tylerwhite26/ECE_455_Brain_Stimulator/Final_Report/Figures/thumbnail_IMG_1129.jpg

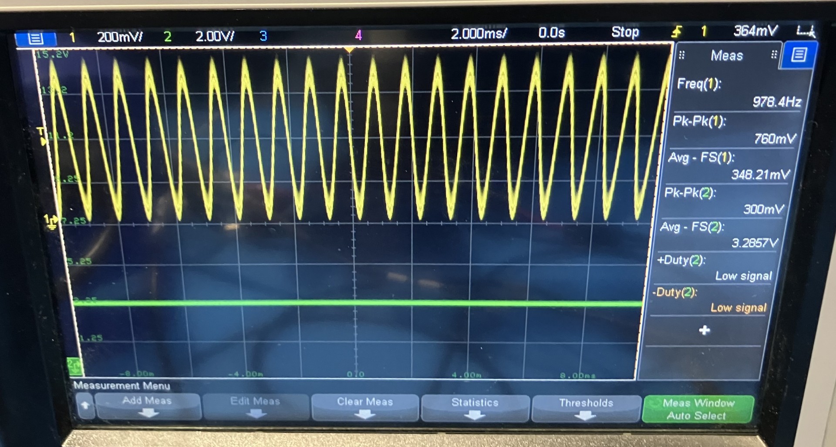
Final_Report/Figures/thumbnail_IMG_1129.jpg
