tylerwhite26/ECE_455_Brain_Stimulator/Final_Report/Hardware_Pics/3D_Annotate.png

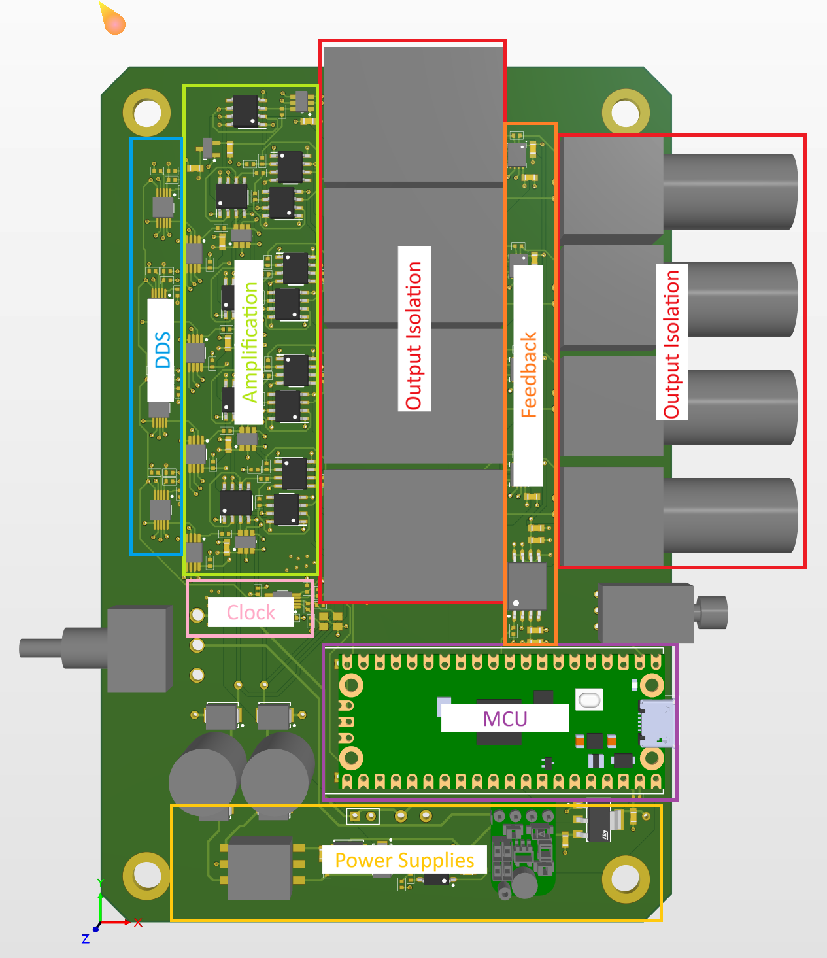
Final_Report/Hardware_Pics/3D_Annotate.png
