tylerwhite26/ECE_455_Brain_Stimulator/README.md

# ECE_455_Briain_Stimulator
Deep brain stimulator wave generator
