tylerwhite26/ECE_455_Brain_Stimulator/Final_Report/Tyler_Contributions.docx

Operating Instructions

Operation of the brain stimulator has been distilled down to only require two switches and the mobile app. The toggle switch serves as a power enable and hard kill switch, and the push toggle serves as the stimulation enable and ramp control.

To program the device, first turn the power on using the hard kill switch. Ensure the push toggle remains off (out). Connect to the device on the mobile app by pressing the “connect device” button. If connection is successful, the button will read “Connected” and turn green. During device selection on the mobile app, choose the device labeled “mpy-uart.” Once connected to the device, use the text boxes to select the desired channel frequencies. All channels are in units of hertz. As frequencies are chosen, beat frequencies will be calculated automatically and displayed on screen. Once all desired frequencies are present, press the “Program Device” button and wait for control to return. All frequencies programmed the device are written out to nonvolatile memory, and should persist between power cycles. At the completion of programming, the device is ready to generate stimulus.

To begin stimulus generation, ensure the device has been powered on using the hard kill switch, and then press and release the soft kill toggle button. It will latch in to show the stimulus is on. Once the stimulus has been turned on, it will ramp the output over a few seconds. There is not currently functionality for selecting amplitude on the mobile app, and it will be hard-coded into the software. Future releases should address this problem. To stop stimulation, press and release the soft kill switch again, causing the stimulus to ramp down over a few seconds back to zero. In the case of emergency, instead cut power using the hard kill switch. Note that a hard kill while stimulus is active may cause pain or discomfort to the patient.

Output channels go as an output and return pair at each BNC connector. These should be connected to electrodes to stimulate the brain. It is outside the scope of this project to determine electrode placement.

To change the software on the device, it must be disassembled and the main circuit board removed. Connect to the raspberry pi using USB-micro and reprogram. This port is kept intentionally concealed for normal operation to prevent tampering.

Hardware Selection

The main concerns for hardware selection are isolation, power dissipation, and max ratings. The output loops consist of a transformer, which is large to be tolerant up to 0.15 W power, and feedback ADCs. These ADCs isolate the analog and digital domains and are powered from an isolating 3.3 V supply so that the output loop does not reference to on board ground. This is done for signal integrity. The voltage feeding into these ADCs is over 10 ohm resistors, which have been sourced to be tolerant to up to 1 W.

Feeding into the output transformers are voltage controlled current sources consisting of two op-amps. These step up from the 5 V domain to the 30 V domain, and so are tolerant of input voltages well over 30 V. Resistors for these op-amps again need to be rated for very high power dissipation because current will be forced. Amplification stages leading into the current source consist of programmable resistor dividers feeding into buffers, which ensures signal fidelity and allows an easy way to control attenuation from the microcontroller. The source of sine wave generation is the DDS modules. Originally it was desired to use one DDS for all channels, but instead four smaller DDS modules are used to save money and space. They generate sine waves in the 2.5 or 3.3 V domain, which needs to then be stepped up to the 5 V domain using programmable gain amplifiers. These specifications lead to components in the amplification path being mostly buffer op-amps and programmable resistors that are all tolerant up to 5 V.

As the brains of the device, a raspberry pi pico has been chosen. Since we have broken out generation to DDS’s, the microcontroller only needs to communicate with peripheral devices. This means that it can be a simpler microcontroller, which also has Bluetooth to connect to the mobile app. Another motivation for choosing this microcontroller approach is that resources for writing software for raspberry pi are readily available, making iteration by researchers that may not know all the intricacies of the device easier.

To power the device, we have a rechargeable 3.6 V battery and charging board. We bought both of these pre-made. The main goal was to have something lightweight that is easily rechargeable, but at present the battery does not have enough capacity to generate stimulus for 16 hours. In the future, this component will need to be changed.

For generating high voltage on-board rails, there is both a 12 V and 30 V boost converter. The 12 V boost converter was again bought premade, but after testing will not source enough current for the device to operate. Future versions should source a better boost converter or go full custom. The 30 V boost converter was custom designed using a flyback converter. This converter, from our initial testing, draws a large amount of current at startup and may not be viable if attached directly to the 12 V boost converter. Further testing using the flyback breakout board on both the boost converter and voltage supply chain is necessary. The transformer currently used is also a concern.

Switches and connectors were the final components sourced. BNC connectors are used for the output channels. The goal of these connectors is to allow connection and disconnection of electrodes without soldering, while still providing an electrical connection that isn’t going to pull out and cause discomfort for the patient. The hard kill is a toggle switch to also function as a power on switch, but may be too easy to bump and kill the device. Future iterations should look into alternative hard kill switches. The soft kill switch is a push toggle button, which is smaller profile and gives a clear visual indication of whether stimulus is on.

Future Work

The biggest shortcoming of this device was the power supply circuitry. Specifically, the battery was too small and the boost converters did not function as intended.

Any new battery chosen should take into account the constant current draw of the boost converters, so that the device can reliably last 16 hours. Power calculations on the current board did not properly account for these converters. The boost converters themselves were mismatched; the 12 V boost supplied too little current, and the 30 V boost drew too much current. In the future, the best course of action is likely to go full custom with the 12 V boost converter in a similar fashion to the 30 V converter. This way, battery voltage can be directly connected to the 12 V converter, and the board powered from there. Another power issue was that the 5 V LDO could not thermally keep up with the load. Either a much bigger LDO or a different method of generating 5 V should be chosen in the future. Breaking out the power system into separate boards will allow faster debug and rework of these sections.

Another piece of future work is on the software side. The hardware will allow amplitude control through the amplifier stages, but there is currently no way to program the amplitude to the device. The mobile app and device software should be modified to allow for amplitude control. Due to the routing of the control signals, all channels currently ramp together. If it is desired to ramp these separately or set different amplitudes between channels, each amplifier will need individual routing, but the programmable gain amplifier can be removed.

Along with this, the on-board clock generator is too high a frequency to get good resolution from the DDS ICs. Either finding new DDSs or a new clock generator is necessary to achieve clarity to the level of individual hertz. The alternative is to program the clock generator for minimum frequency. A register-level value array is provided in the project source files for setting 100 kHz.

Physical dimensions end up being a limiting factor in the design of the brain stimulator. The device is too big to be reasonably handheld. In the future, pivoting away from large transformers on the output and finding alternative methods of output isolation will allow the footprint to shrink. Along with this, BNC outputs take up considerable space. Changing these out for hardwired electrodes or a different connector will allow the design to shrink further. Adding a belt clip to the back of the housing was an idea discussed but not implemented, which would make the device easier to carry for the patient. A final change on the physical dimension side is finding a new hard kill switch. It is hard to strike a balance between something that is accessible but can’t be accidentally switched off, as the toggle switch may be.

Overall, more extensive testing on board subcircuits needs to be performed. More breakout boards and small scale testing would give us reliable results to back up our simulations.

Hardware/Circuit Schematics (3 and 5)


Figure A shows the 3D layout of the PCB. It is divided into power supplies, MCU, clock, DDS, amplification, output isolation, and feedback. Horizontally each channel and its amplification stages are laid out in layers across the top of the board. The battery connects to headers directly below the MCU, and the 12 V boost converter, which is premade, attaches to the 4-pin footprint as shown.

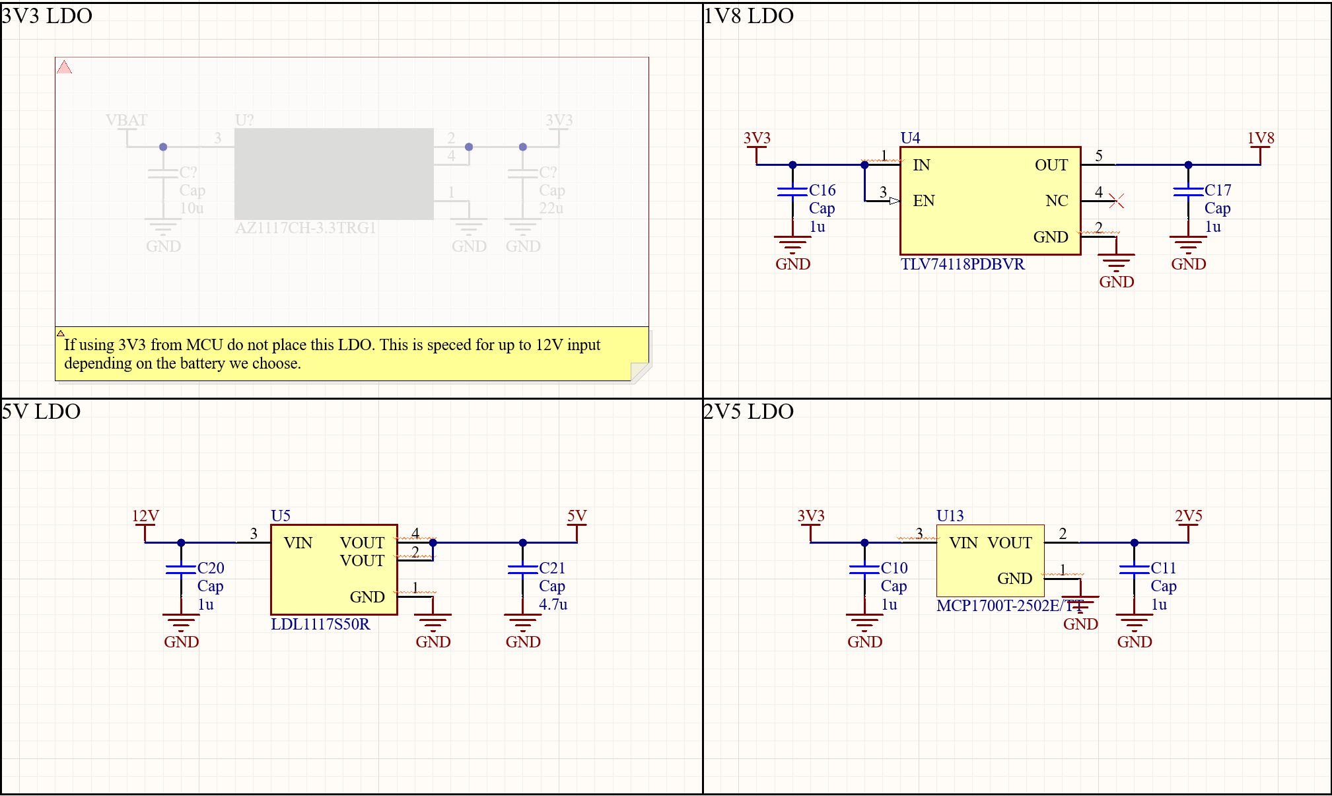
[picture p3: figure]

Figure B shows a schematic level view of the LDOs on-board. The 3.3 V LDO is optionally excluded, as the MCU will generate 3.3 V. 5 V feeds into the MCU, and 2.5 V is used for midpoint selection of the voltage controlled current source, explained later.

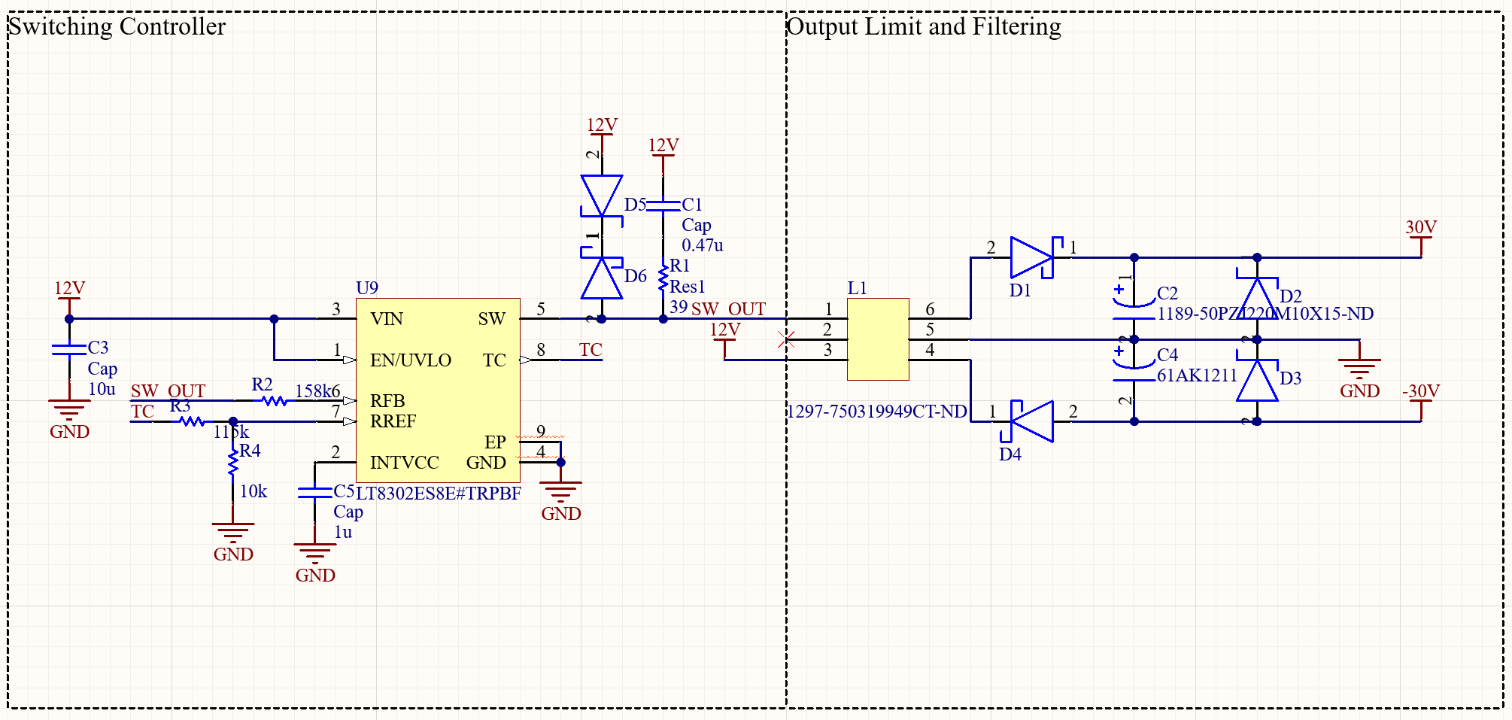
[picture p4: figure]

Figure C shows the 30 V flyback converter. It is divided into the switching controller in the 12 V domain and output filtering in the 30 V domain. The switching controller drives current on one direction through the transformer, which then uses Zener diodes on the secondary to generate a stable 30 V positive and negative rail at the output.

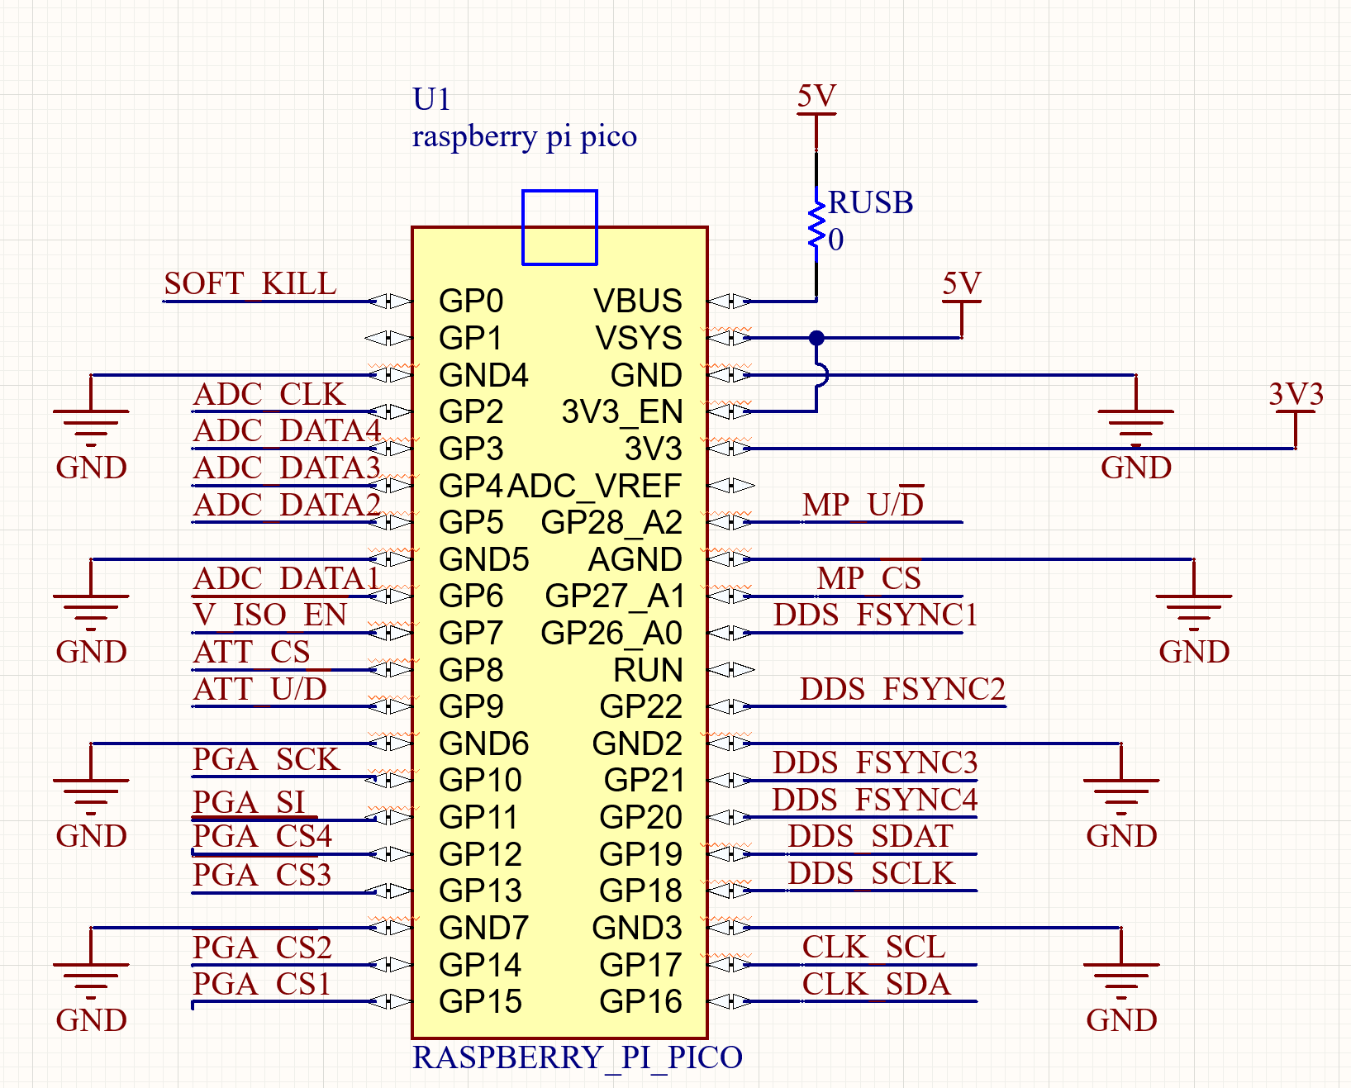
[picture p5: figure]

Figure D shows MCU connections. The main role of the MCU is to communicate with and program peripherals. To do this, it makes use of SPI, I2C, and custom up/down protocols. This MCU is the Raspberry Pi Pico, and can generate 3.3 V output for the rest of the board. The USB port of the MCU is hidden when in the housing so that it cannot be reprogrammed without taking it apart.

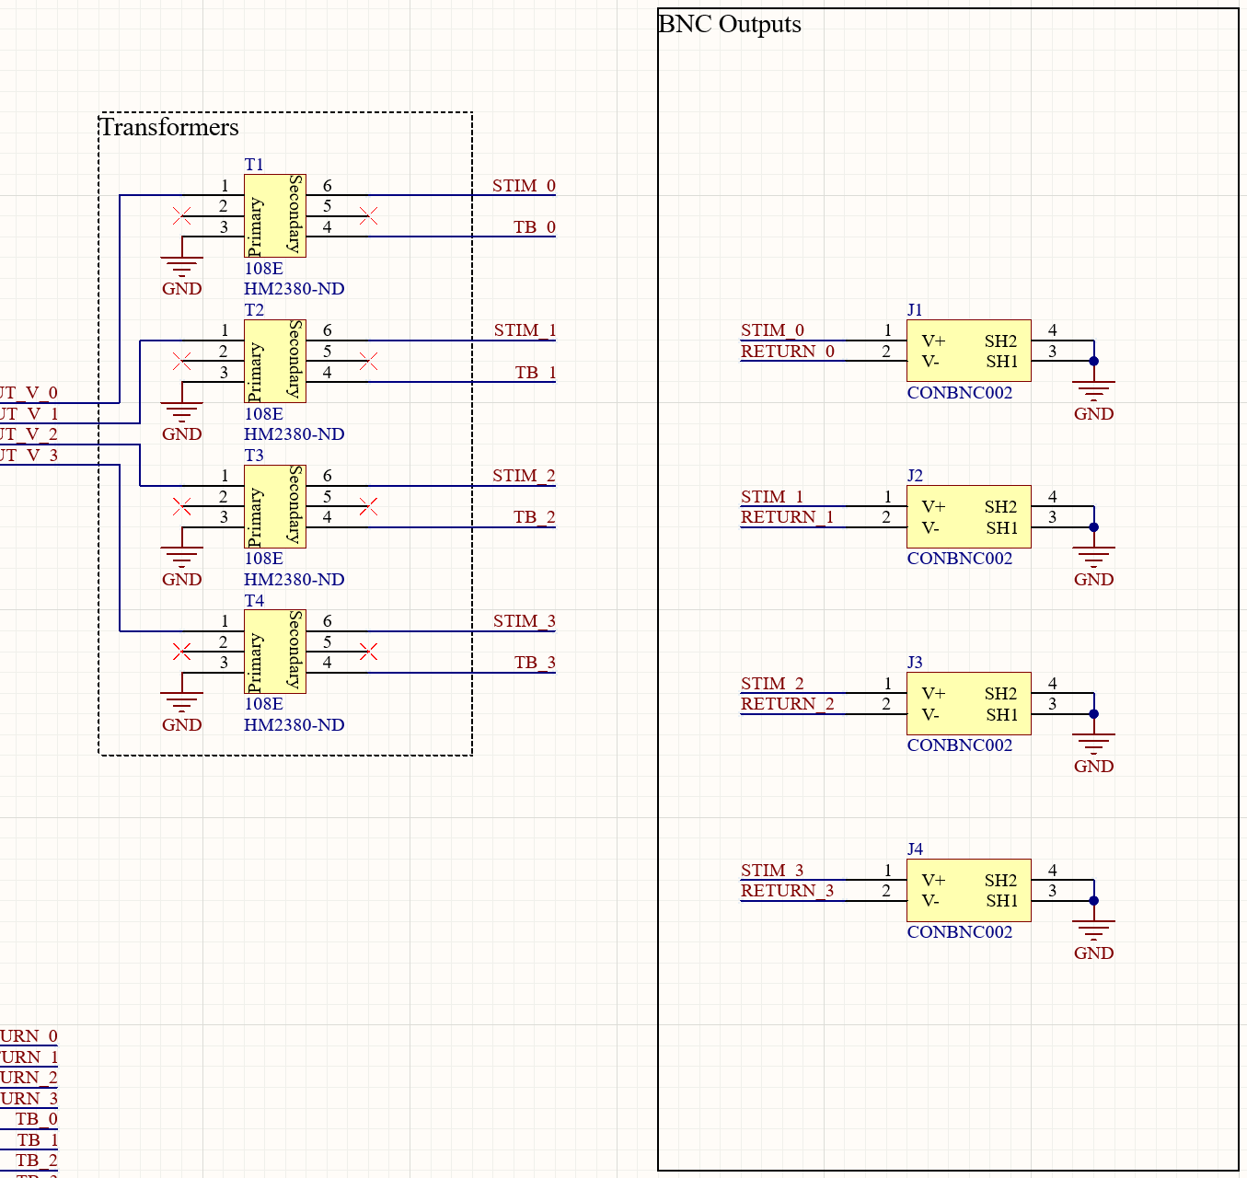
[picture p6: figure]

Figure E shows the isolation transformers and BNC outputs. These transformers are the biggest components on the board, responsible for isolating the current sources without dropping significant current. The transformers feed the signal into the BNC ports to connect to the electrodes. This signal then comes back through the ADCs and into the transformer.

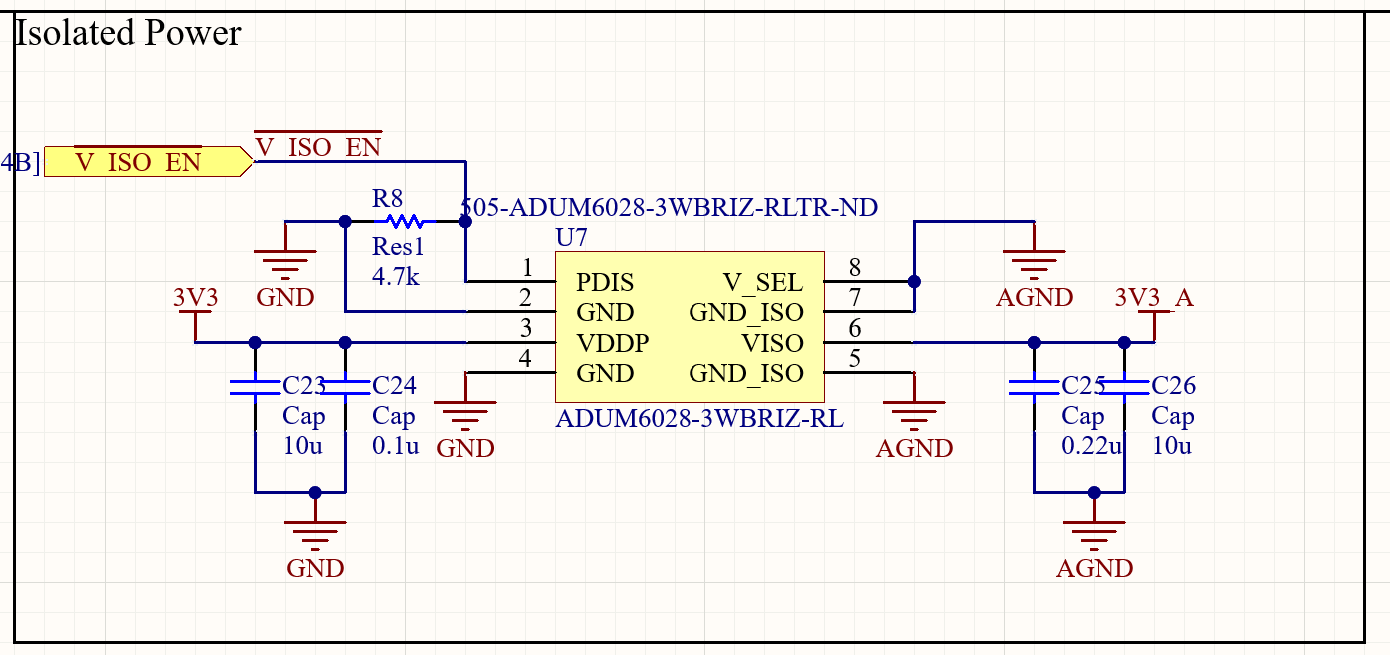
[picture p7: figure]

Figure F shows the isolated 3.3 V power supply. This supply is used for the analog domain of the ADCs so that they do not reference the on-board ground. This way, generated stimulus does not interfere between channels.

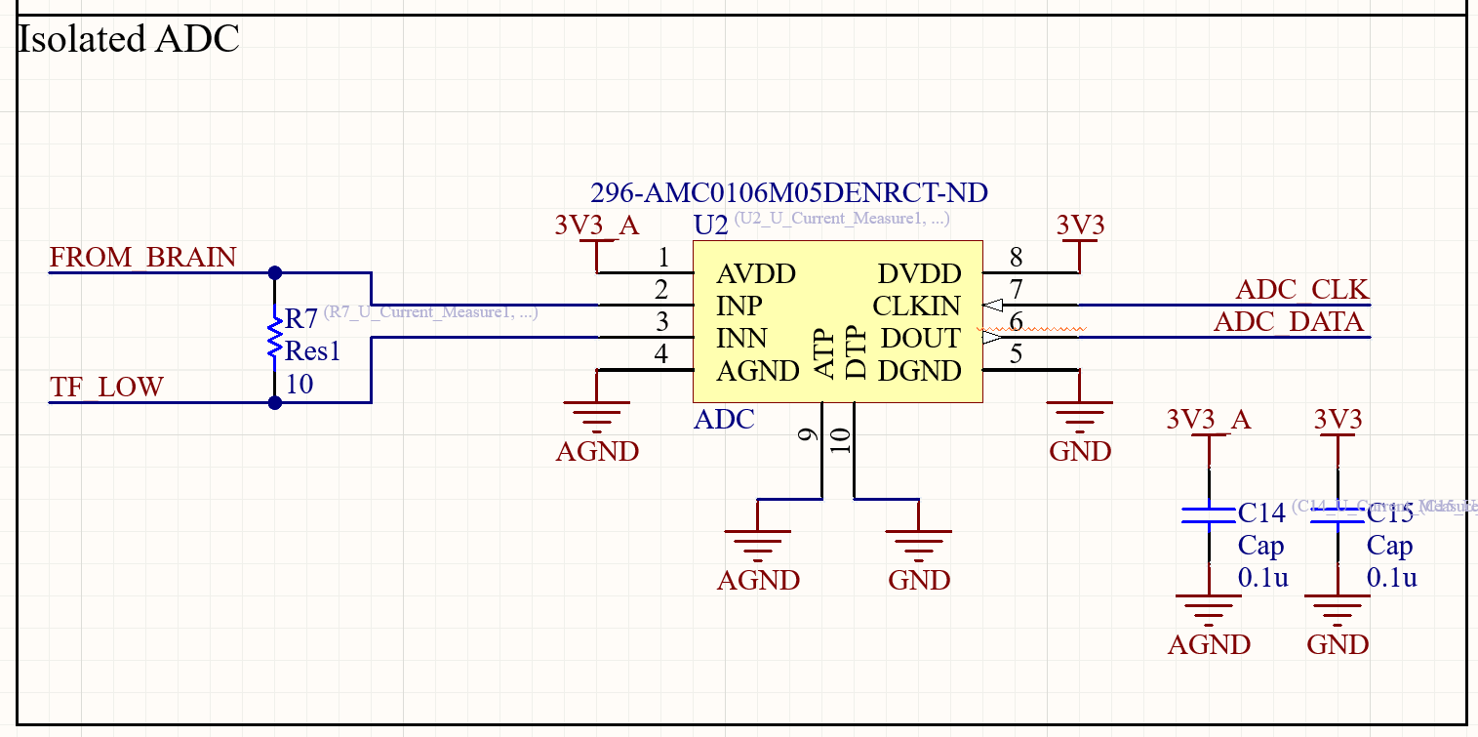
[picture p8: figure]

Figure G shows one of the isolating ADCs. The analog and digital domains have separate grounds, so that the MCU can read out the voltage across the resistor. This voltage is used to calculate current so that the current source control can be adjusted to the correct amplitude. This ADC stage is necessary because of the use of transformers for isolation.

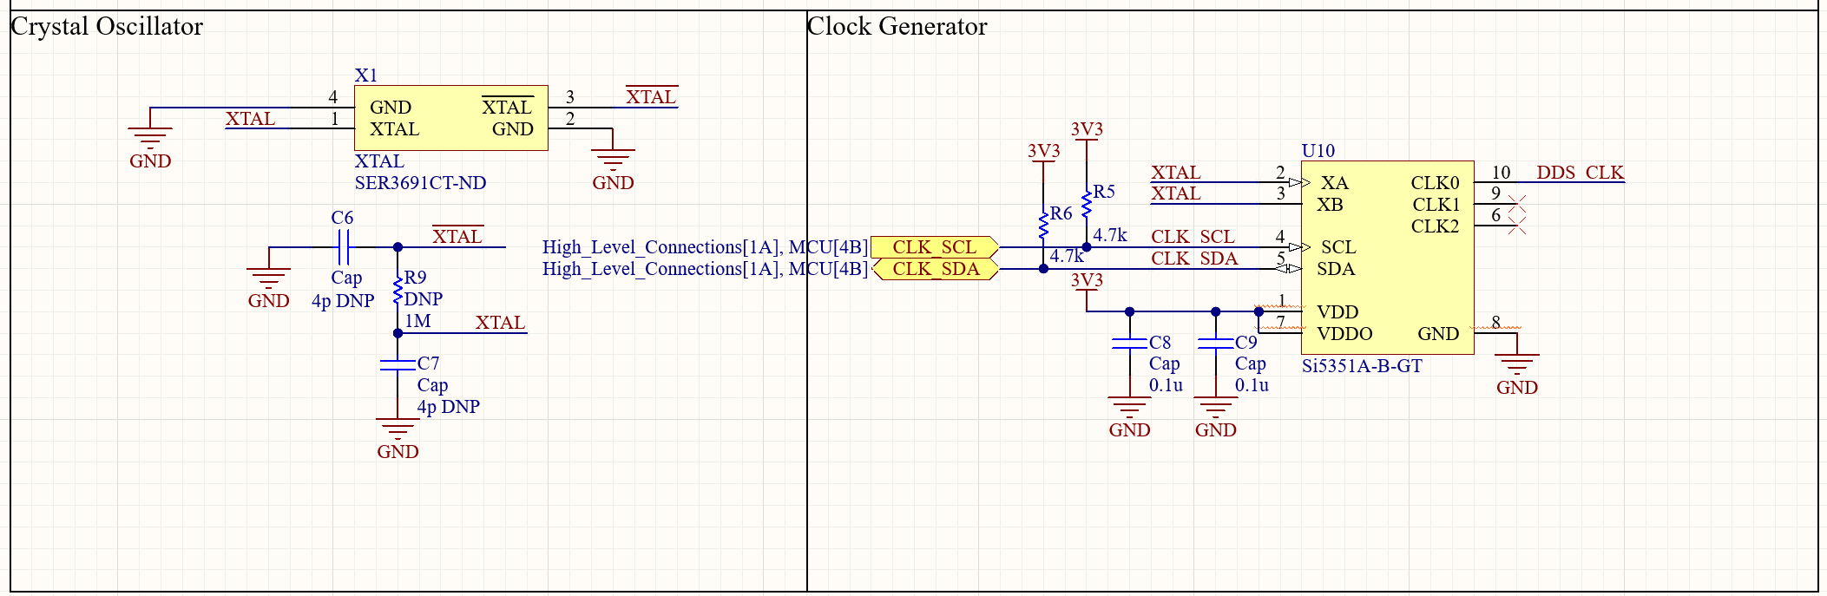
[picture p9: figure]

Figure H shows the schematic view of the clock generator. This generator utilizes a programmable clock divider and 25 MHz crystal to output up to three clocks, although only one is used. This clock generator need only be programmed once at power up and then left alone. It feeds into the DDS ICs so that they can derive their phase and frequency data from a common source.

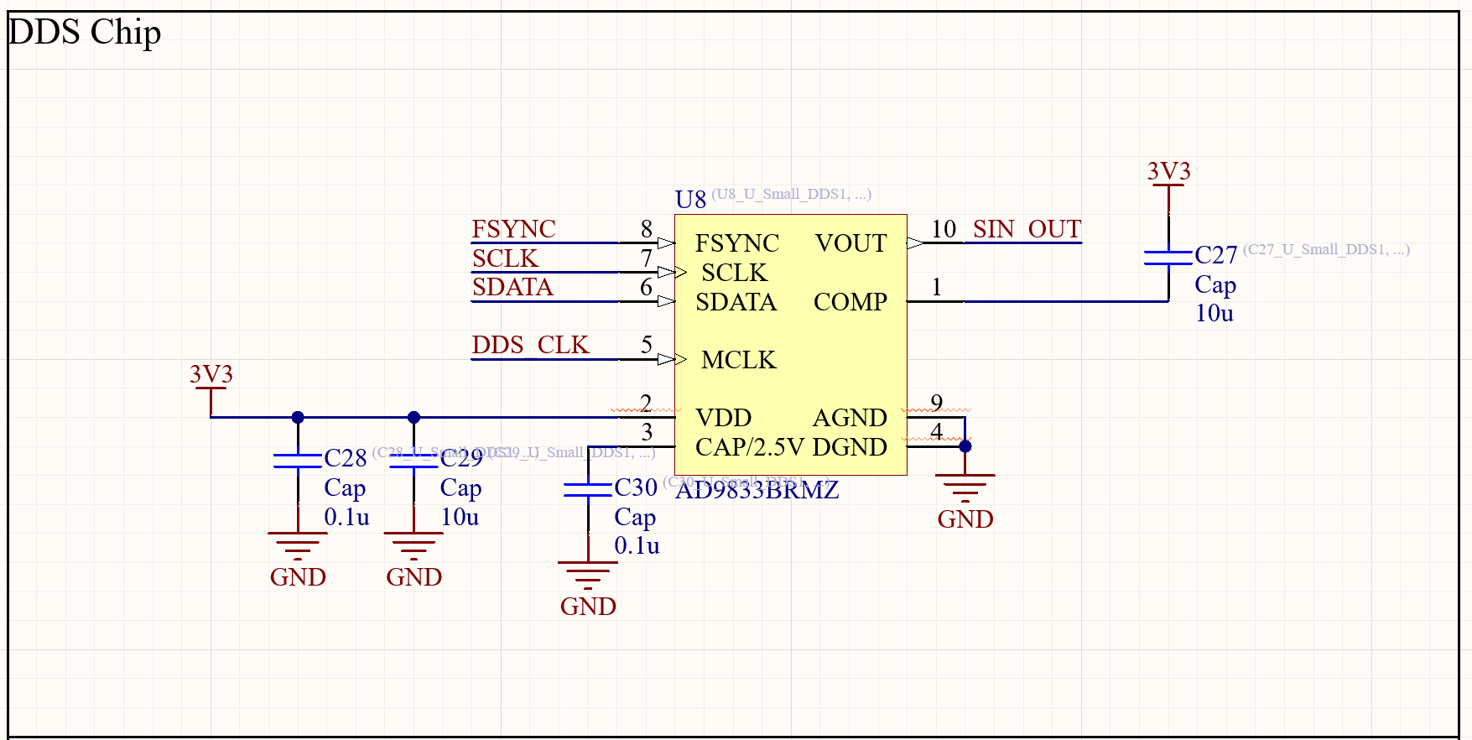
[picture p10: figure]

Figure I shows the schematic of a DDS. This is used to generate a sine wave that can go through amplification. Frequency and phase offset are programmed by the MCU. To synchronize with other DDSs, the reset must be released on all of them at the same time so that phase information is accurate. Along with sine waves, the DDS used is capable of generating sawtooth waves. However, there is no triangle or square wave support.

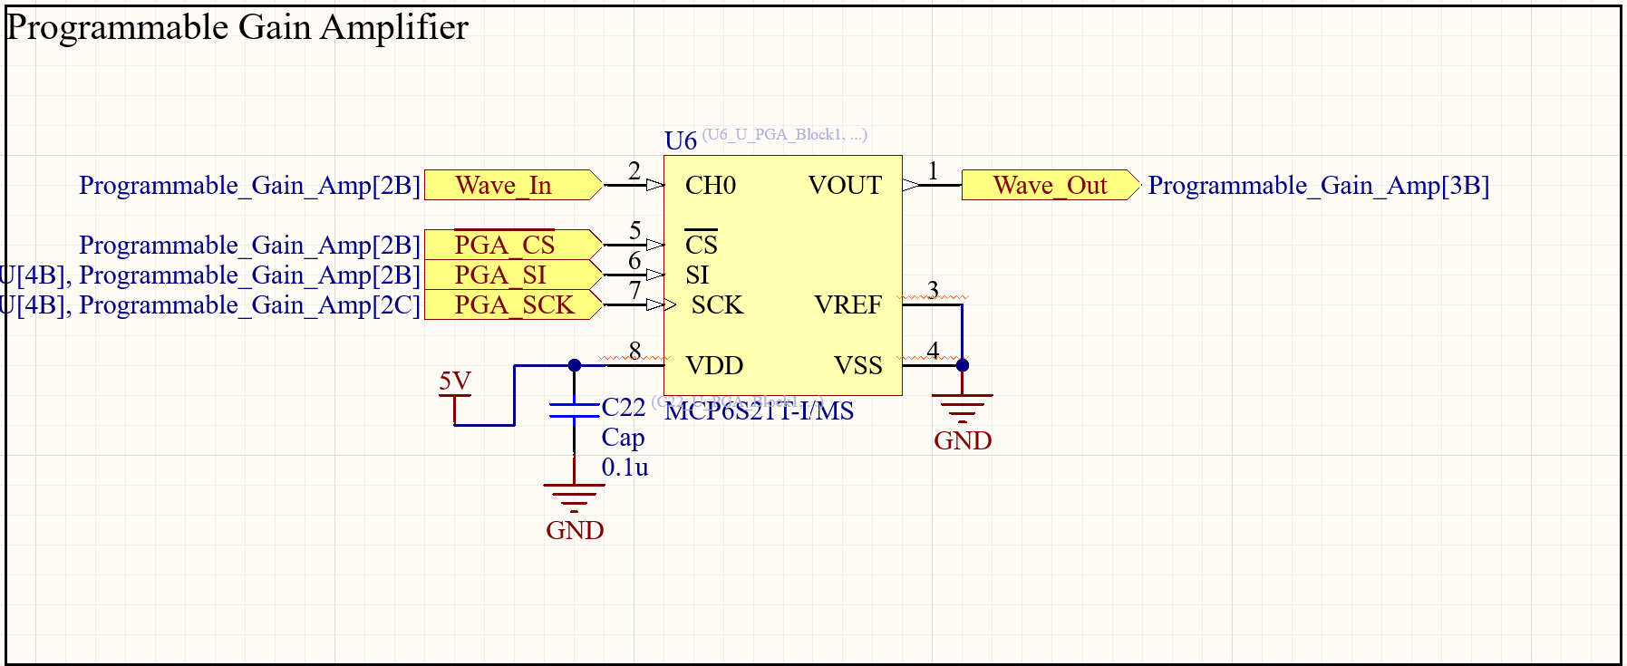
[picture p11: figure]

Figure J is the first amplification stage, a programmable gain amplifier. For general operation, this is set to 2 V/V gain to step from the 2.5 V domain to the 5 V domain. It may also be set to 1 V/V for more fine grain tuning at smaller amplitudes. Output from this amplifier is fed to the adjustable resistor divider.

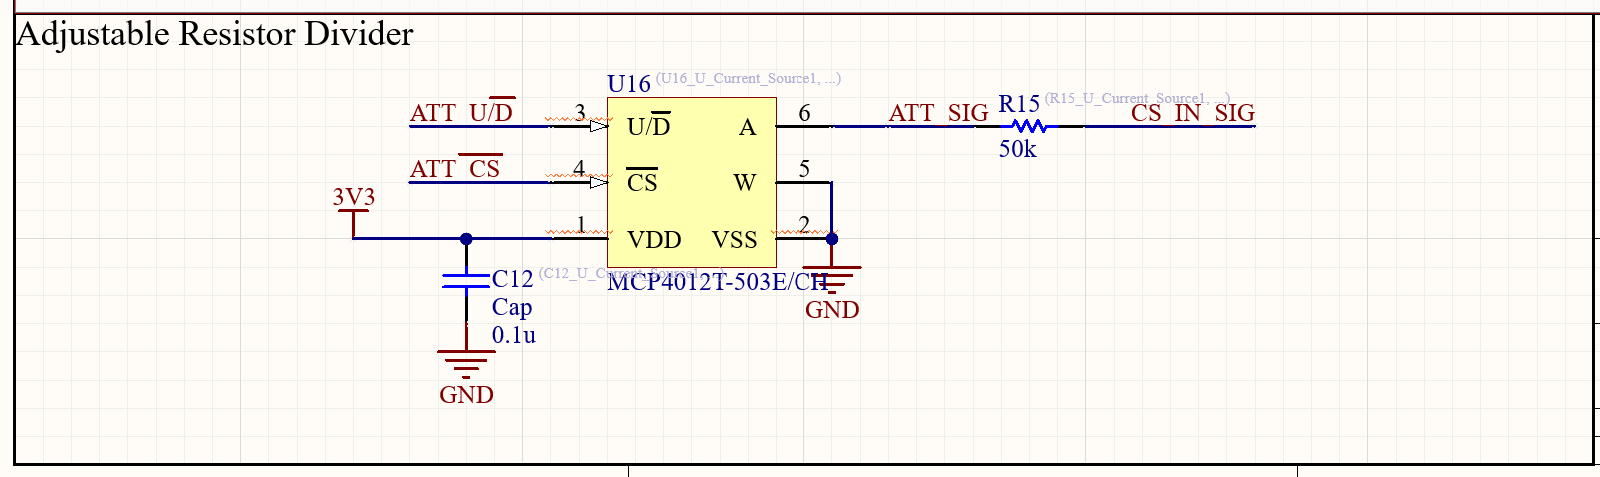
[picture p12: figure]

Figure K shows the second amplification stage, an adjustable resistor divider. At startup the adjustable resistor to ground is set to nearly 0 ohms, so that even if the DDS produces output it is attenuated hard to nothing. Using the up/down interface, the resistance can be slowly increased by the MCU, so that the amplitude of the sine wave gradually increases and does not step up at startup. At maximum, the resistor divider multiplies the signal by one half. Not shown is the buffer after this resistor divider, which ensures later stages do not feed back into it and affect the math of the attenuation.

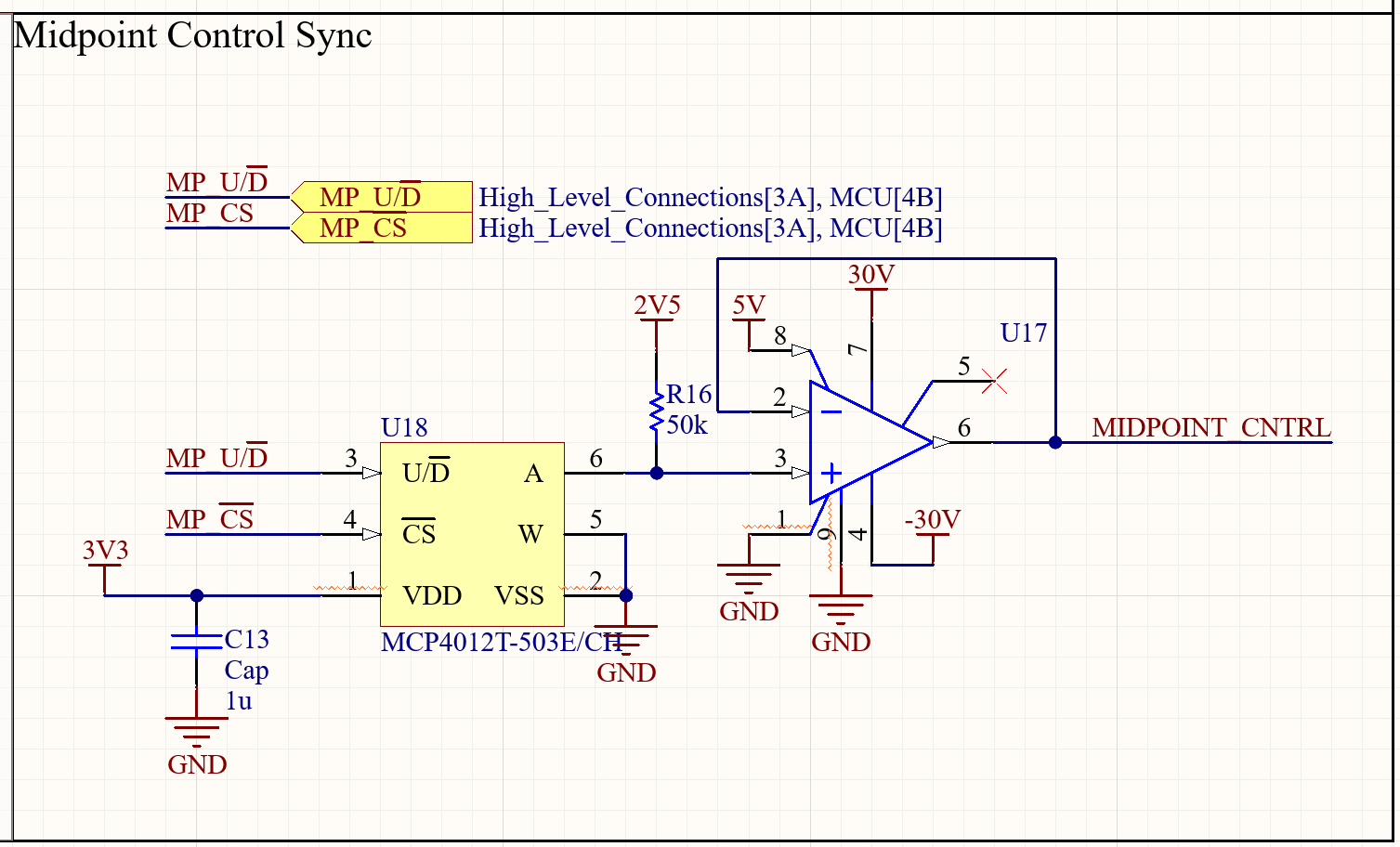
[picture p13: figure]

Figure L shows another adjustable resistor divider for midpoint control, which will be explained later. This should generally be set all the way down at startup and increased in equal increments to the amplification resistor divider. The components are selected such that if the resistance of the amplification divider and this one are equal, the output of the midpoint select will be the center of the sine wave being generated. This is important for the voltage-controlled current source.

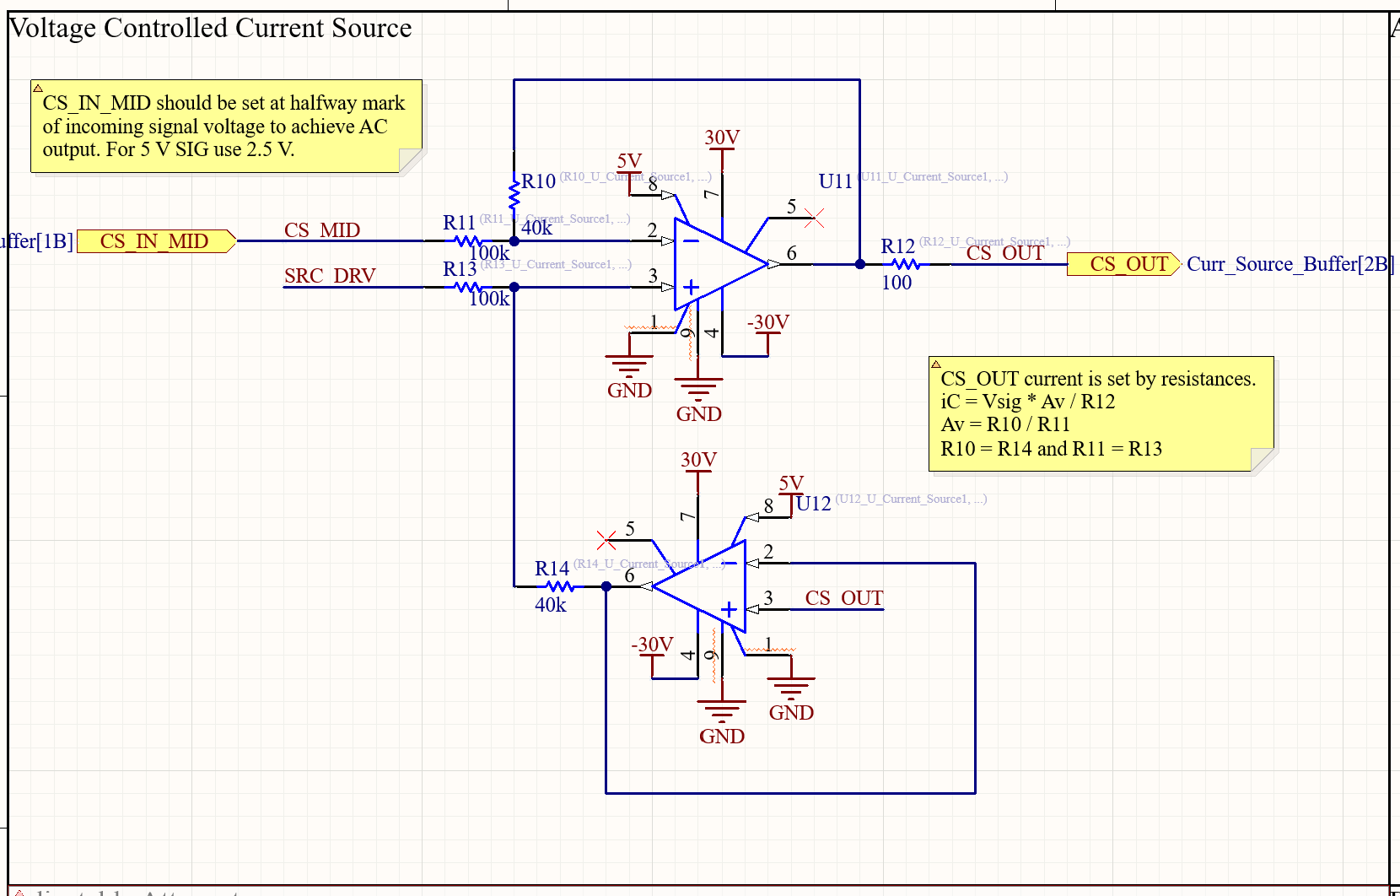
[picture p14: figure]

Figure M shows the final stage of the signal amplification, the conversion from voltage to current domain. By feeding two op-amps into each other, the voltage across R12 is precisely controlled and thus the output current. Because a positive and negative current waveform is desired but only a positive voltage domain sine wave is fed in, the midpoint of the signal is used to set the zero point of the output current. The output of the current source must be sunk to ground for the current to have a route to travel, and in this case, it is fed into the output transformer. The op-amps at this stage use the 30 V rails, which is the maximum allowable voltage that the device should generate. The equations governing operation of the current source are shown on the schematic.

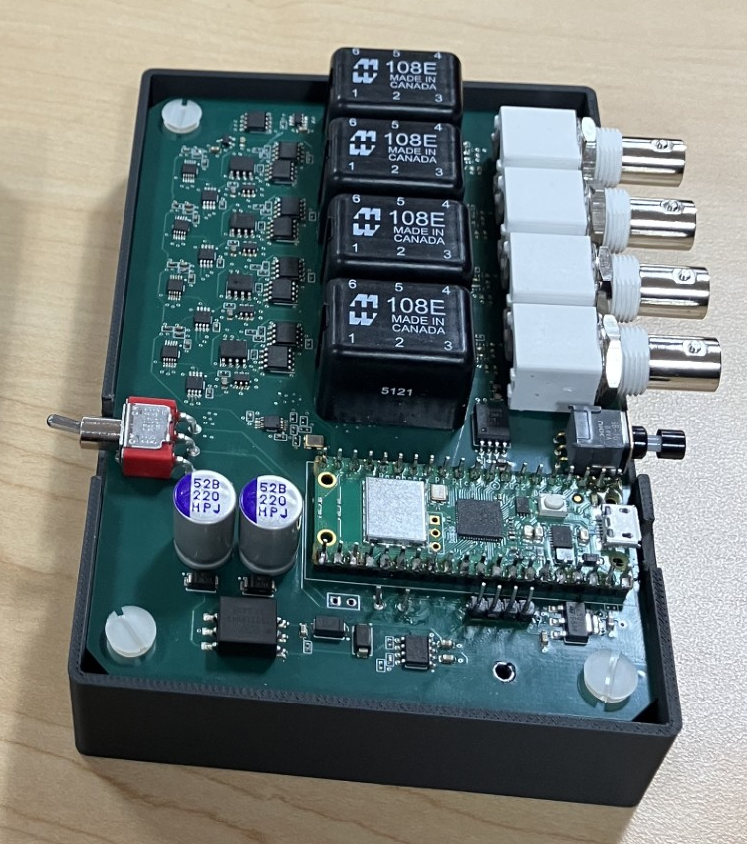
[picture p15: figure]

Figure N shows the final assembled board. The housing is 3D printed to the dimensions of the board. Underneath the board is stored the rechargeable battery. On the right side are the output ports and soft kill button, and on the left side is the hard kill switch. The dimensions of the final assembly are roughly 3.5”x5.25”x1.5”, not including the output ports. The casing includes a top to completely hide the circuit board.
