tylerwhite26/ECE_455_Brain_Stimulator/Presentations/Week_12_Presentation.pptx

## Samad, Guandong, and Tyler

- Brain Stimulator Progress Update

## Problem Description

Make a device that can generate waveforms of precise frequency and current to stimulate deep parts of the brain using electrodes.

## Key Events from Last Week

- Got flyback and iso-adc breakout boards
- Made final amplifier stages
- Made voltage controlled current source circuitry
- Did first pass final board placement

## Block Diagram


## Schematic Updates

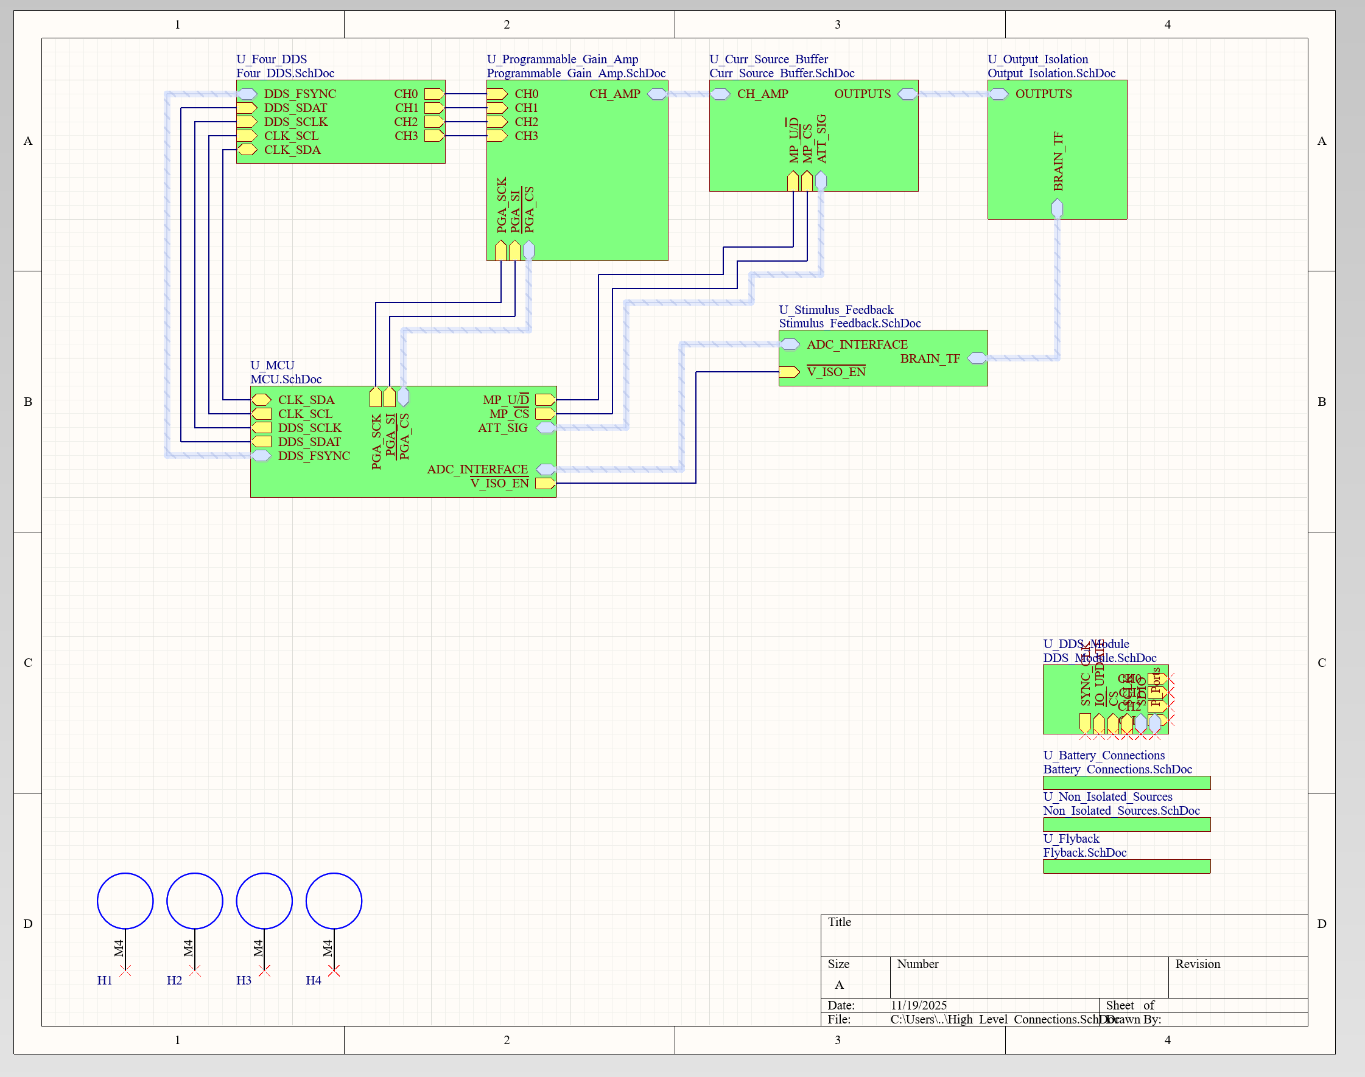
[picture p19: figure]

## Schematic Updates Continued

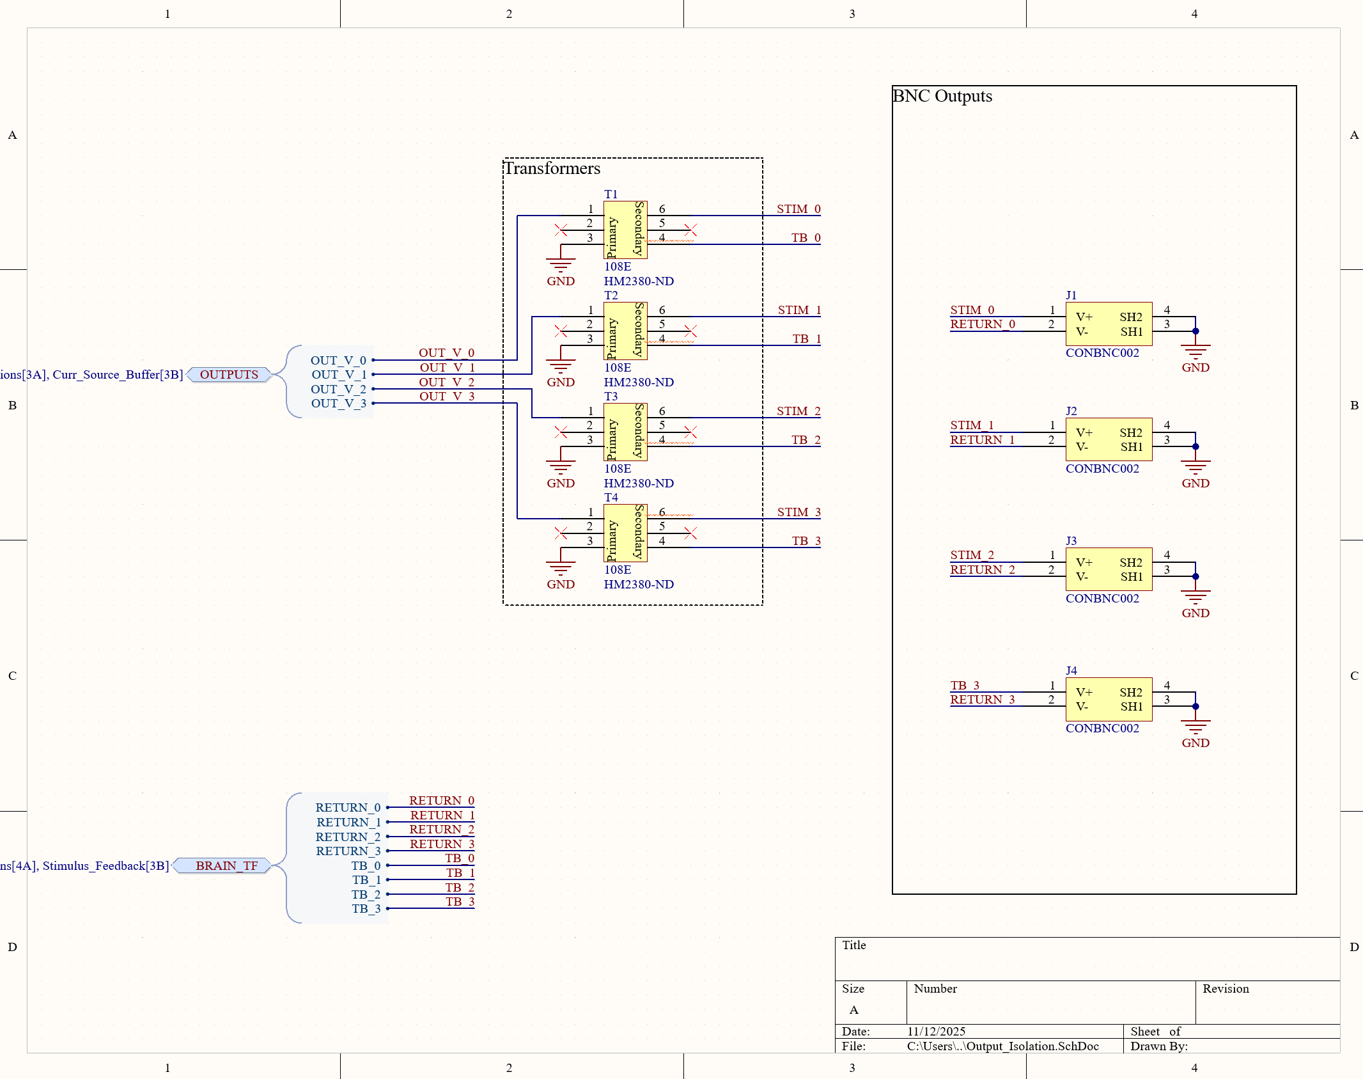
[picture p20: figure]
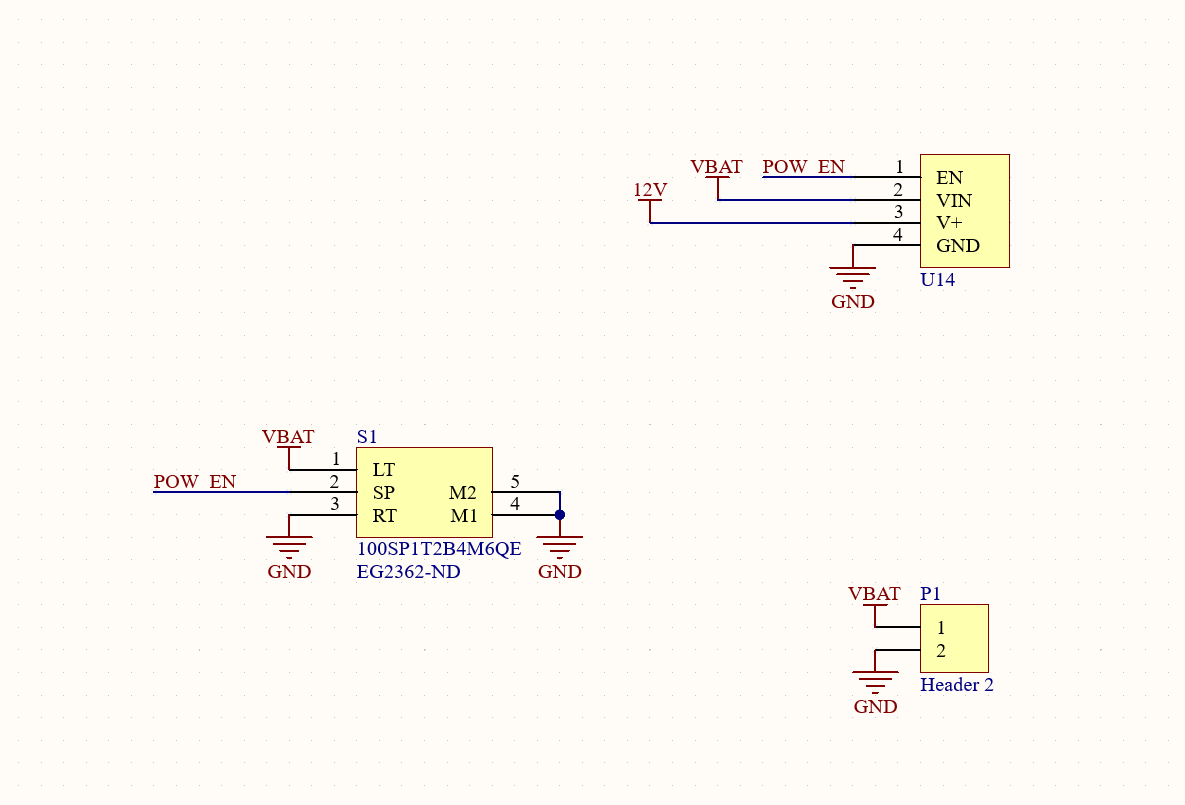
[picture p21: figure]

## Kill Switch

- Cut off 12V enable because otherwise the switching regulators will be on and incur losses
- Comes at the price of powering down MCU
- Soft kill is currently done through software. Ideally will add button but need to find space.

## Switch from Audio Jack to BNC

- More robust
- Downside is size

## Current Source

- Use a midpoint offset to turn 0-5 V sine wave into a -5-5 mA current source
- Tight tolerance resistor which has the voltage across it controlled such that current is known

## Schematic Updates Continued

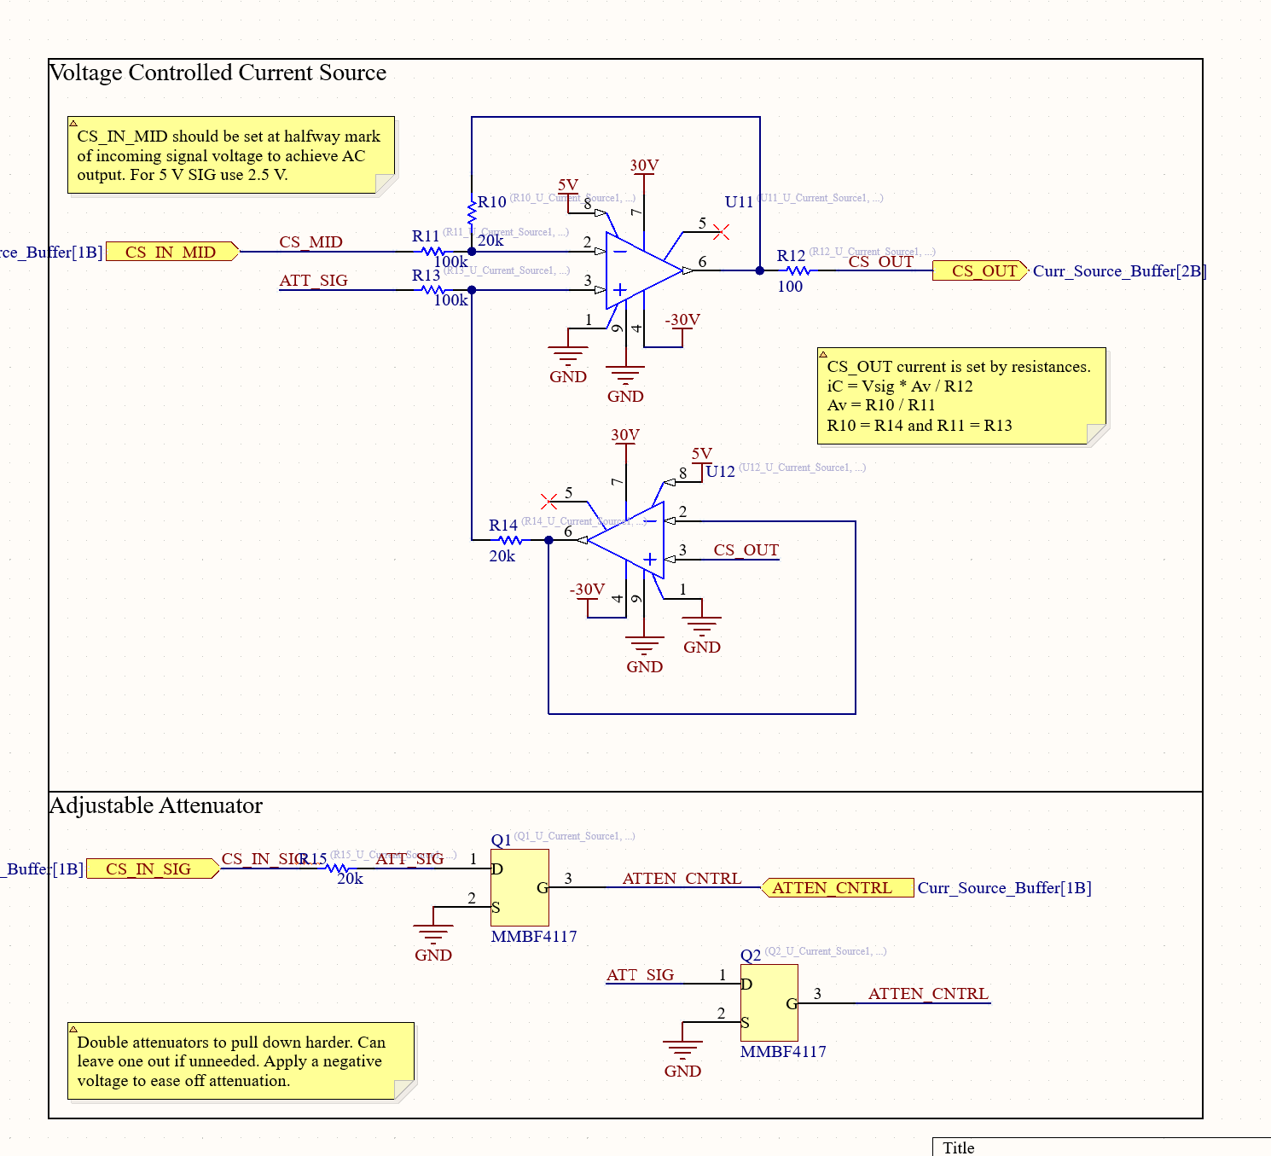
[picture p22: figure]

## Current Source Simulation

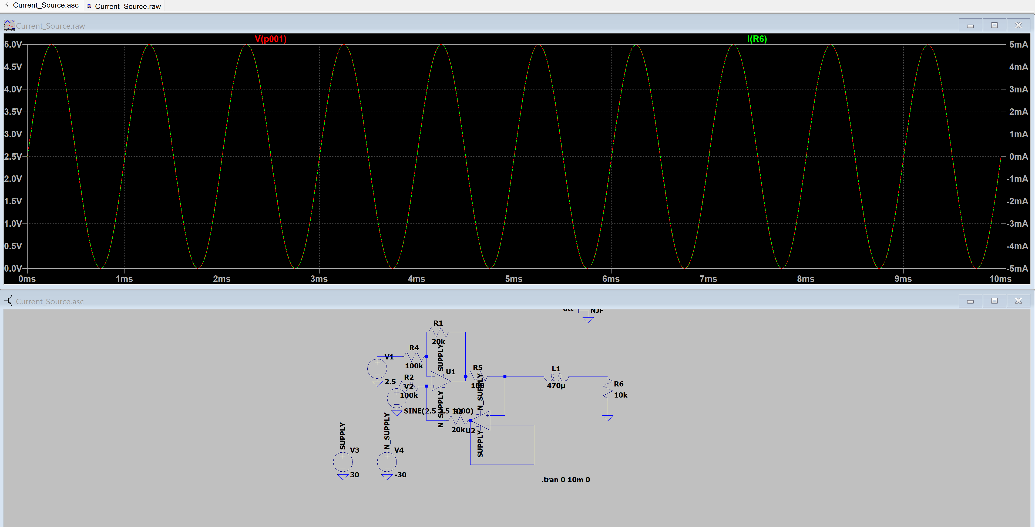
[picture p23: figure]

## Schematic Updates Continued

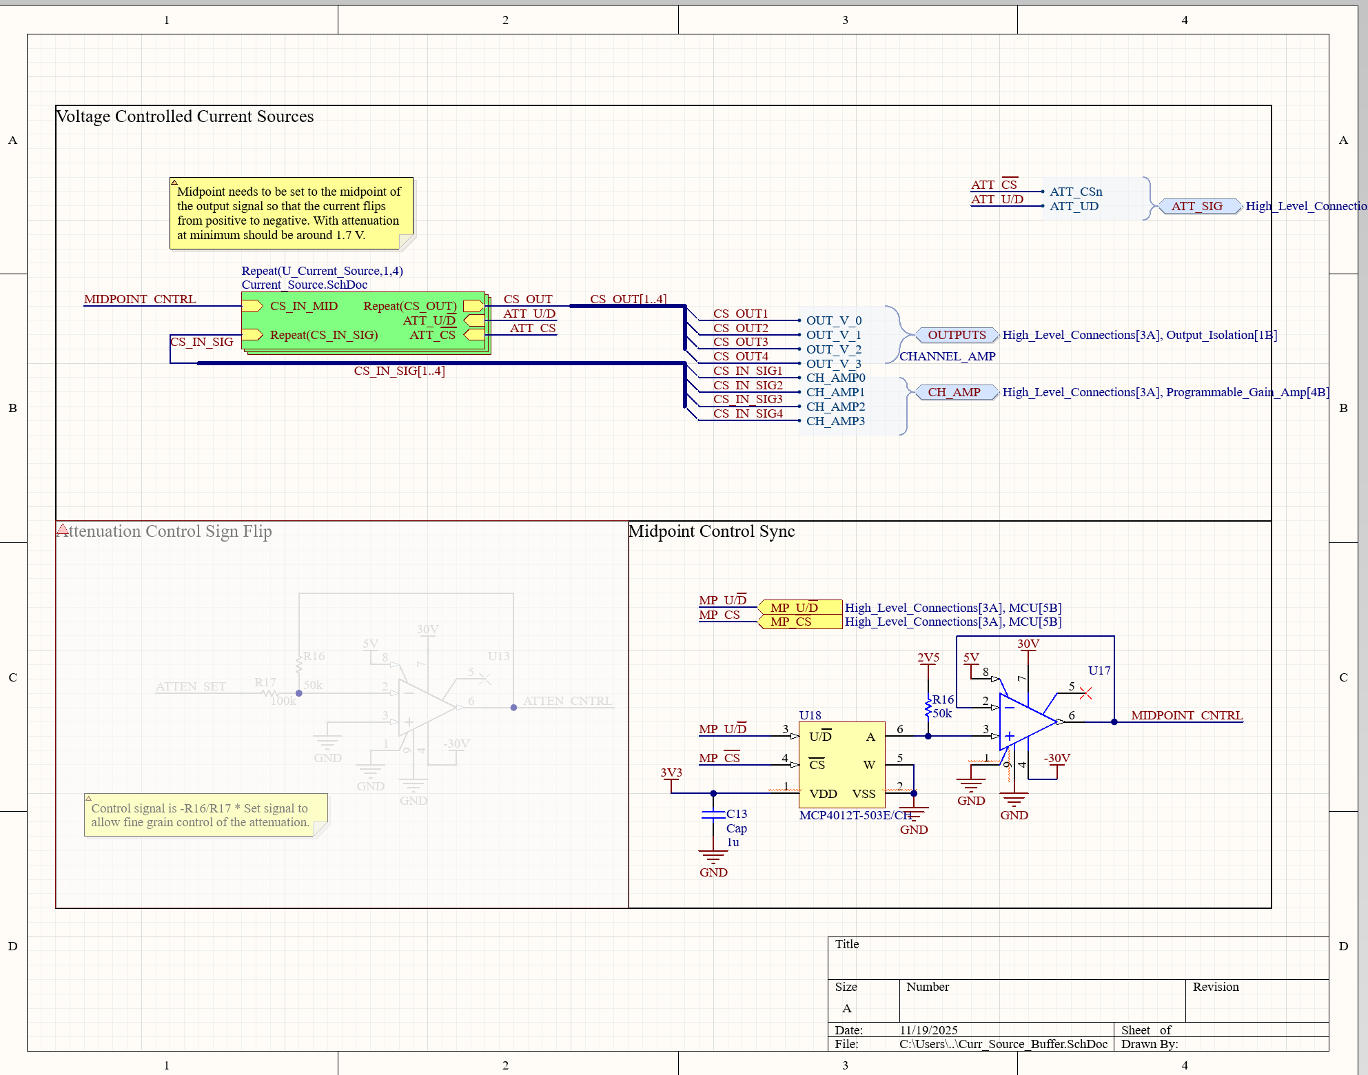
[picture p24: figure]
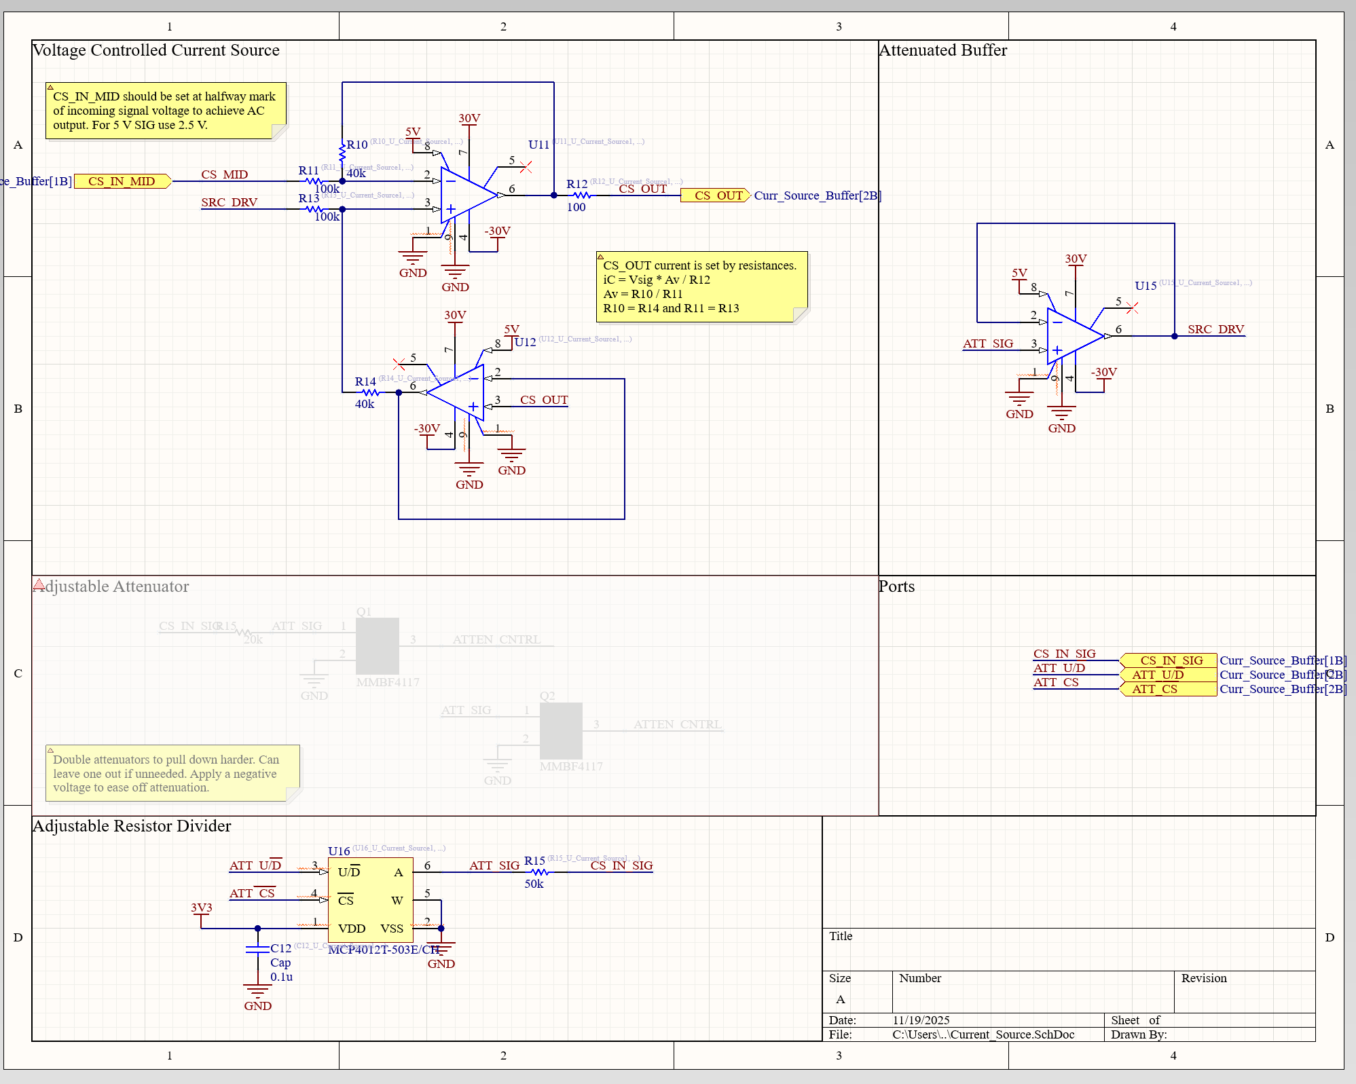
[picture p25: figure]

## Flyback Converter

- Get +/-30 V rails
- Incur some losses from two switching converters, almost unavoidable
- Feed into final amplifier stage

## Schematic Updates Continued

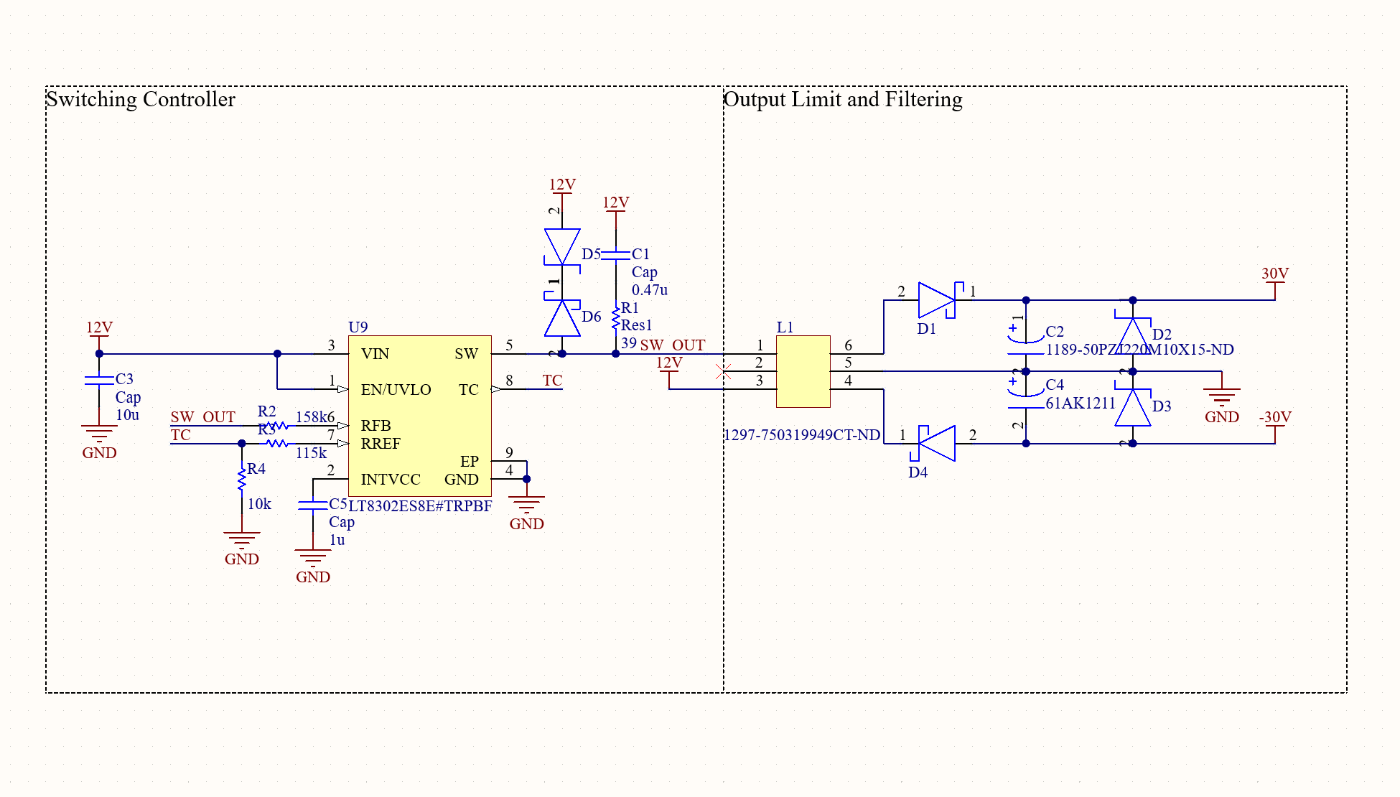
[picture p26: figure]

## Schematic Updates Continued

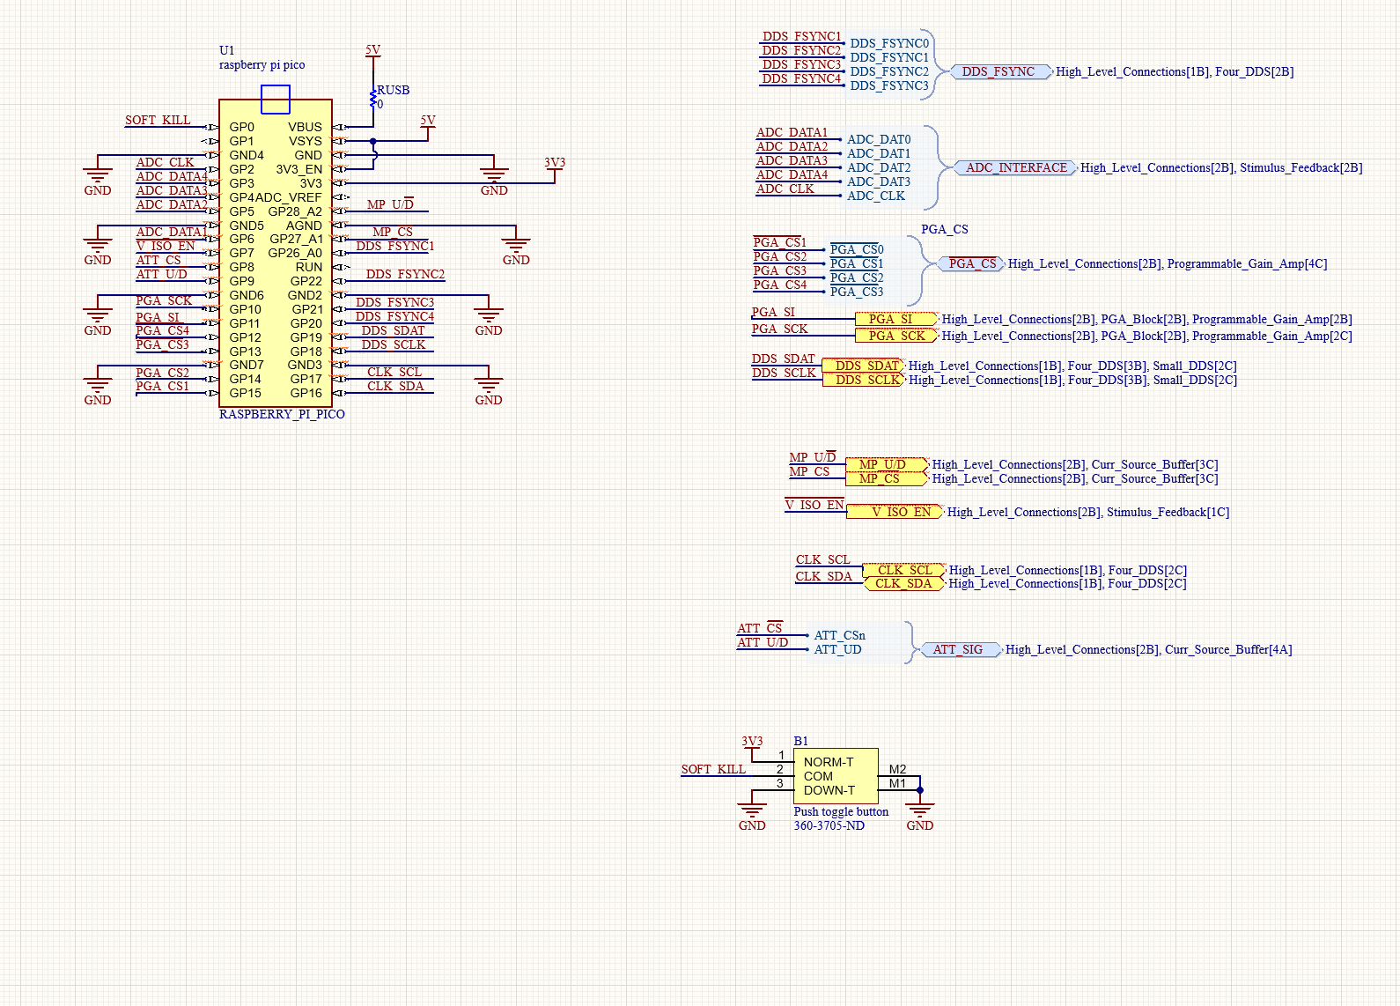
[picture p27: figure]

## Final Board Placement

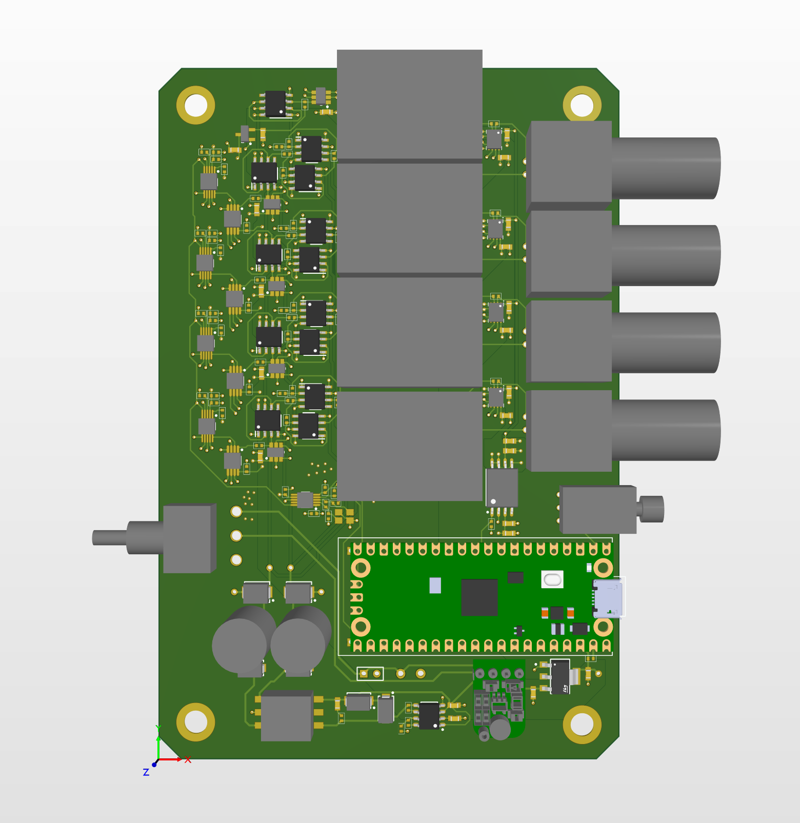
[picture p28: figure]

## Other Components

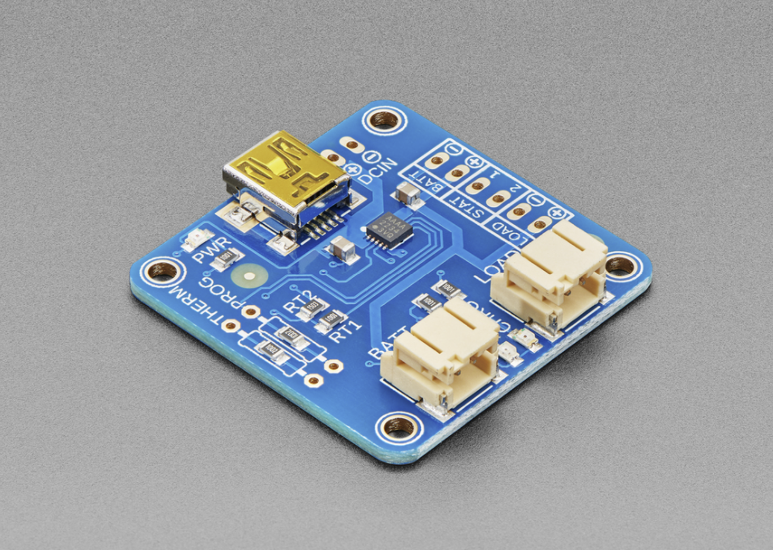
[picture p29: figure]
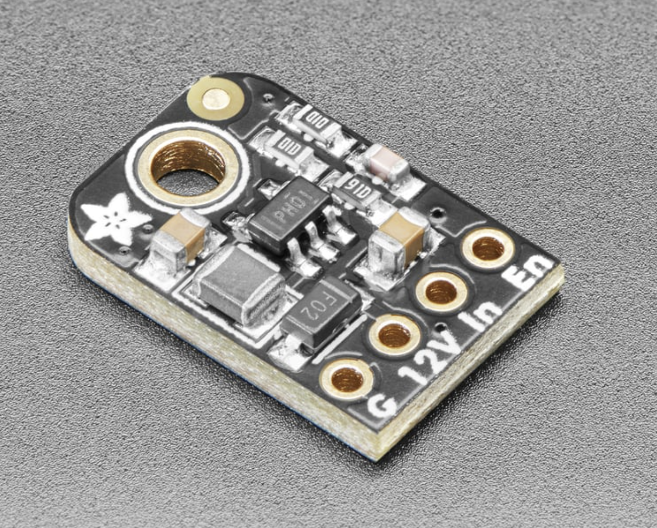
[picture p30: figure]

## Updated Programming interface with DDS and Web App

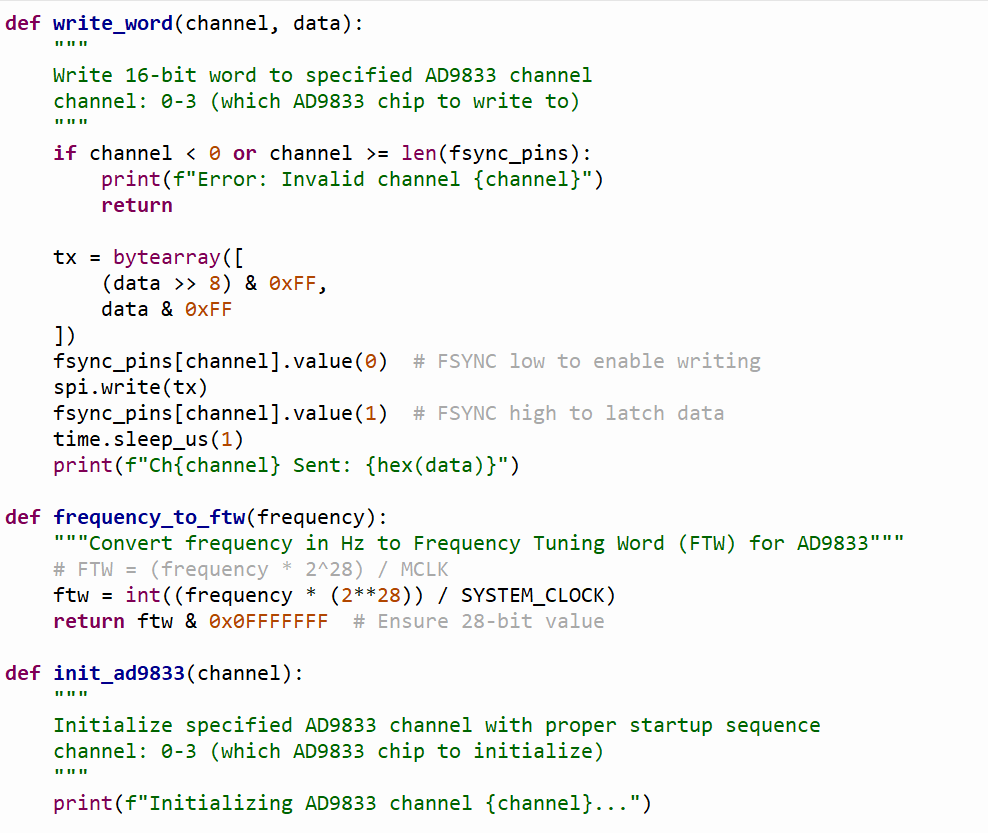
[picture p31: figure]
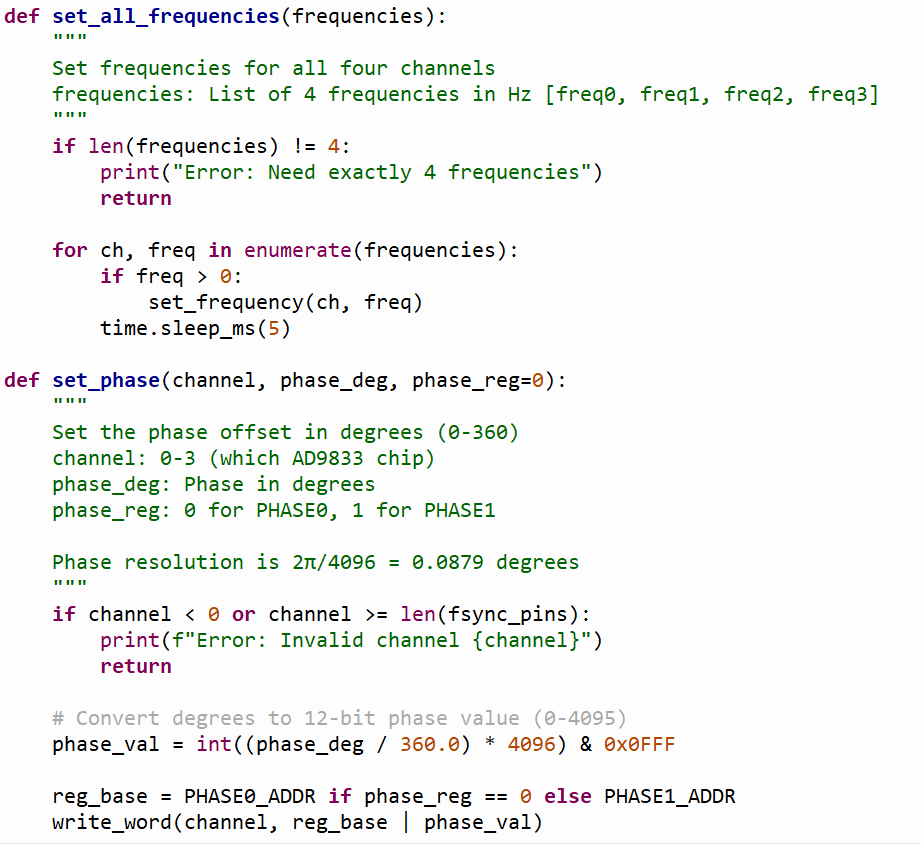
[picture p32: figure]

## Programming interface for the ADC

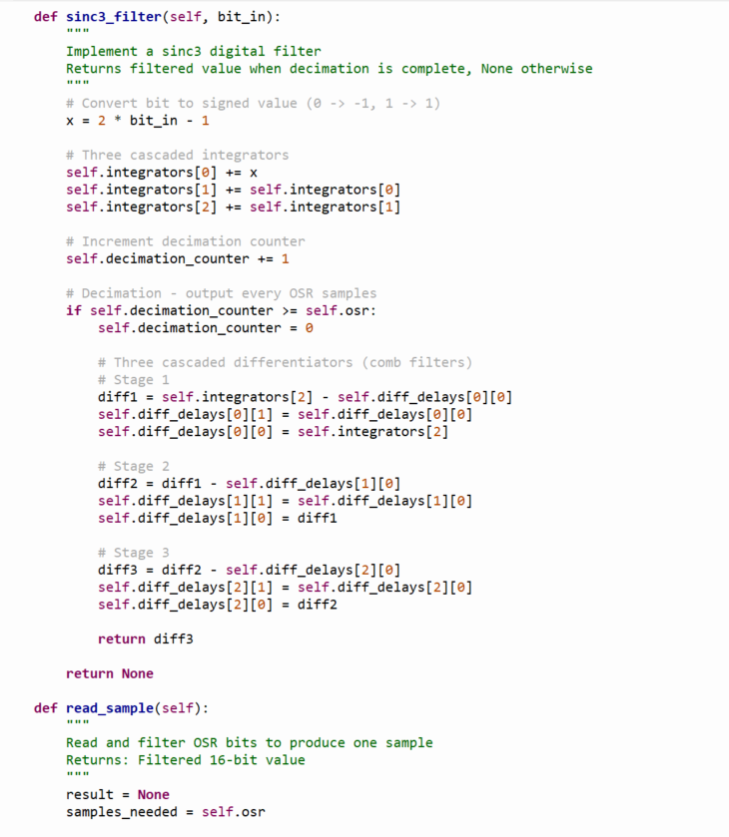
[picture p33: figure]
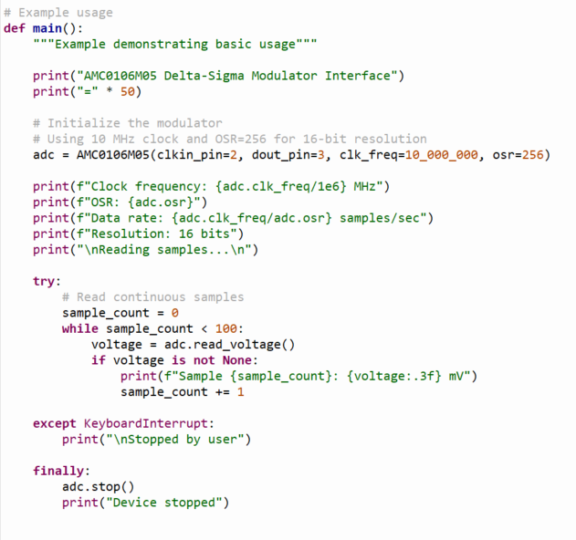
[picture p34: figure]
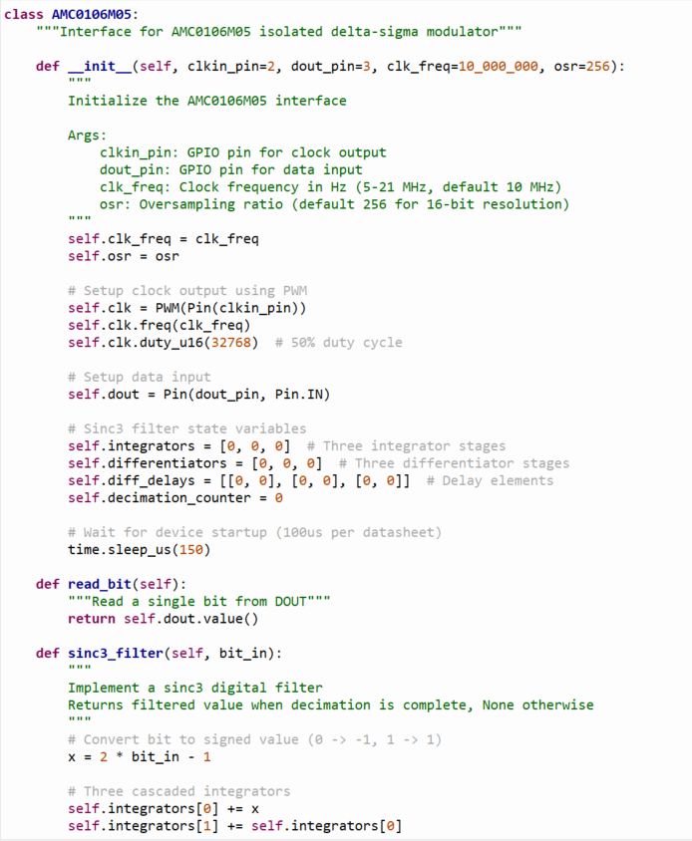
[picture p35: figure]
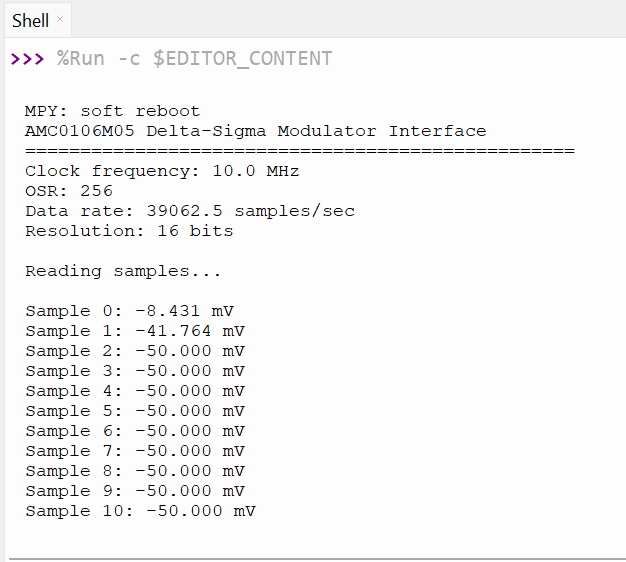
[picture p36: figure]

## Budget

Current Expenses :
- DDS Test Board: $33
- Component Order: $140
- Battery Order: $44
Total: $217

## Challenges so far

- Choosing Connector
- Board sizing
- Power supply

## Immediate Plan

- Order Board
- Create software
- Pray
- Make housing
- Component order
- Report work

## Questions/Feedback
