tylerwhite26/ECE_455_Brain_Stimulator/Presentations/Week_11_Presentation.pptx

## Samad, Guandong, and Tyler

- Brain Stimulator Progress Update

## Problem Description

Make a device that can generate waveforms of precise frequency and current to stimulate deep parts of the brain using electrodes.

## Key Events from Last Week

- Got flyback and iso-adc breakout boards
- Made final amplifier stages
- Made voltage controlled current source circuitry
- Did first pass final board placement

## Schematic Updates

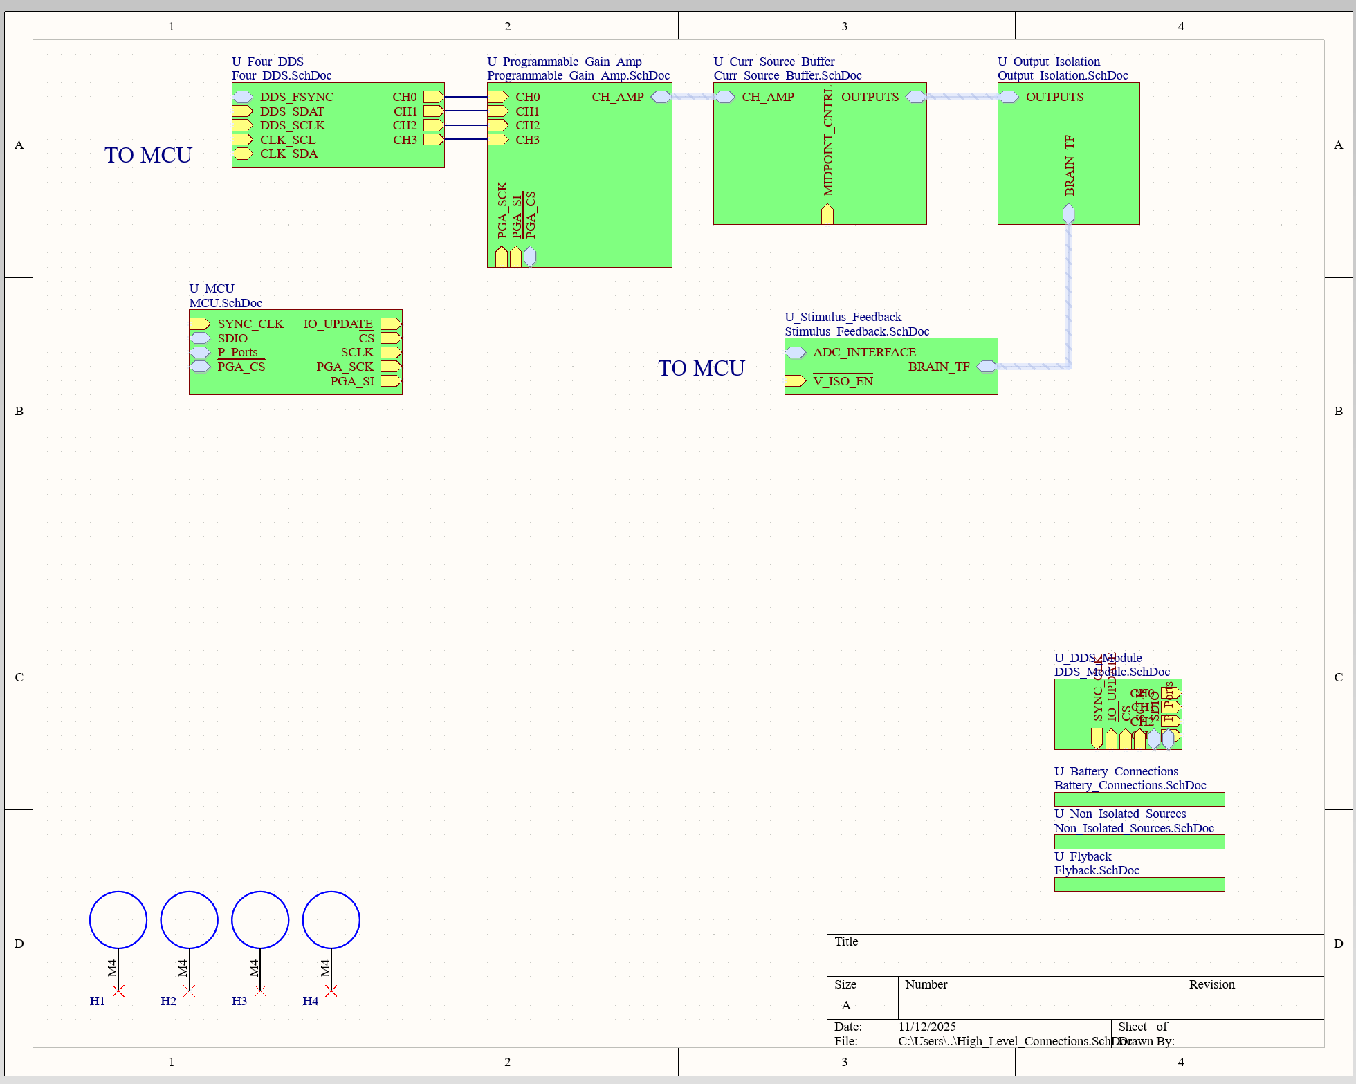
[picture p37: figure]

## Schematic Updates Continued


## Kill Switch

- Cut off 12V enable because otherwise the switching regulators will be on and incur losses
- Comes at the price of powering down MCU
- Soft kill is currently done through software. Ideally will add button but need to find space.

## Switch from Audio Jack to BNC

- More robust
- Downside is size

## Schematic Updates Continued


## Current Source Simulation


## Current Source

- Use a midpoint offset to turn 0-5 V sine wave into a -5-5 mA current source
- Tight tolerance resistor which has the voltage across it controlled such that current is known

## Voltage Controlled Attenuator Simulation

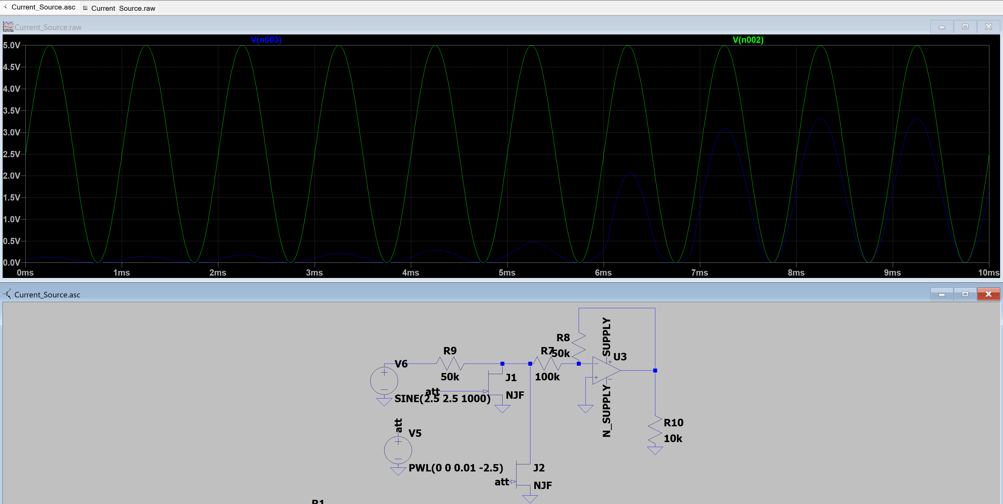
[picture p38: figure]

## Voltage Controlled Attenuator

- After initial amplification the sine wave will be max 0-5V constant sine wave, so need amplitude control
- Step down instead of up. Apply a negative voltage to the gate of a JFET to control linear region resistance of the device
- Use JFETs in voltage divider to step down voltage swing

## Schematic Updates Continued

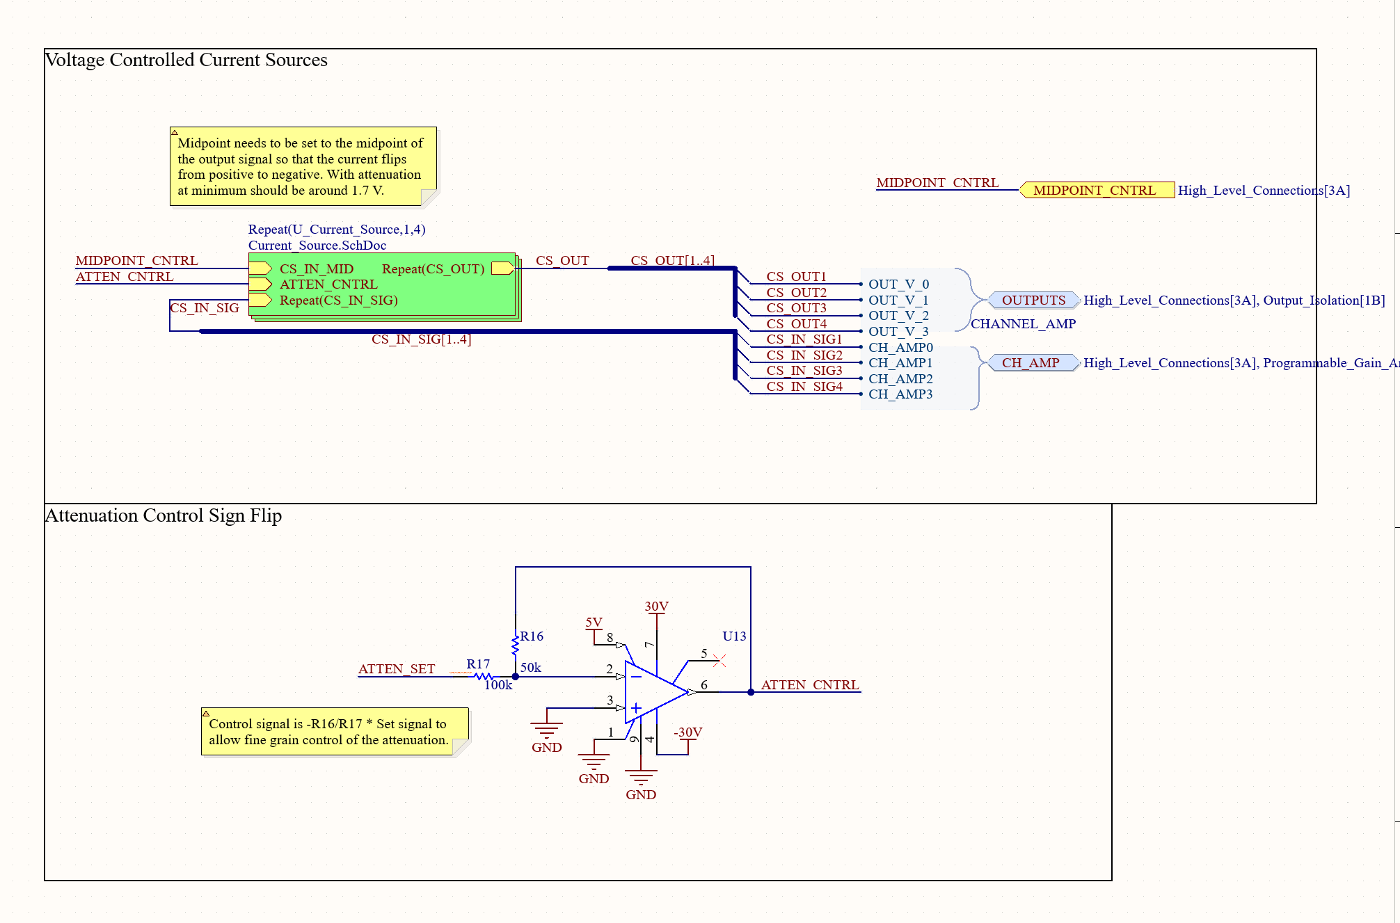
[picture p39: figure]

## Schematic Updates Continued


## ADC Breakout board Layout

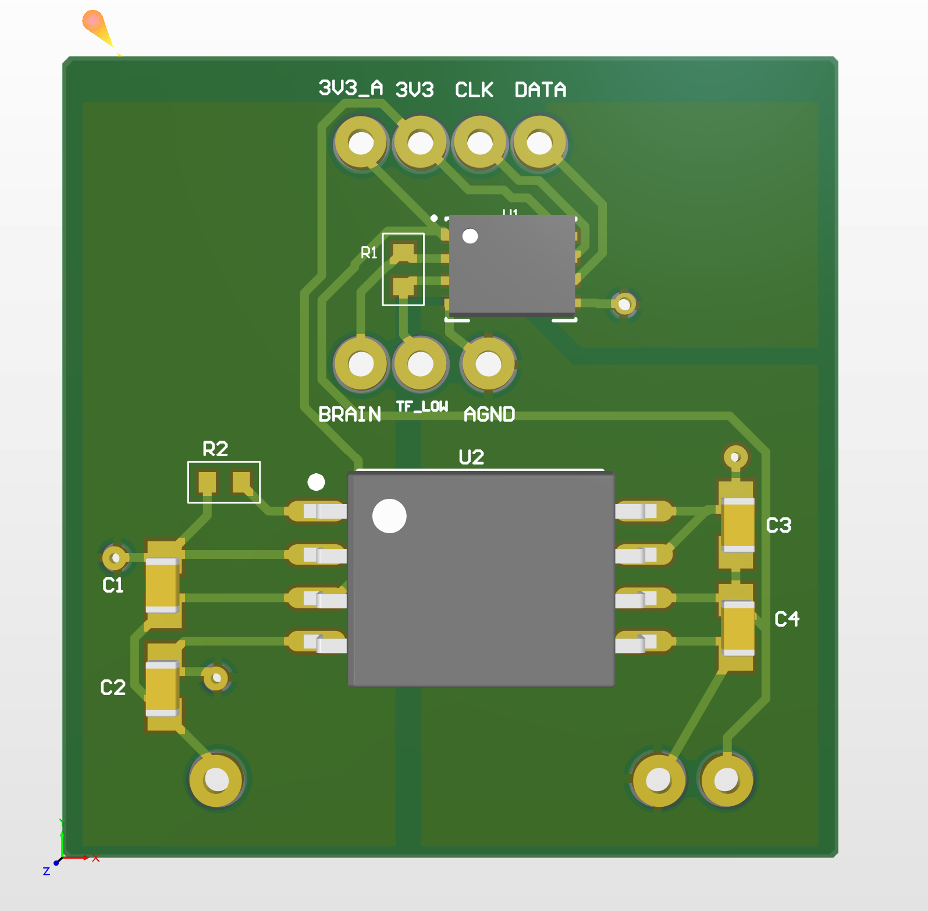
[picture p40: figure]

## Assembled ADC and DC-DC Breakout Board

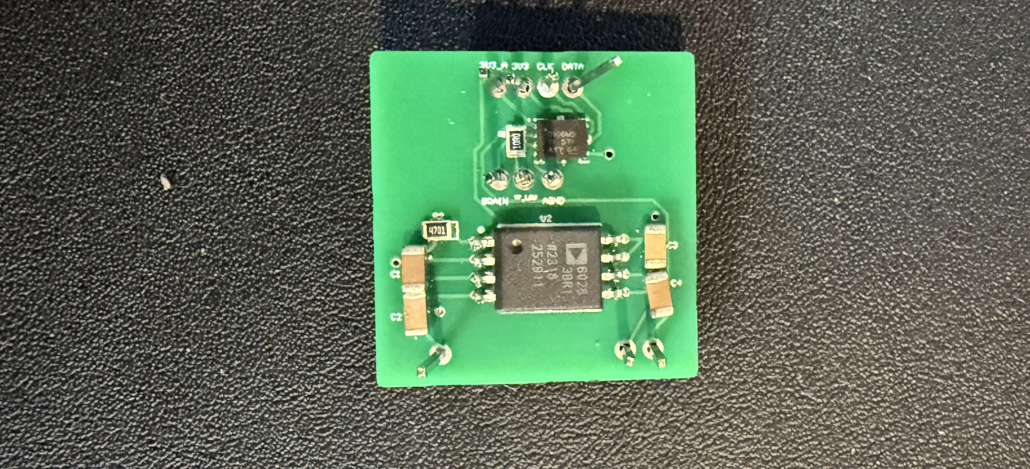
[picture p41: figure]

## ADC testing

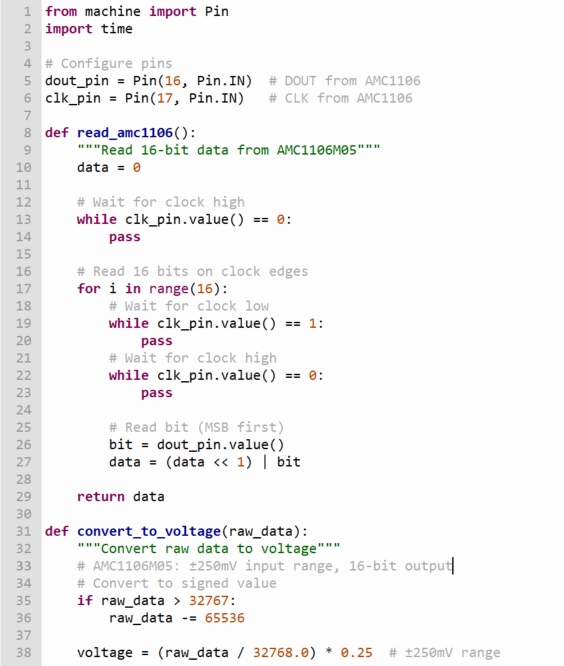
[picture p42: figure]
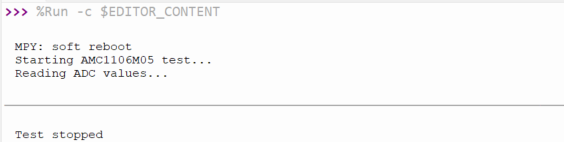
[picture p43: figure]

- Possibly no clock signal, needs more testing

## Flyback Converter

- Get +/-30 V rails
- Incur some losses from two switching converters, almost unavoidable
- Feed into final amplifier stage

## Flyback Breakout

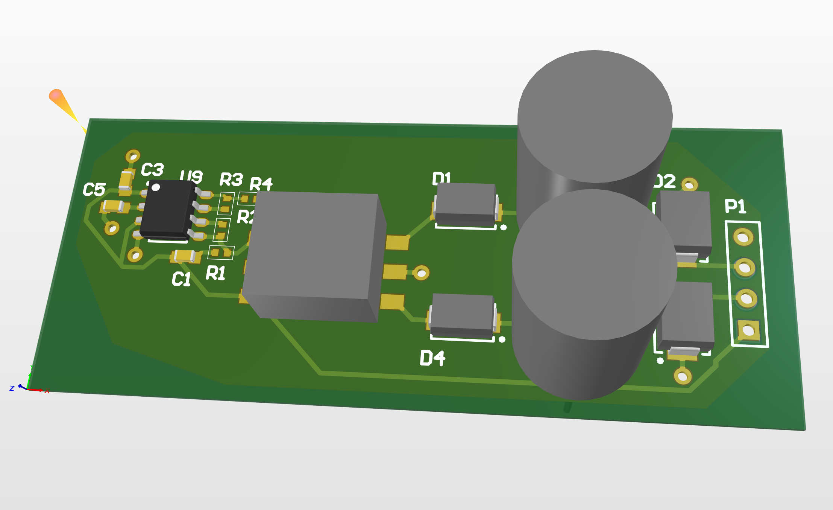
[picture p44: figure]

## Final Board Placement

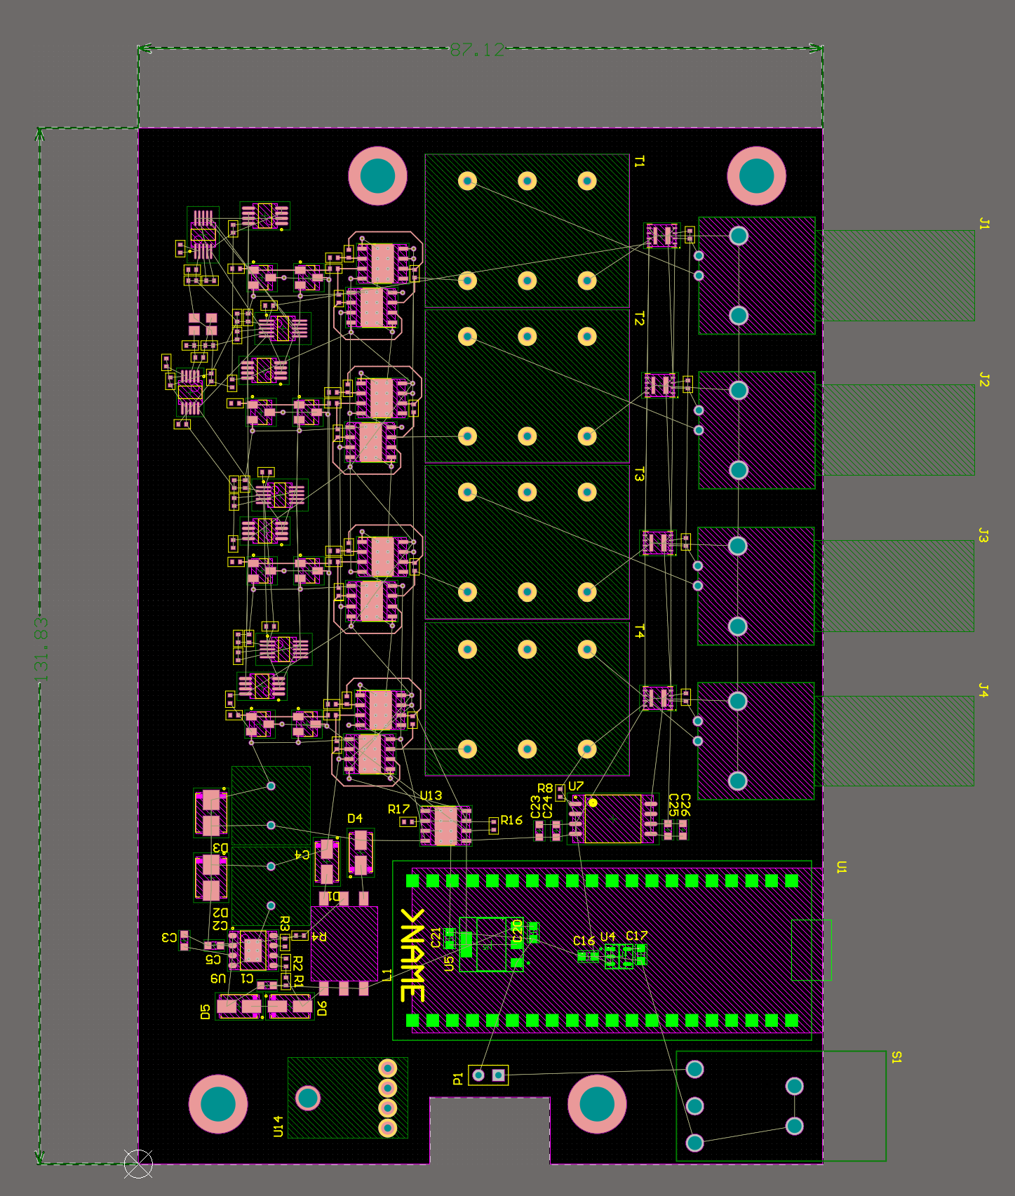
[picture p45: figure]
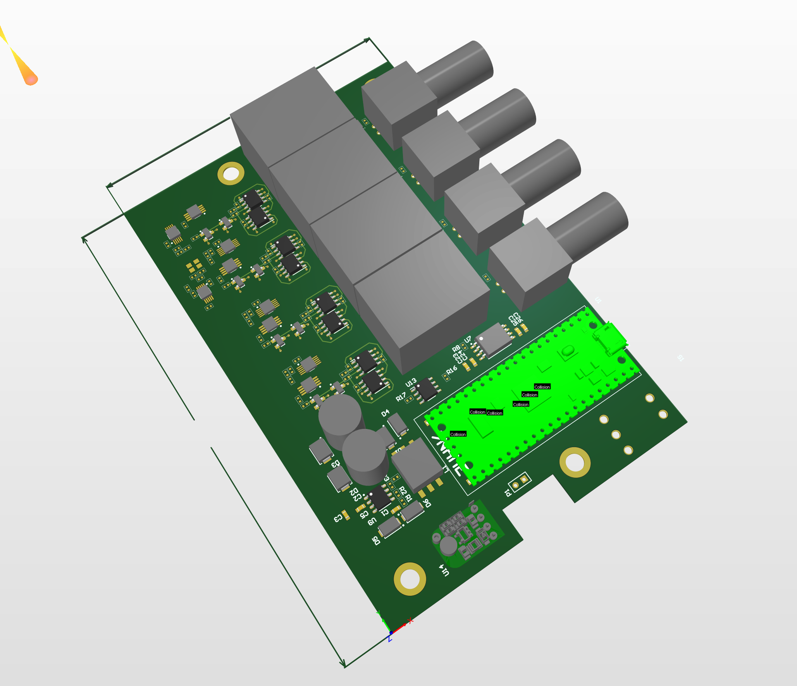
[picture p46: figure]

## Other Components


## Programming interface for the ADC


## Budget

Current Expenses :
- DDS Test Board: $33
- Component Order: $140
- Battery Order: $44
Total: $217

## Challenges so far

- Choosing Connector
- Board sizing
- Power supply

## Immediate Plan

- Get MCU pinout
- Route board and order by Friday
- Test subsections before board order
- Get BOM together

## Questions/Feedback
