tylerwhite26/ECE_455_Brain_Stimulator/Presentations/Week_10_Presentation.pptx

## Samad, Guandong, and Tyler

- Brain Stimulator Progress Update

## Problem Description

Make a device that can generate waveforms of precise frequency and current to stimulate deep parts of the brain using electrodes.

## Key Events from Last Week

- Schematic changes to accommodate new DDS
- Added flyback converter to schematic
- Flyback Breakout
- Start of placement onto final PCB (Not routing until all placed)

## Schematic Updates

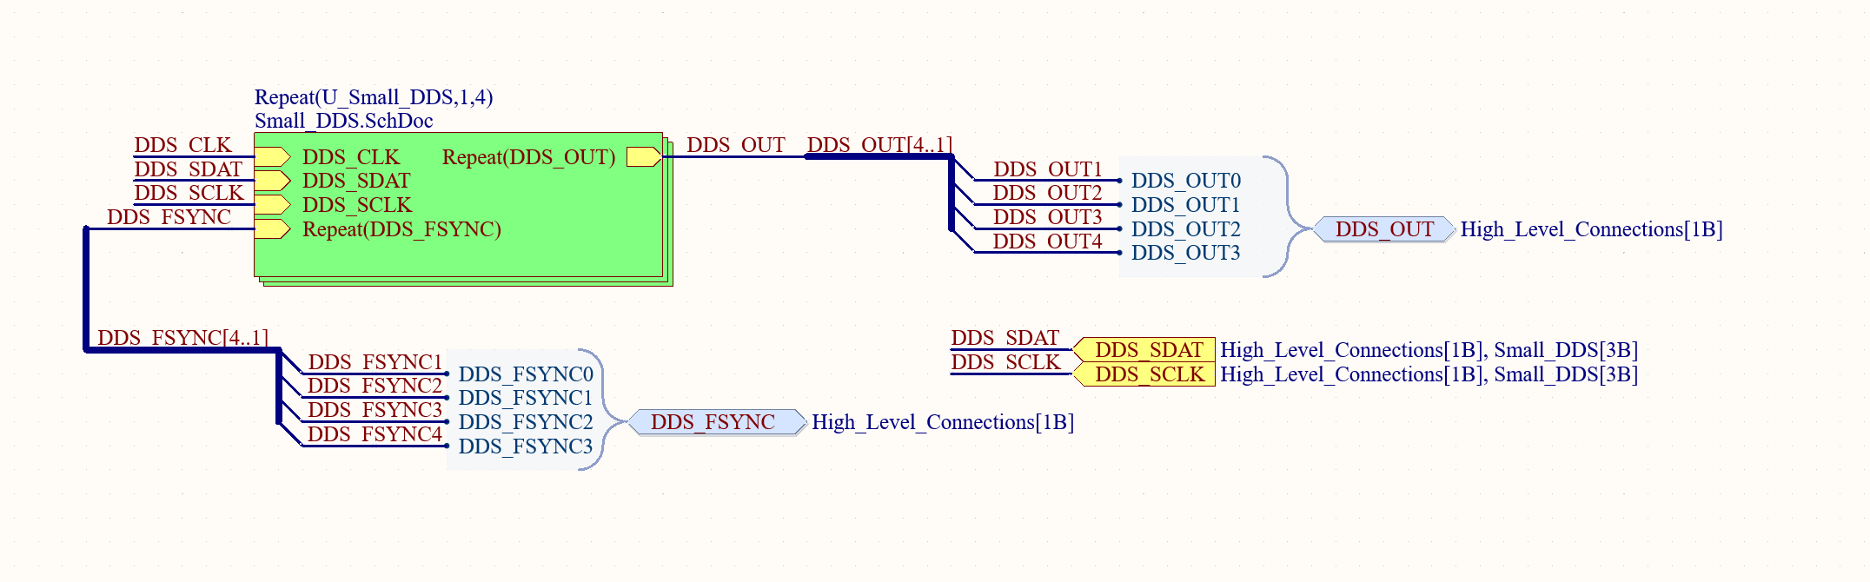
[picture p47: figure]
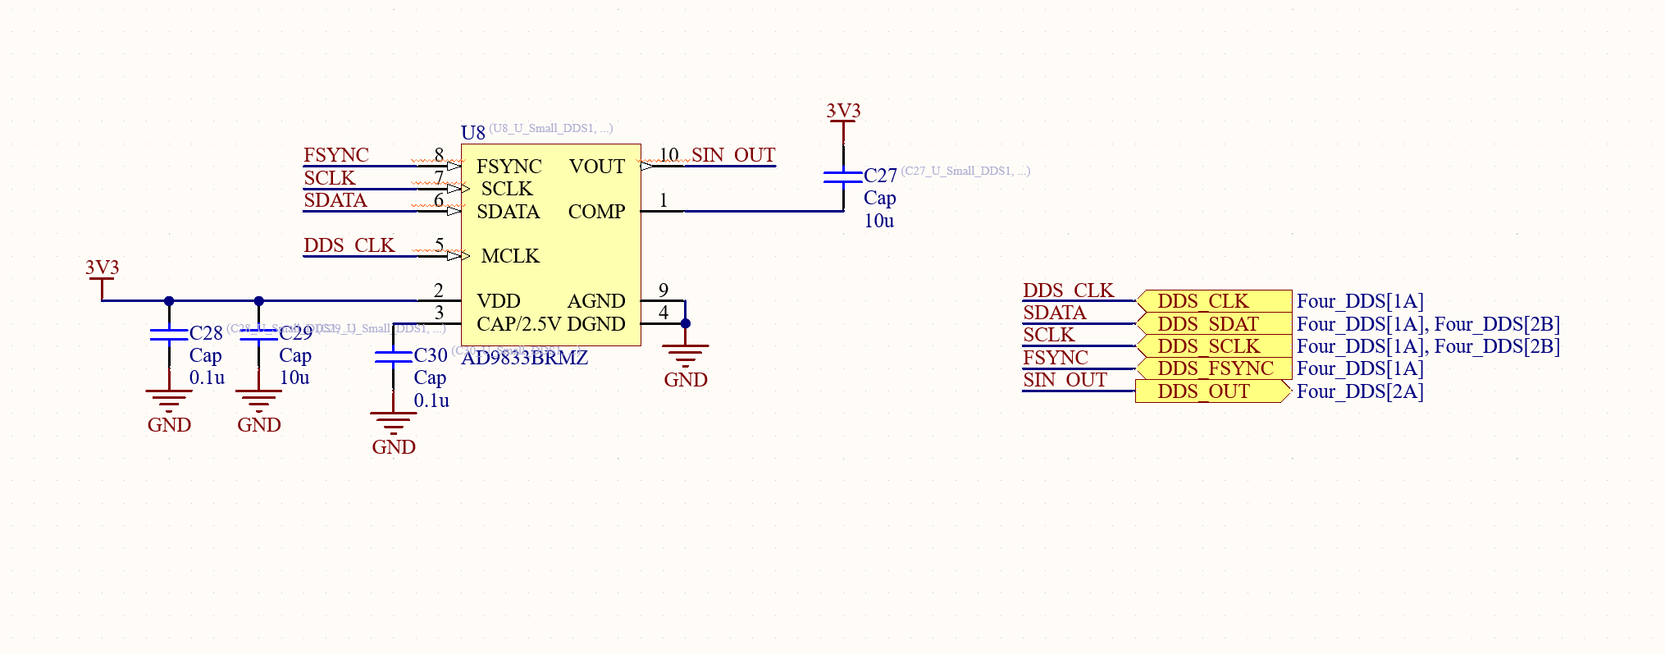
[picture p48: figure]

## Schematic Updates Continued

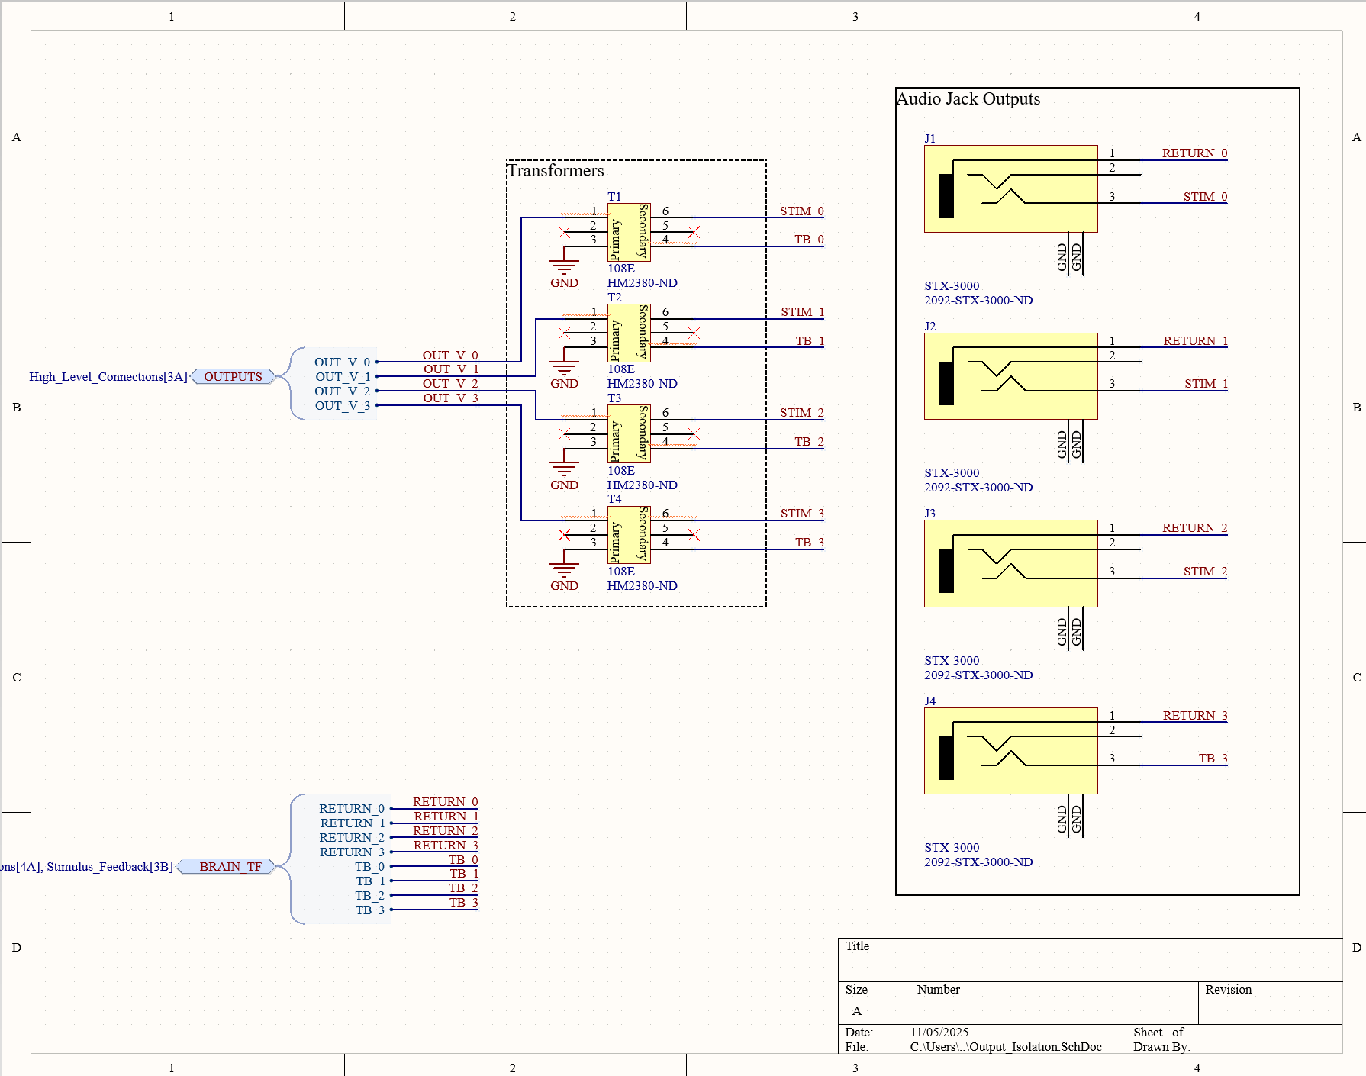
[picture p49: figure]

## Schematic Updates COntinued

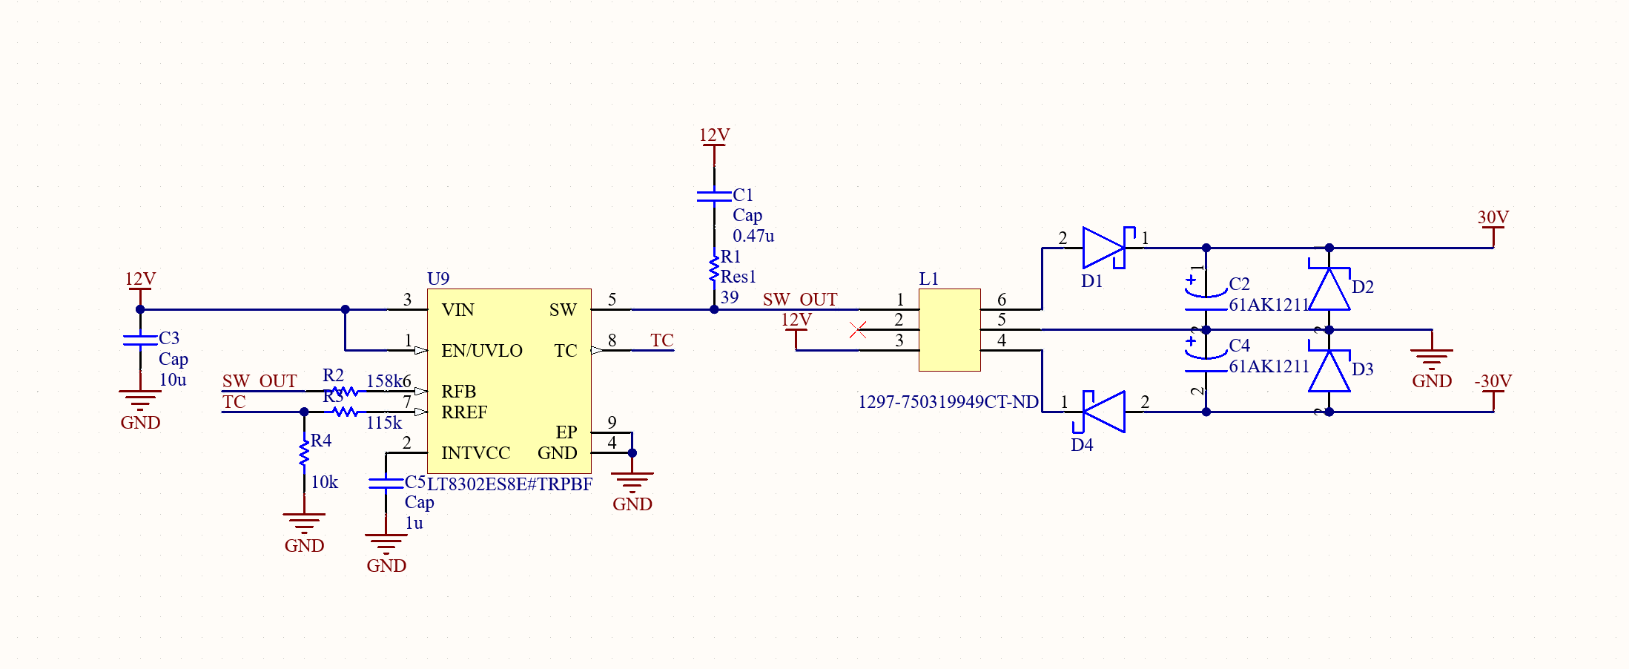
[picture p50: figure]

## Justification for Audio Jacks

- Readily available
- Fast repair, requires no rework
- Downside is might pop out and cause pain, will have to test
- Space saving compared to banana jacks

## Revised Breakout Board Layout

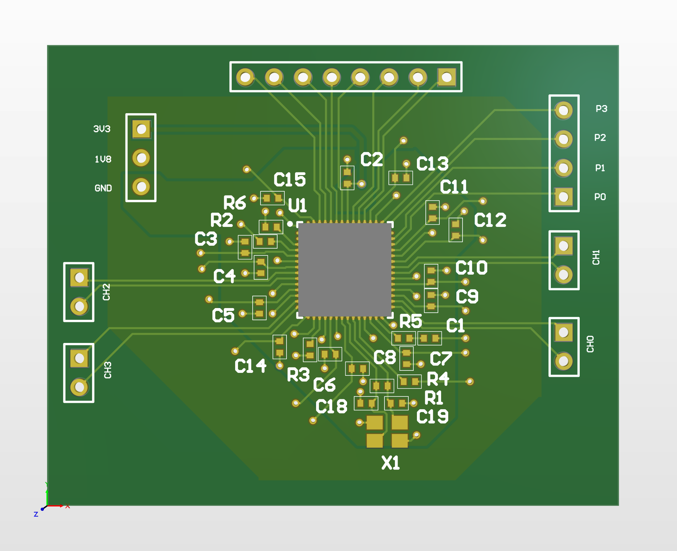
[picture p51: figure]

## ADC Breakout board Layout


## Switch to Four Small DDS

- Big DDS great in theory because it has a lot of features, bad in practice because it has a lot of features (over-speced)
- Smaller DDS have more voltage focus
- DDS are expensive, but reduce load on the MCU

## DDS Breakout Board

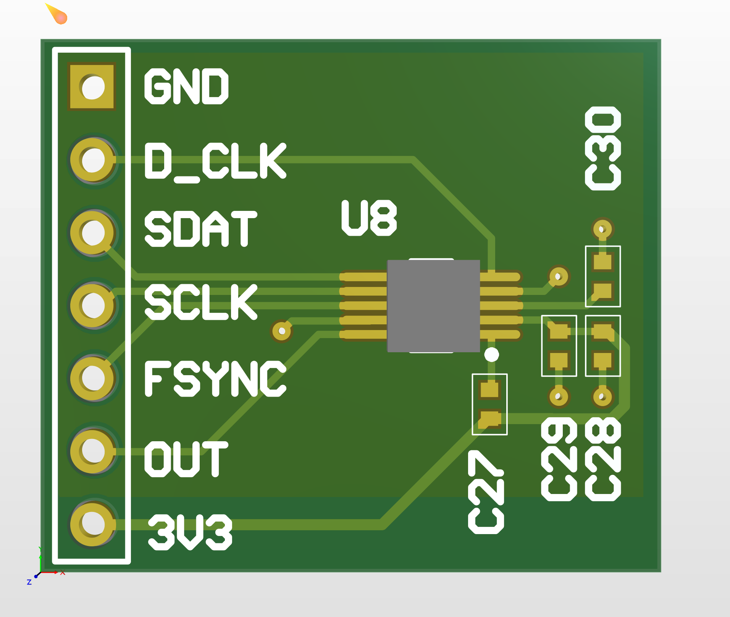
[picture p52: figure]

## Flyback Converter

- Get +/-30 V rails
- Incur some losses from two switching converters, almost unavoidable
- Feed into final amplifier stage

## Flyback Breakout


## Programming interface for the ADC


## Budget

Current Expenses :
- DDS Test Board: $33
- Component Order: $140
- Battery Order: $44
Total: $217

## Challenges so far

- Space is extremely limited
  - How do we keep it under 100mm by 100mm?
- Some components are hard to find

## Immediate Plan

- Assemble our breakouts
- Tests subsections
- Route laid out rooms to each other

## Questions/Feedback
