tylerwhite26/ECE_455_Brain_Stimulator/Presentations/Week_9_Presentation.pptx

## Samad, Guandong, and Tyler

- Brain Stimulator Progress Update

## Problem Description

Make a device that can generate waveforms of precise frequency and current to stimulate deep parts of the brain using electrodes.

## Key Events from Last Week

- Battery came in (And tested?)
- Lots of boards
- DDS Verification ()
- Change of direction for output generation

## Battery Updates

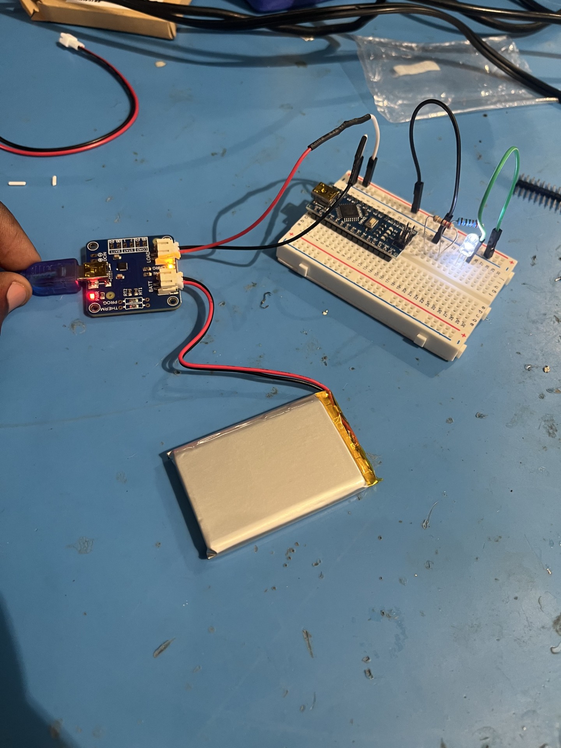
[picture p53: figure]

## Flyback Updates

## DC-DC Converter

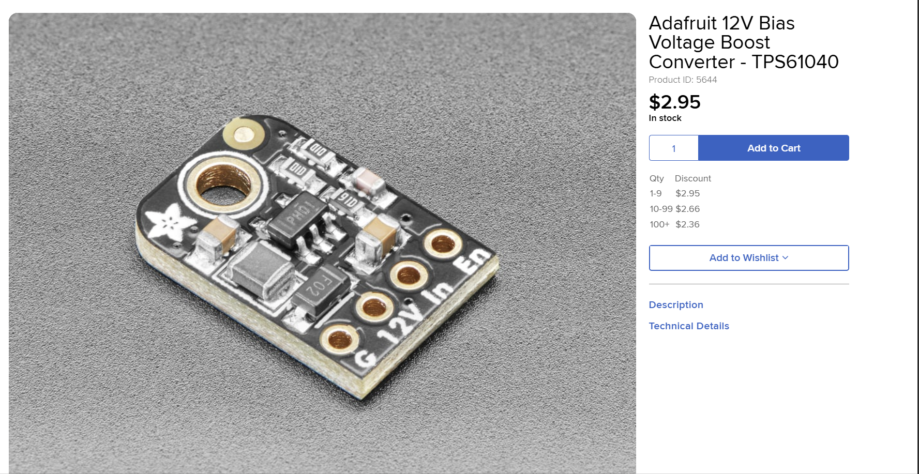
[picture p54: figure]

## Schematic Updates

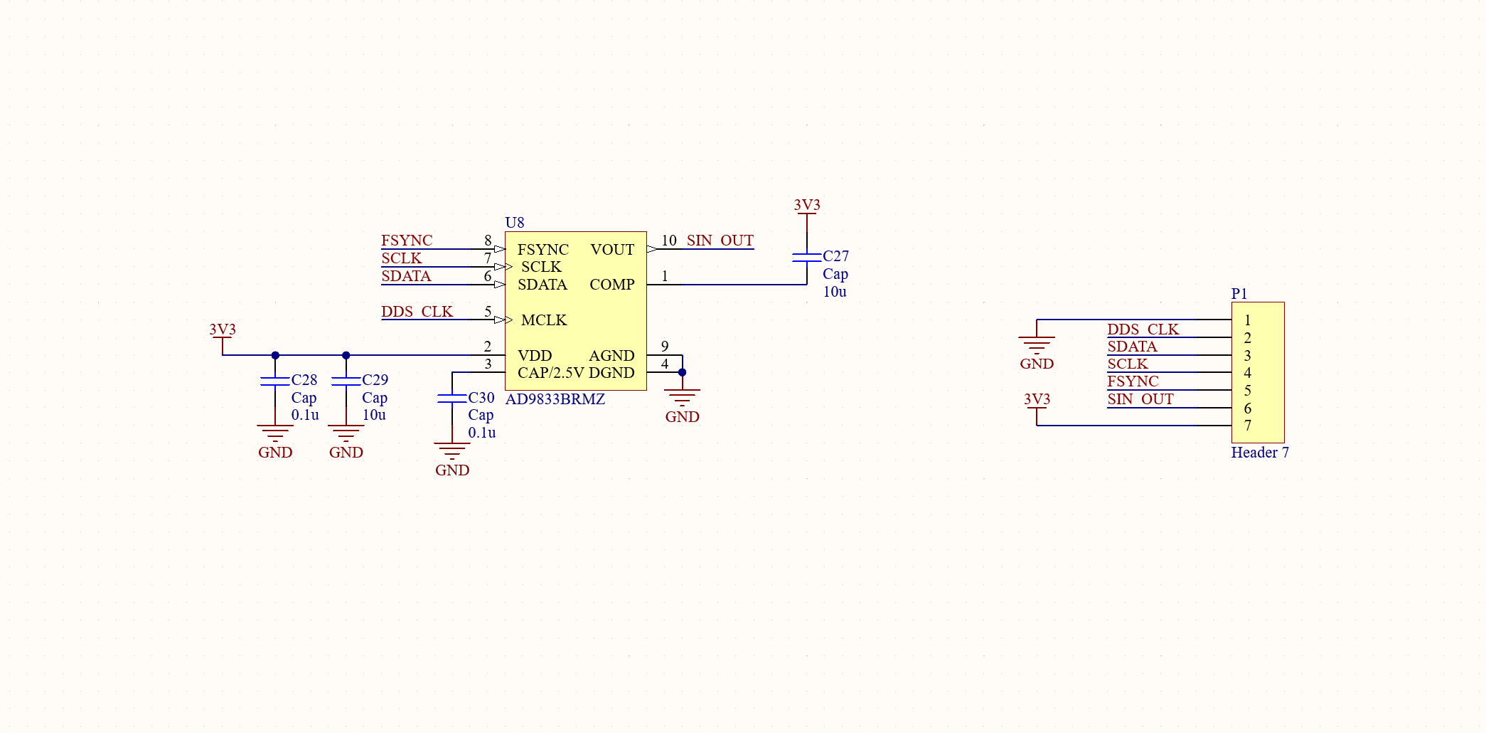
[picture p55: figure]
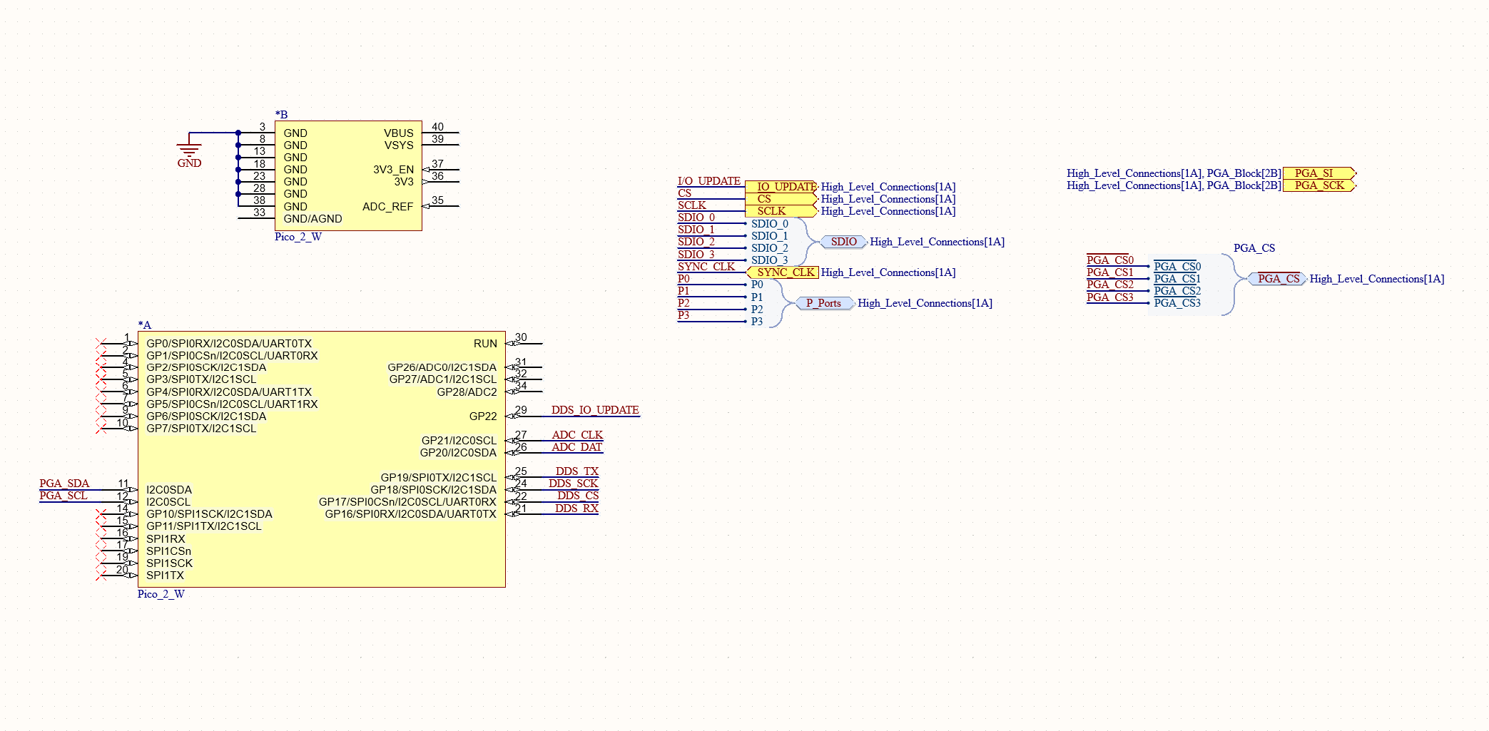
[picture p56: figure]

## Revised Breakout Board

What went wrong?
- Order of power-up not controlled
- Crystal not oscillating
- Pulling 50mA current (Not terrible, but where is it going?)

## Revised Breakout Board Layout


## ADC Breakout Board

- Test isolated power rail
- Ensure accurate readings given current
- Work on software support for ADC
- Feedback loop for output current

## ADC Breakout board Layout


## Switch to Four Small DDS

- Big DDS great in theory because it has a lot of features, bad in practice because it has a lot of features (over-speced)
- Smaller DDS have more voltage focus
- DDS are expensive, but reduce load on the MCU

## DDS Breakout Board


## Budget

Current Expenses :
- DDS Test Board: $33
- Component Order: $140
- Battery Order: $44
Total: $217

## Updated BOM

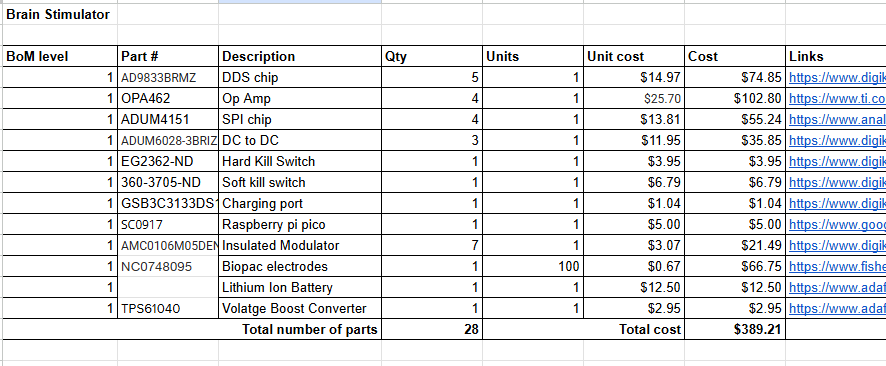
[picture p57: figure]

## Challenges so far

- Space is extremely limited
- Some components are hard to find

## Immediate Plan

- Layout completed rooms
- Get flyback stuff working
- Battery
- ADC software

## Questions/Feedback
