tylerwhite26/ECE_455_Brain_Stimulator/Presentations/Week_8_Presentation.pptx

## Samad, Guandong, and Tyler

- Brain Stimulator Progress Update

## Problem Description

Make a device that can generate waveforms of precise frequency and current to stimulate deep parts of the brain using electrodes.

## Key Events from Last Week

- Bluetooth connectivity with between rpi and web app
- Continued battery search
- Work on web app – attempted SPI transfers
- New LDO and routing everything to output transformer

## Bluetooth Connection to the MCU (Raspberry pi Pico W)

Save two MicroPython modules in our RPi Pico to communicate via Bluetooth Low Energy

Helpers for generating BLE advertising payloads

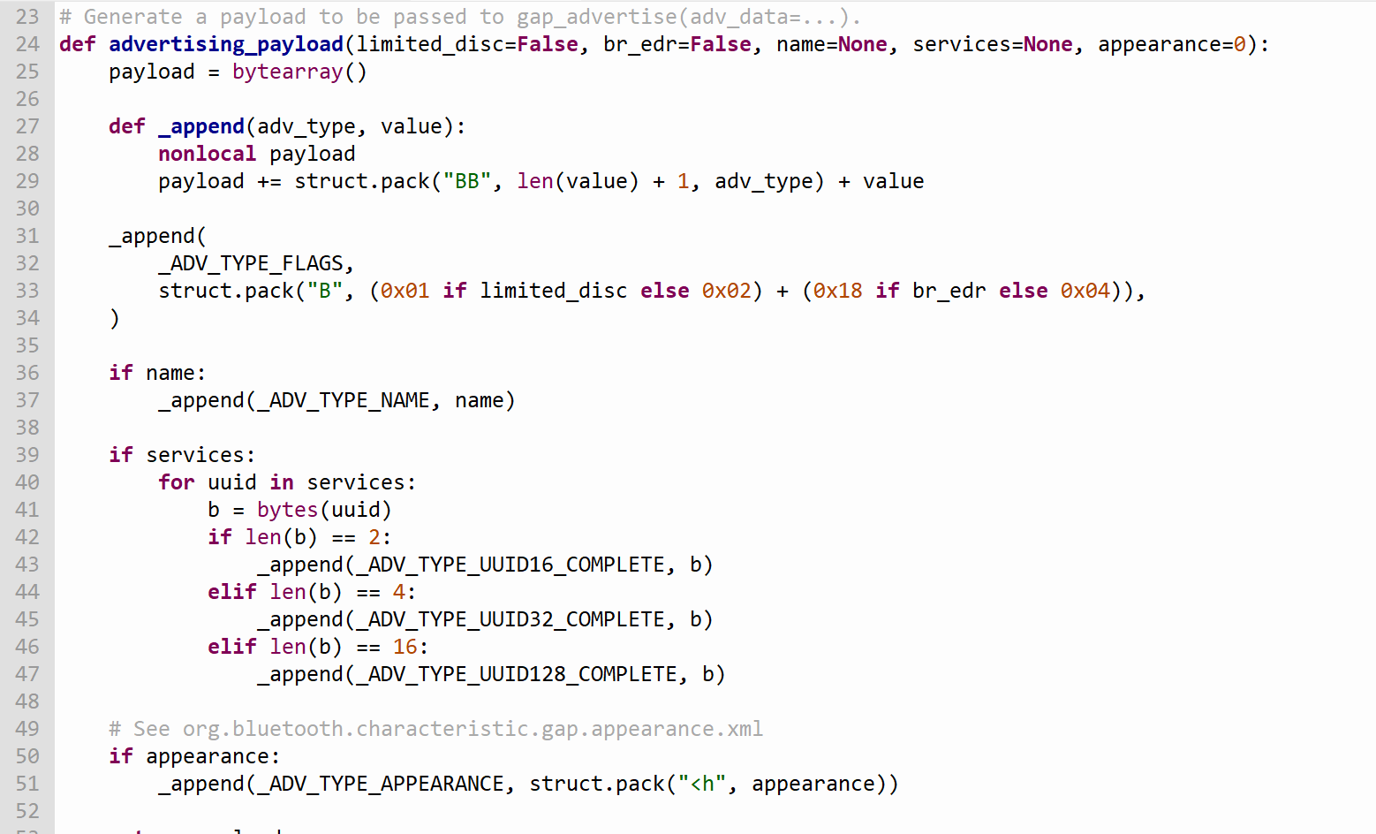
[picture p58: figure]
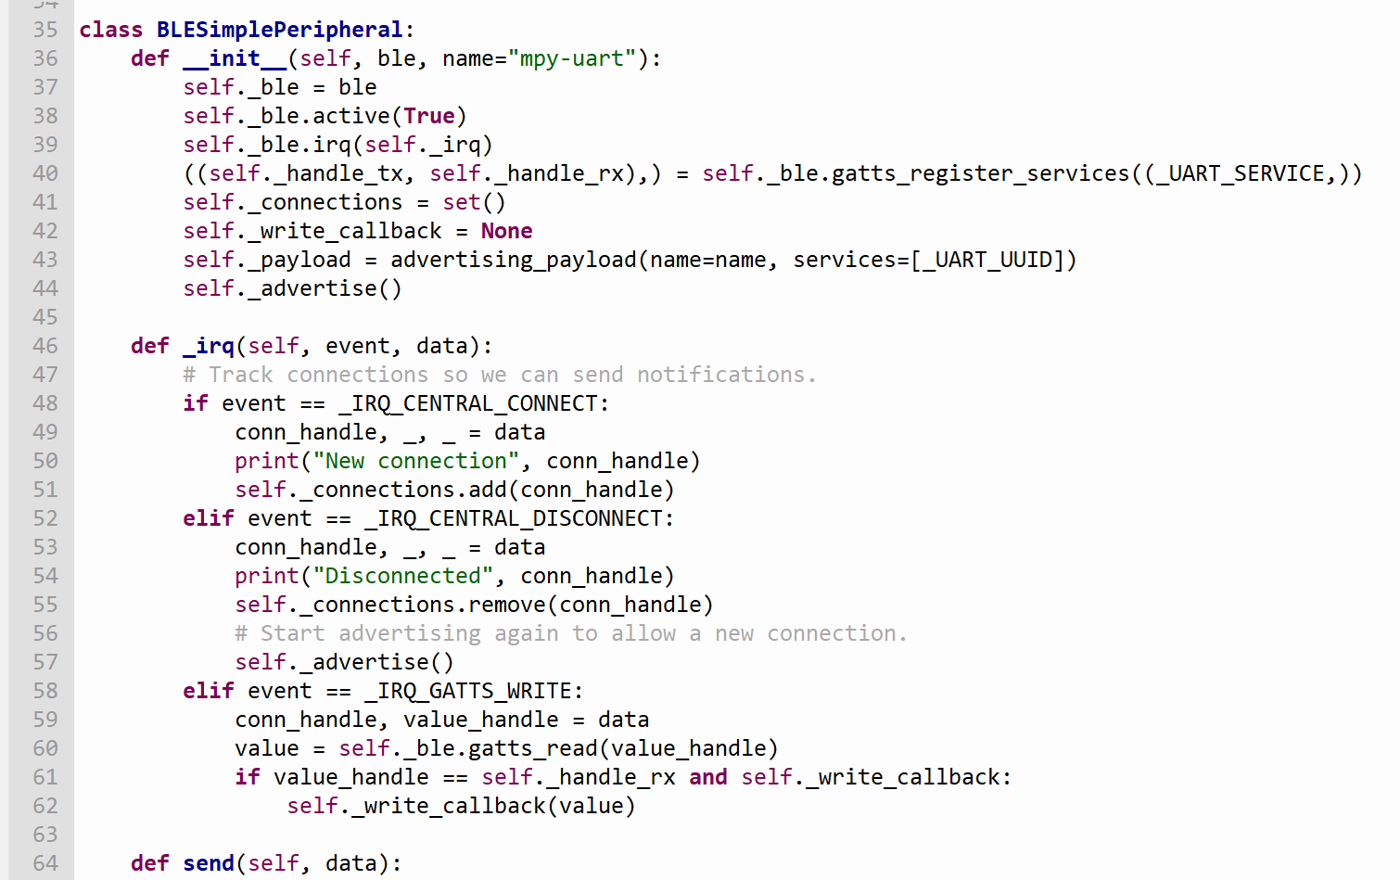
[picture p59: figure]

Creates a simple BLE peripheral

https://electrocredible.com/raspberry-pi-pico-w-bluetooth-ble-micropython/

## SPI Testing with The Raspberry PI

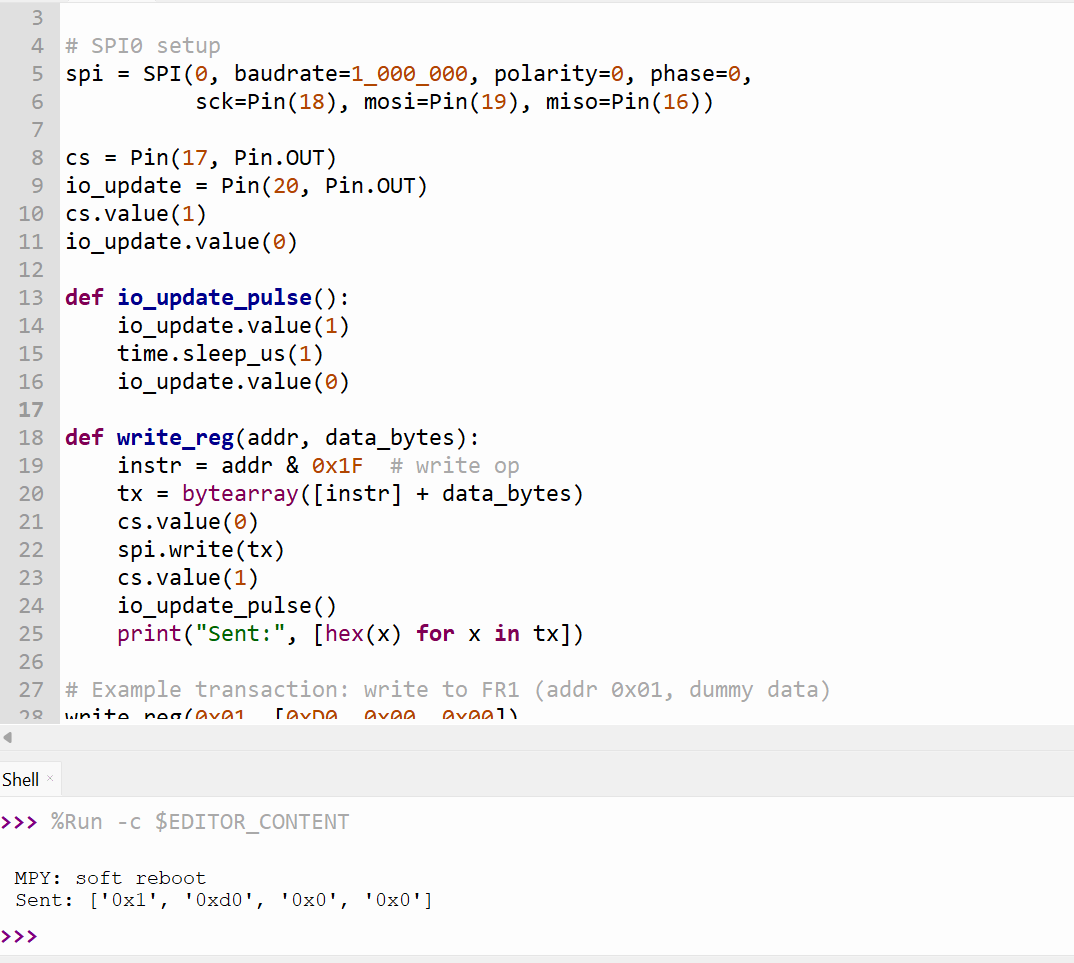
[picture p60: figure]

This simulates writing to a function register in the DDS

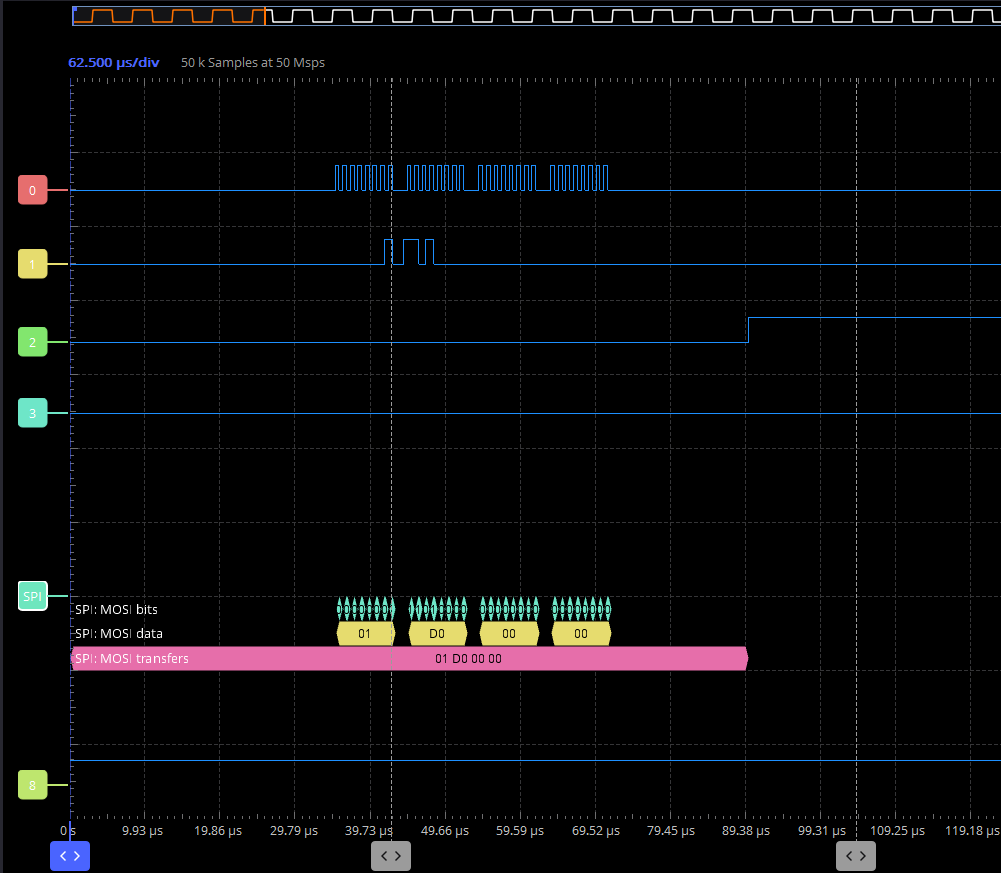
[picture p61: figure]

Waveform caught by oscilloscope

- Next, we need to test it with DDS directly

## Web App

- Choosing browser based for best portability
- Using webbluetooth with JS
- Need room to expand easily to more channels

## Web App

- Enable/disable on outputs
- Beat frequency calculation
- Non-volatile programming capable (How to modify code? Constant address?)

## Web App Continued

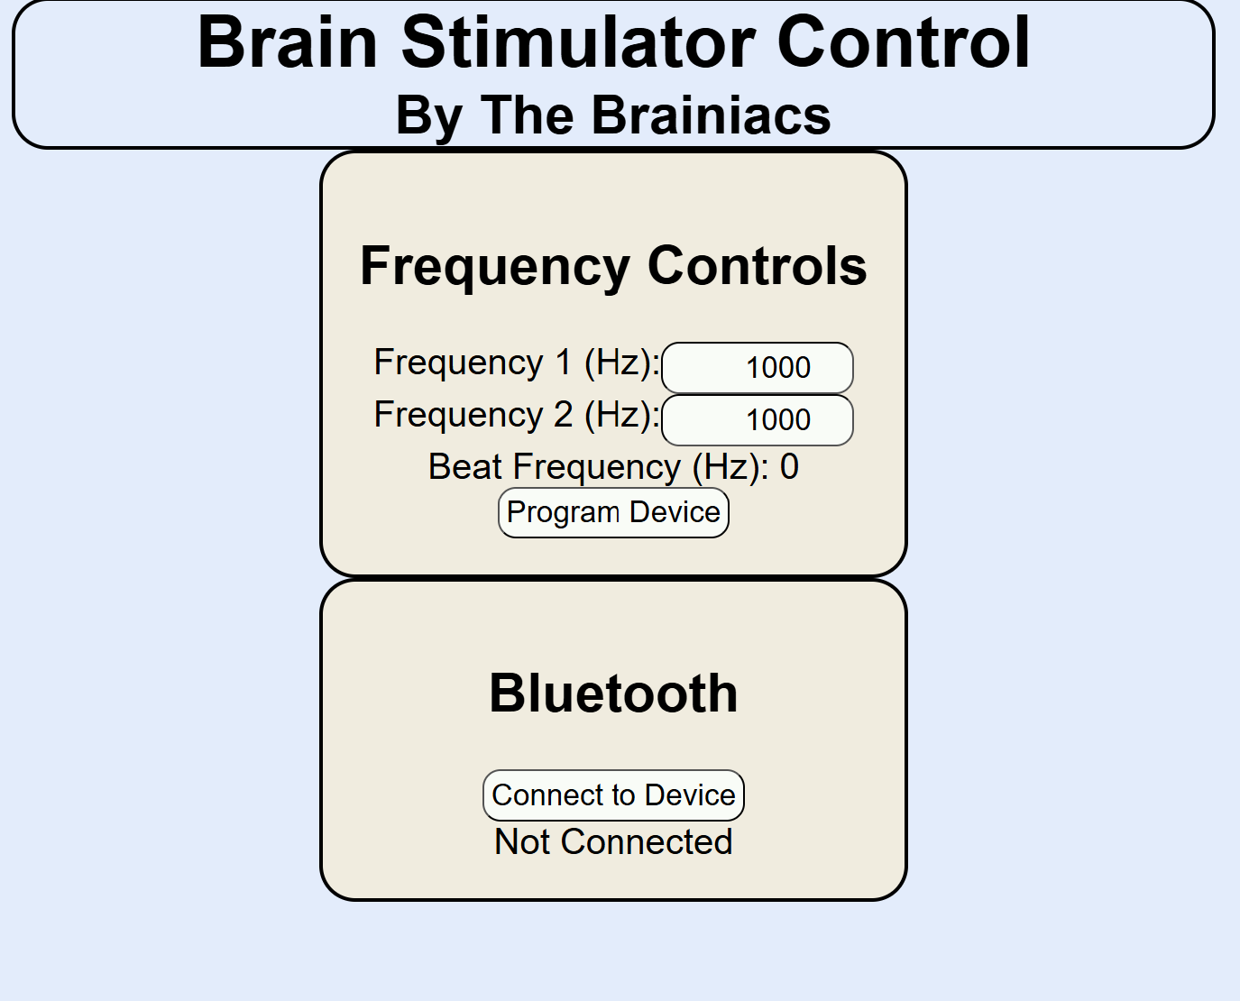
[picture p62: figure]

(I <3 CSS)

## Web App Backend

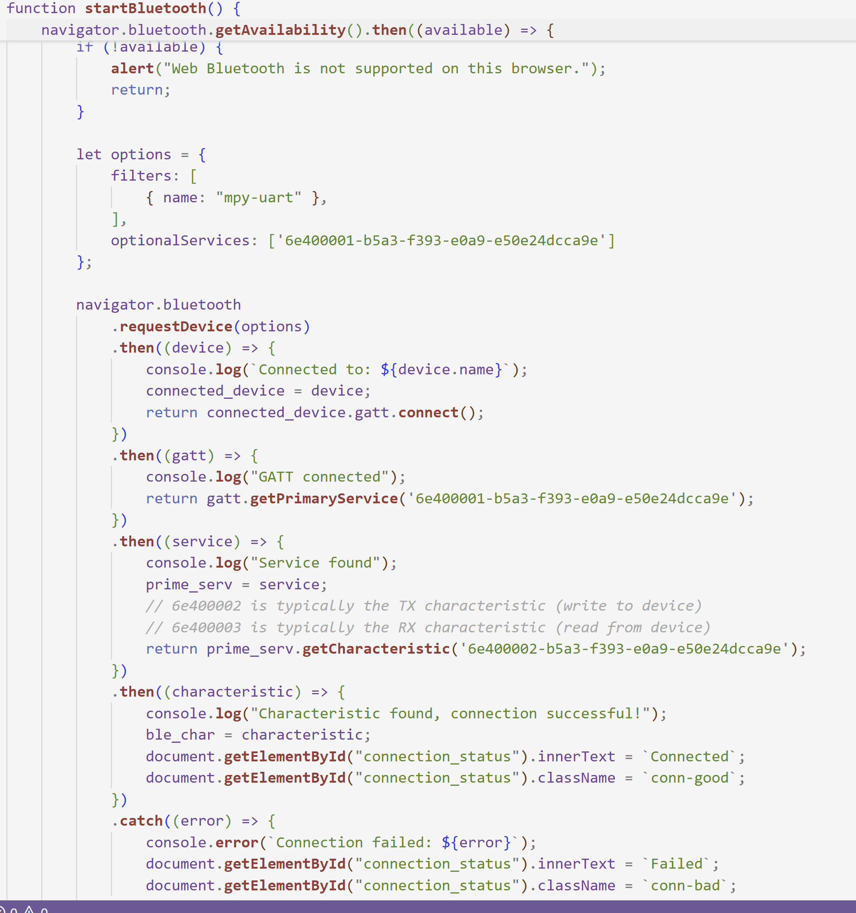
[picture p63: figure]
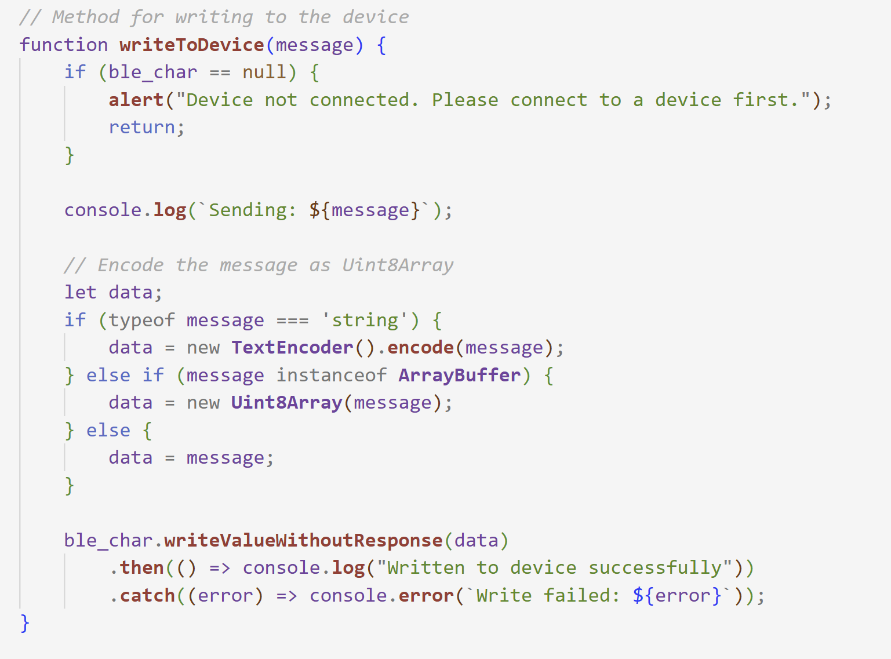
[picture p64: figure]

## Writes to two channels

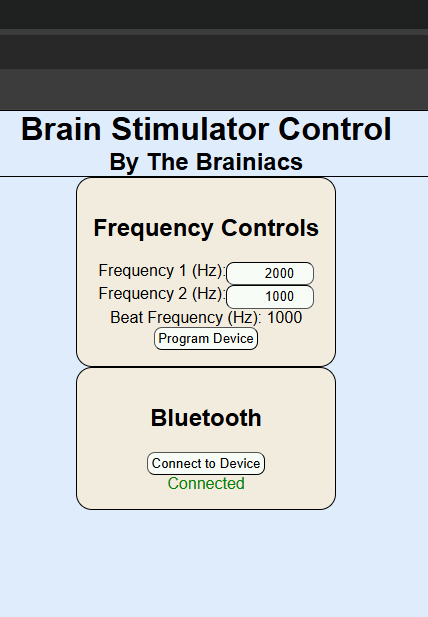
[picture p65: figure]
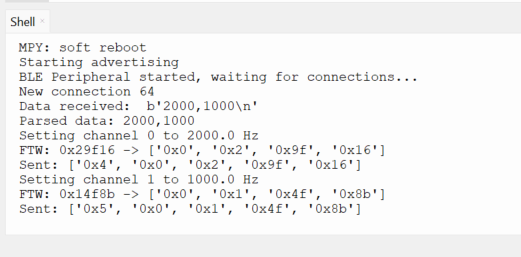
[picture p66: figure]

## RPI Backend

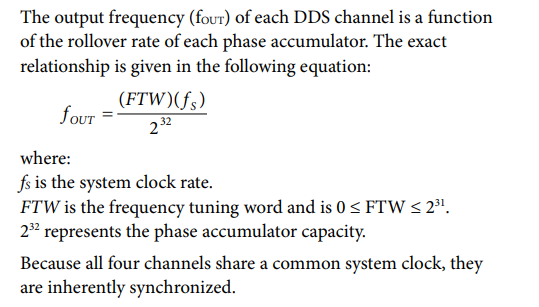
[picture p67: figure]
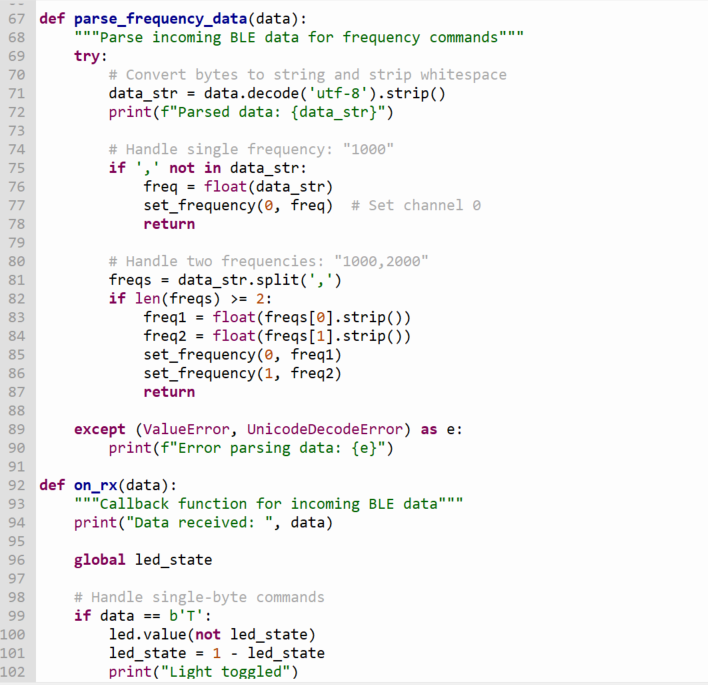
[picture p68: figure]
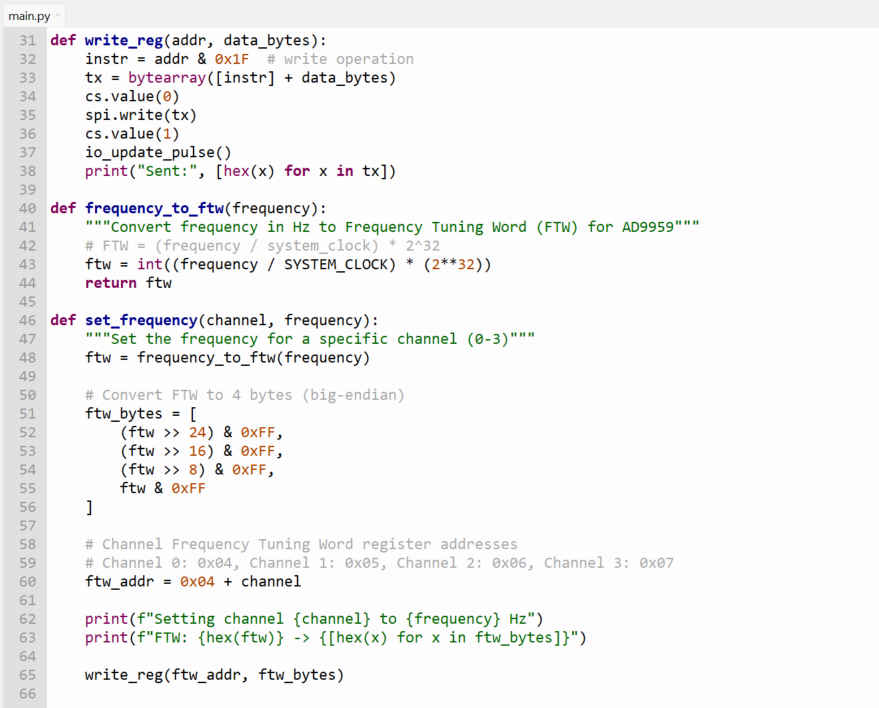
[picture p69: figure]

## Flash memory to store last used frequencies

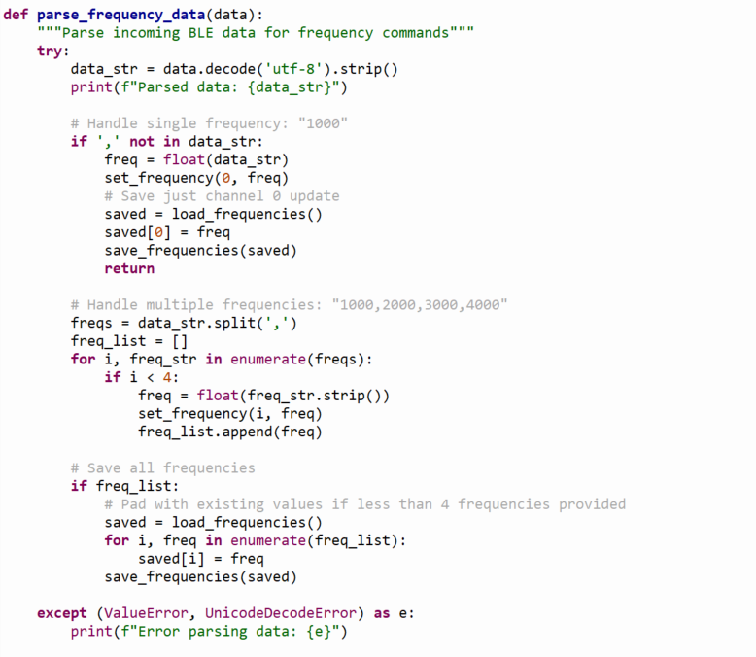
[picture p70: figure]
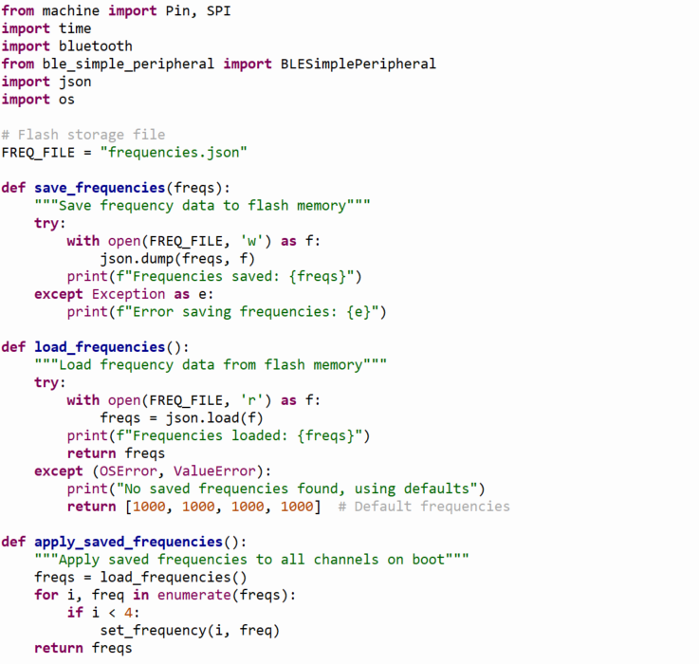
[picture p71: figure]
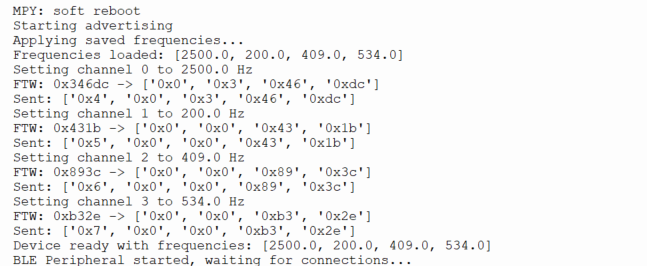
[picture p72: figure]

## Plans for Battery

- Calculate required amp hours to narrow search
- Find something with integrated BMS
- Use dimensions to make housing and board dimensions

## Simulation

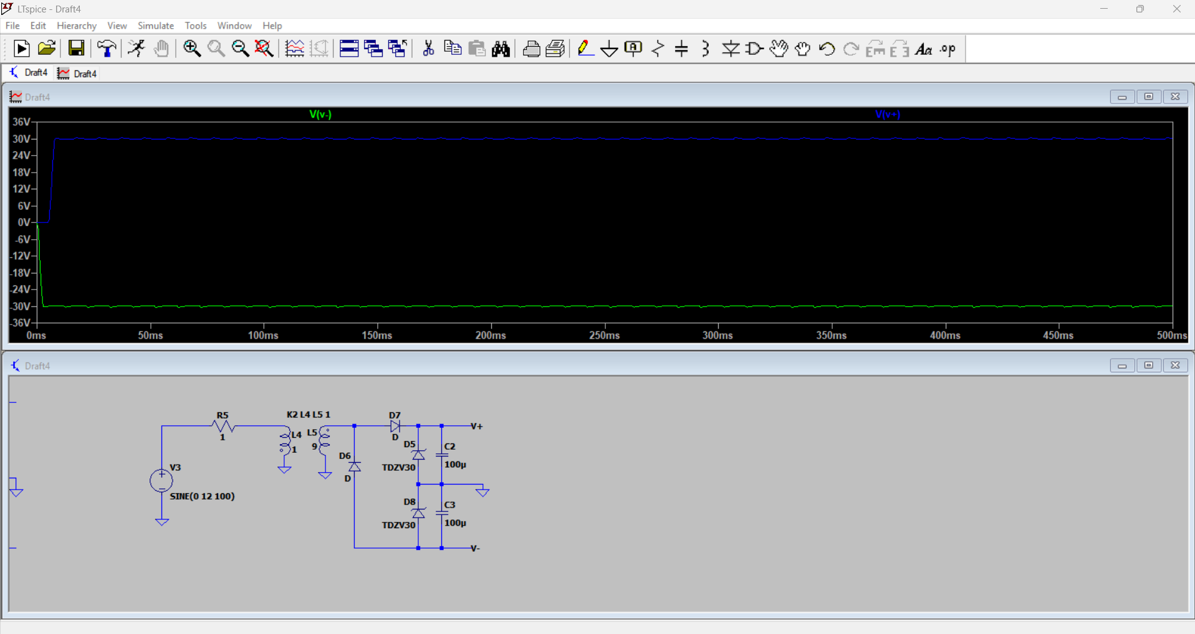
[picture p73: figure]

## DC-DC Converter


## Schematic Updates

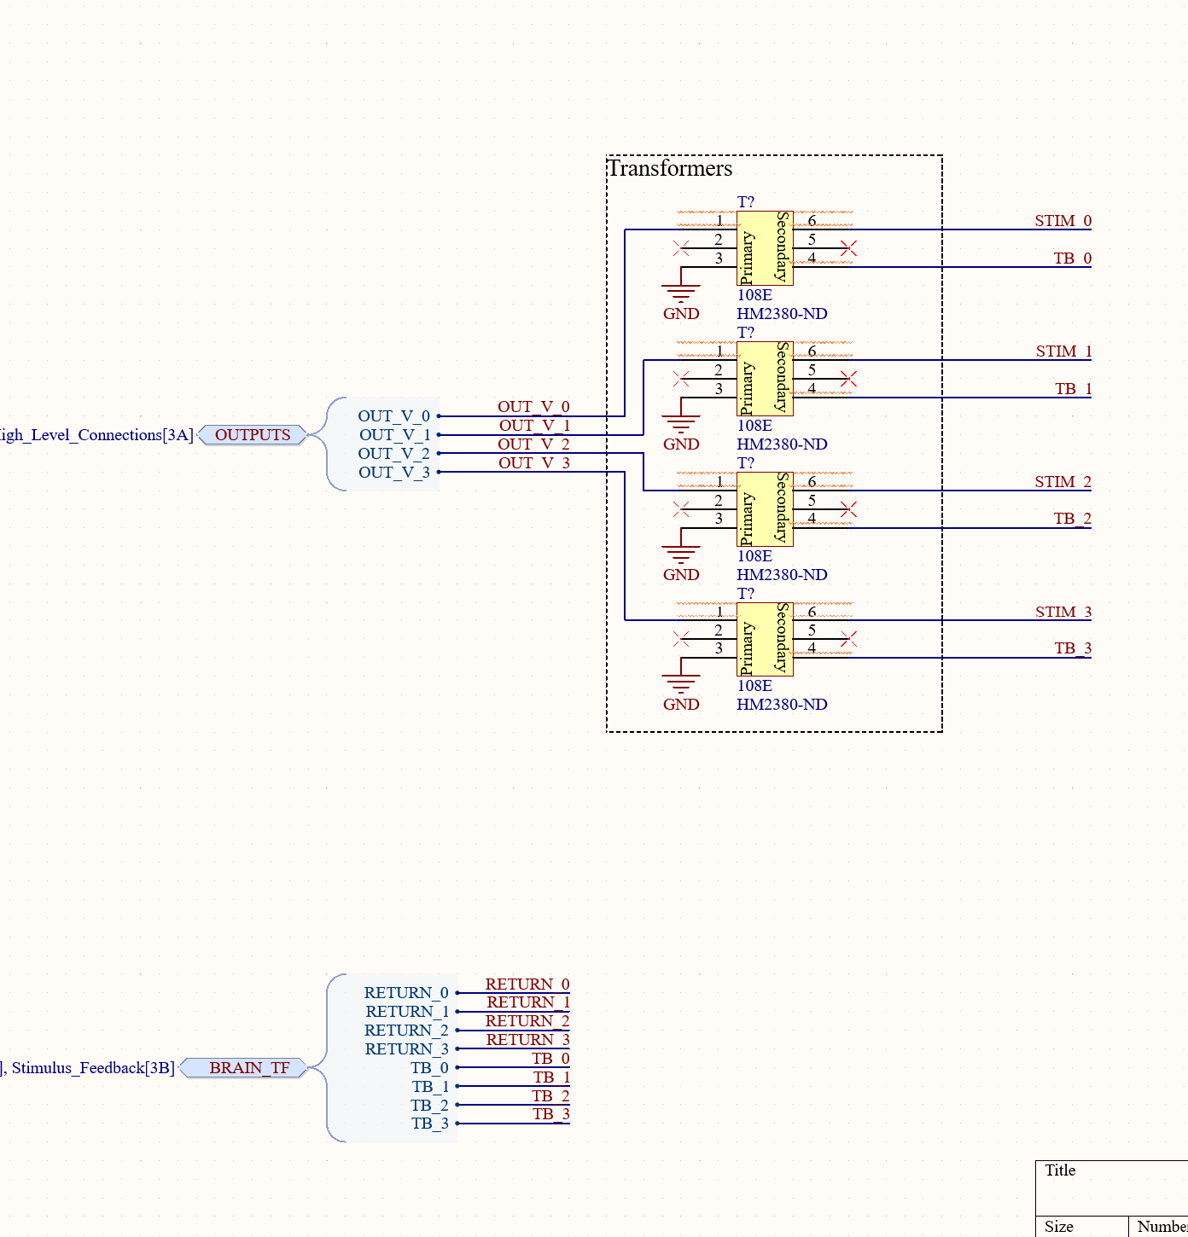
[picture p74: figure]
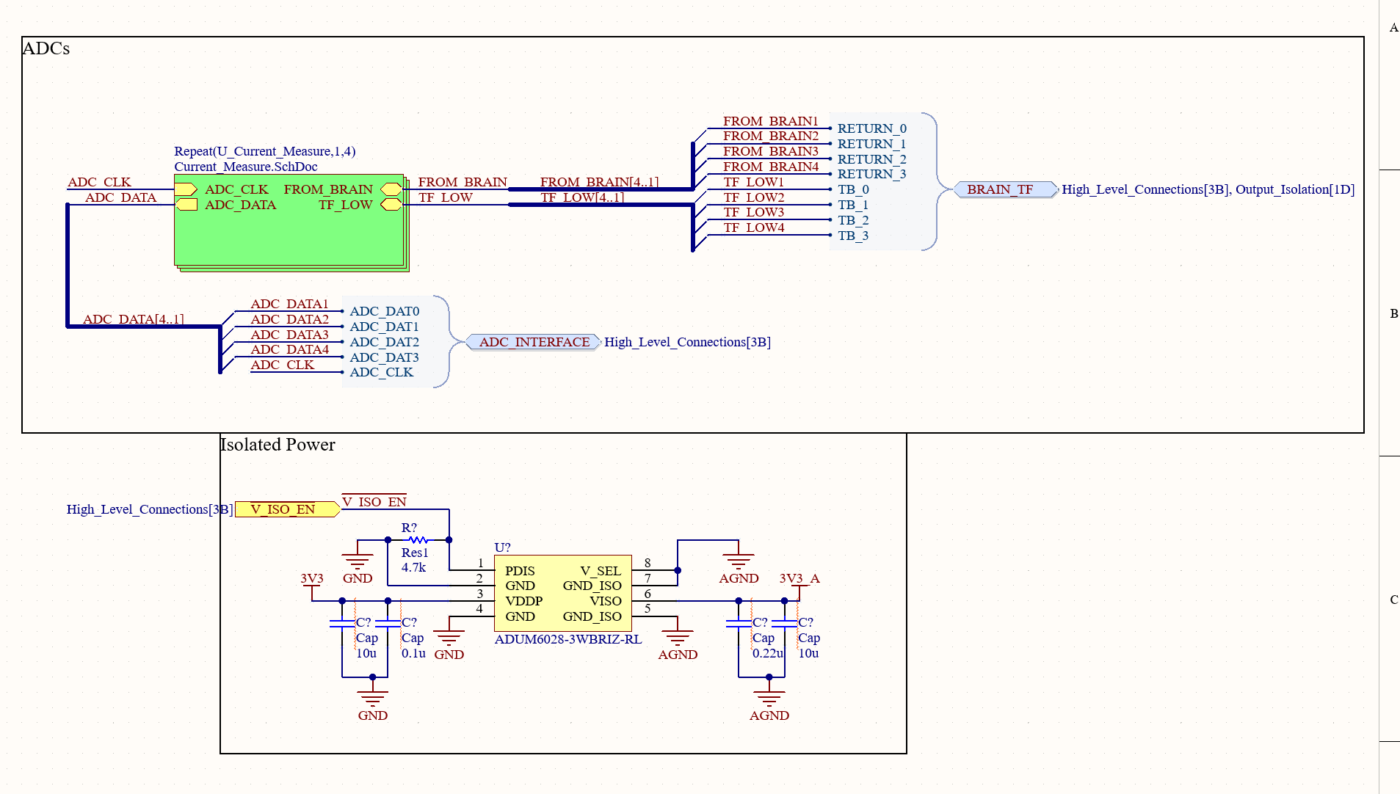
[picture p75: figure]

## Schematic Updates Continued

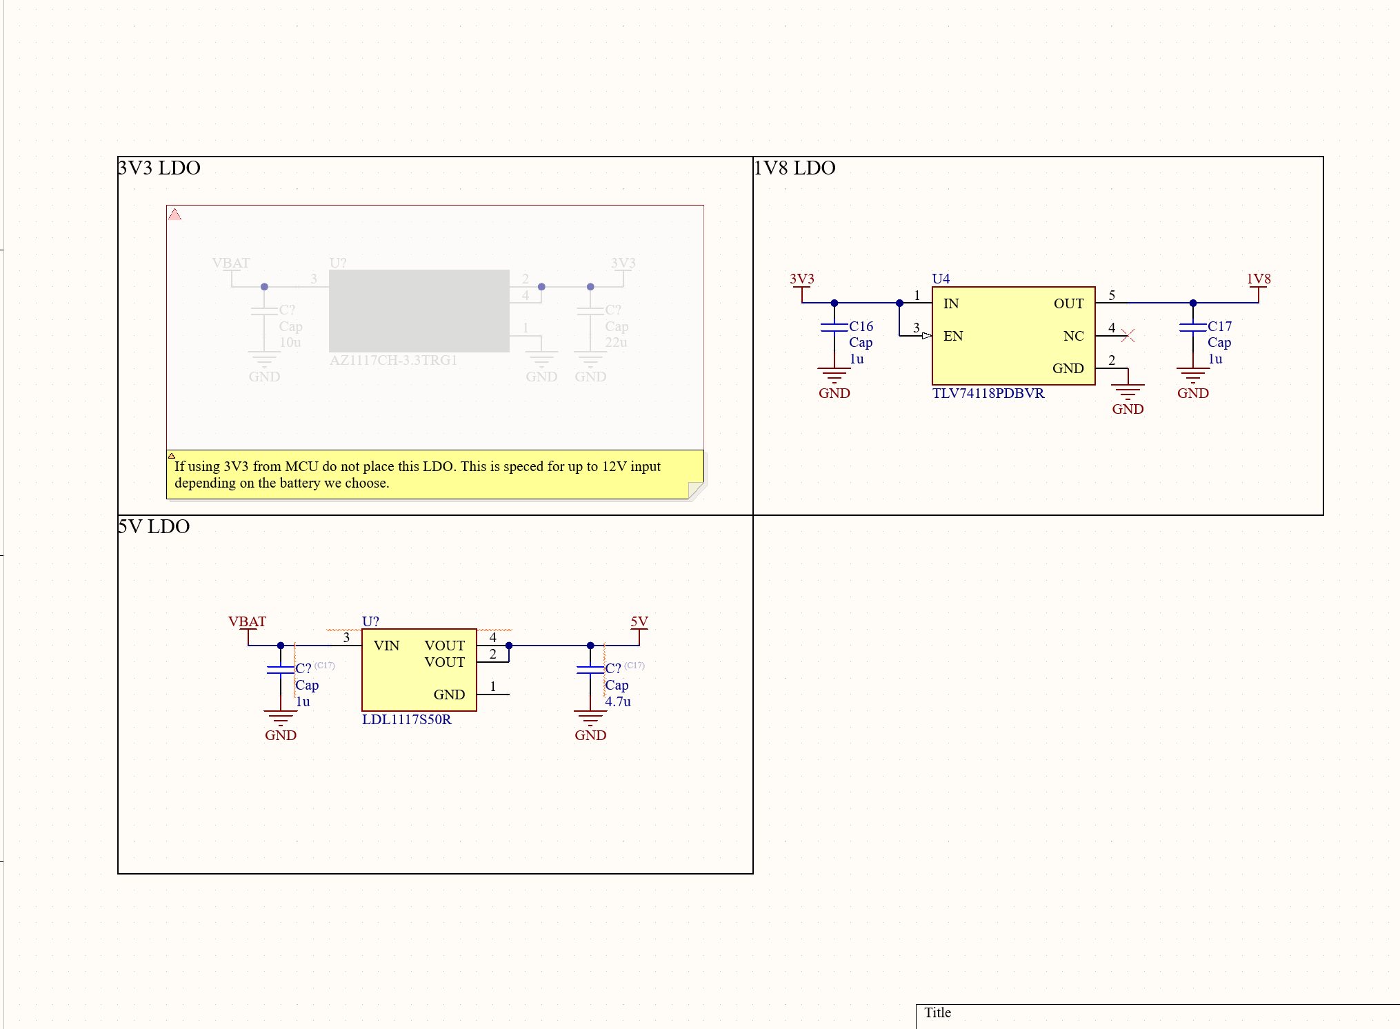
[picture p76: figure]

## DDS Test Board

- For SPI and programming – Doesn’t blow up!

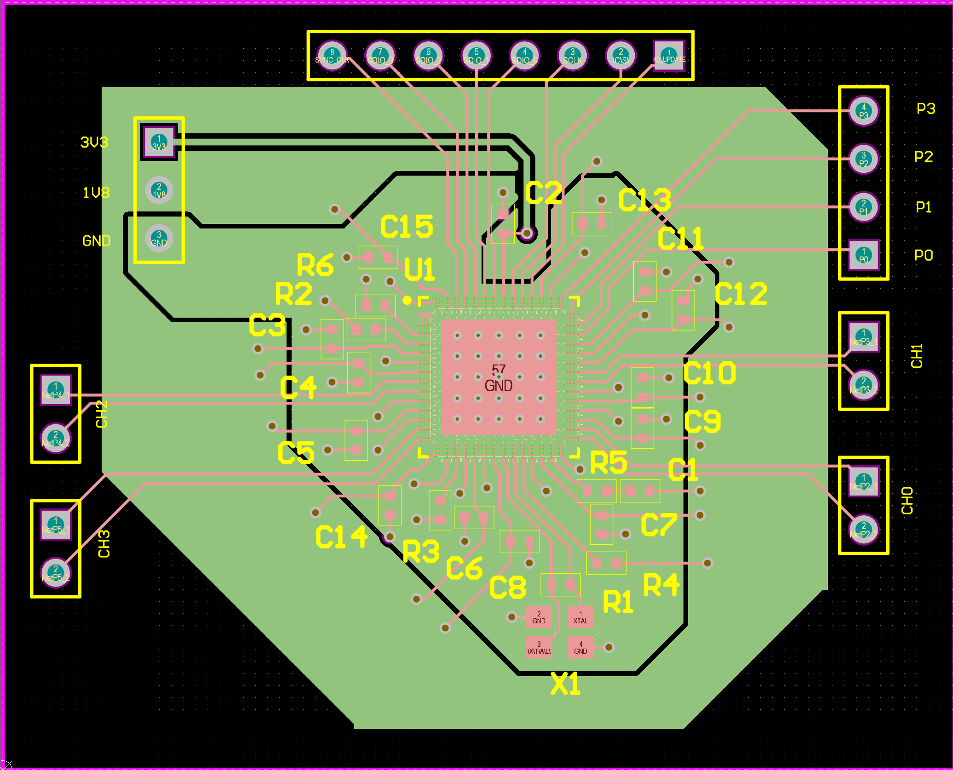
[picture p77: figure]

## ADC Breakout board

- Needs to be ordered and tested

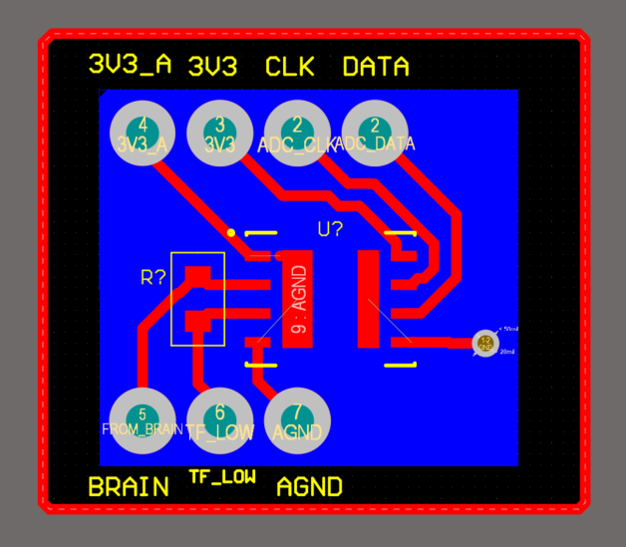
[picture p78: figure]

## DDS Board Testing

Connected DDS to RPI and attempted to initiate SPI transactions. Have so far been unable to see the transactions output on the designated SPI lines. Have not diagnosed the problem.

## Challenges so far

- Height limit with isolation transformers
- Amplifier sourcing/creation
- DDS Verificaiton

## Immediate Plan

- Continue schematic and symbol creation
- Find battery for device
- Determine board measurements for housing
- DDS Validation

## Questions/Feedback
