tylerwhite26/ECE_455_Brain_Stimulator/Presentations/Week_7_Presentation.pptx

## Samad, Guandong, and Tyler

- Brain Stimulator Progress Update

## Problem Description

Make a device that can generate waveforms of precise frequency and current to stimulate deep parts of the brain using electrodes.

## Key Events from Last Week

- Bluetooth connectivity with between rpi and web app
- App layout and backend
- Programmable gain amplifier schematic creation
- Continued battery search
- Power calculations

## Programmable Gain Amplifier

- On output of DDS to buffer up to 5V domain from 1V8 domain.
- Will this be able to switch on the fly? May need to be constant / amplitude specific

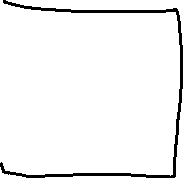
[picture p79: figure]

## Programmable Gain Amplifier

- On output of DDS to buffer up to 5V domain from 1V8 domain.
- Will this be able to switch on the fly? May need to be constant / amplitude specific

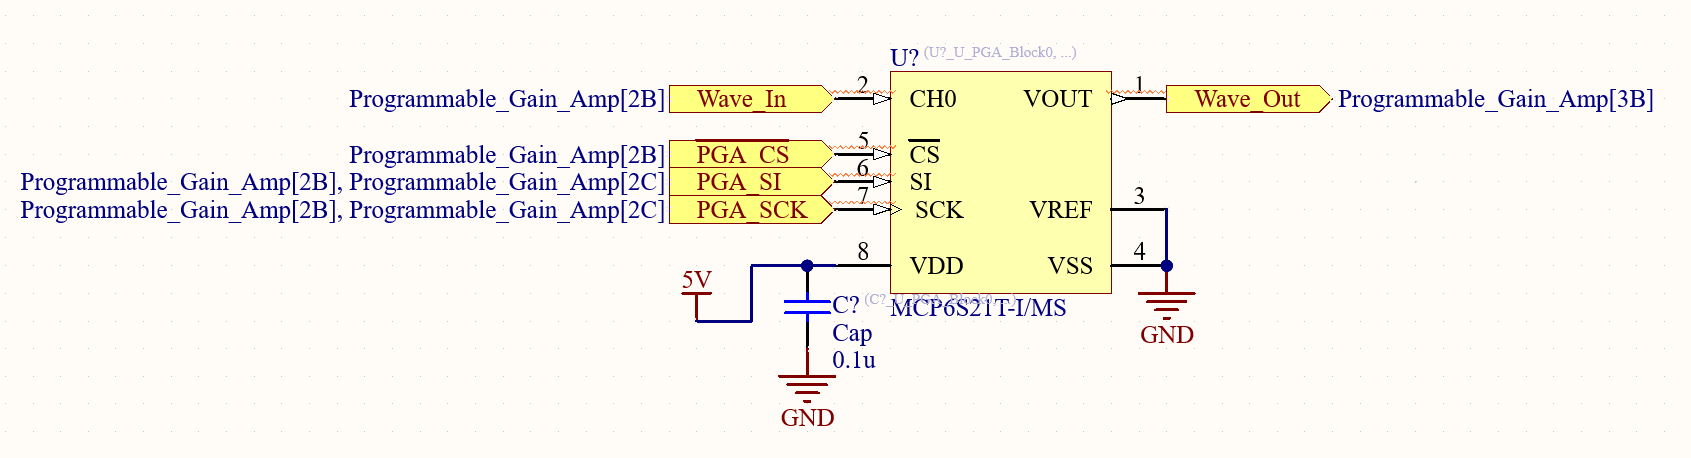
[picture p80: figure]

## PGA Tour (Routing)

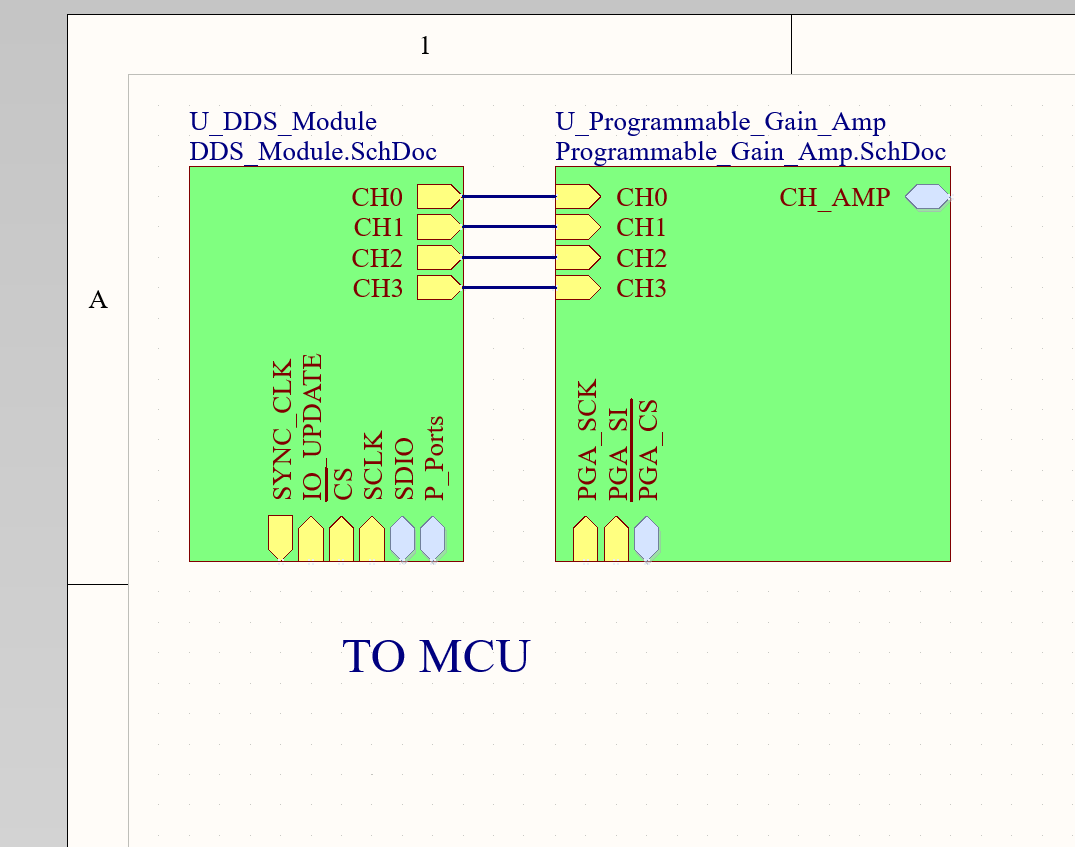
[picture p81: figure]
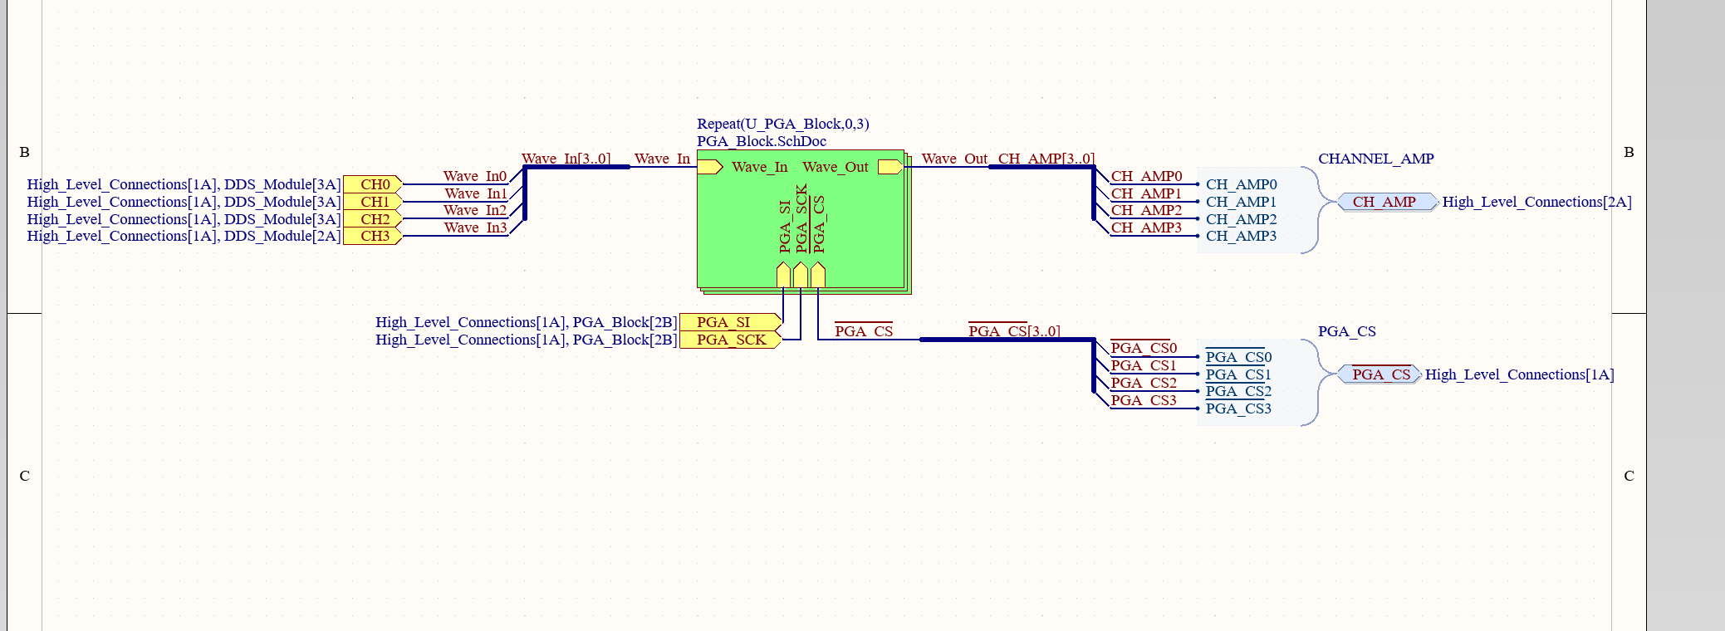
[picture p82: figure]

## Bluetooth Connection to the MCU (Raspberry pi Pico W)

Save two MicroPython modules in our RPi Pico to communicate via Bluetooth Low Energy

Helpers for generating BLE advertising payloads


Creates a simple BLE peripheral

https://electrocredible.com/raspberry-pi-pico-w-bluetooth-ble-micropython/

## SPI Testing with The Raspberry PI


This simulates writing to a function register in the DDS


Waveform caught by oscilloscope

- Next, we need to test it with DDS directly

## Web App

- Choosing browser based for best portability
- Using webbluetooth with JS
- Need room to expand easily to more channels

## Web App

- Enable/disable on outputs
- Beat frequency calculation
- Non-volatile programming capable (How to modify code? Constant address?)

## Web App Continued


(I <3 CSS)

## Web App Backend


## Writes to two channels


## RPI Backend


## Plans for Battery

- Calculate required amp hours to narrow search
- Find something with integrated BMS
- Use dimensions to make housing and board dimensions

## Simulation


## DC-DC Converter


## DDS Test Board

- For SPI and programming


## Challenges so far

- Height limit with isolation transformers
- Amplifier sourcing/creation
- Web app connection
- DDS Verificaiton

## Immediate Plan

- Continue schematic and symbol creation
- Find battery for device
- Determine board measurements for housing
- Code pairing and app integration
- DDS Verification / DDS Breakout Board assembly

## Questions/Feedback
