tylerwhite26/ECE_455_Brain_Stimulator/Presentations/Week_4_Presentation.pptx

## Samad, Guandong, and Tyler

- Brain Stimulator Progress Update

## Problem Description

Make a device that can generate waveforms of precise frequency and current to stimulate deep parts of the brain using electrodes.

## Key Events from Last Week

- Got simulation working on desired current source
- Started playing with test MCU
- Requested samples of components
- Started circuitry and layout for DDS segment
- Started footprints and symbols for ADC
- Tweaks to housing

## Voltage Controlled Current Source

Based on design by Jim Williams

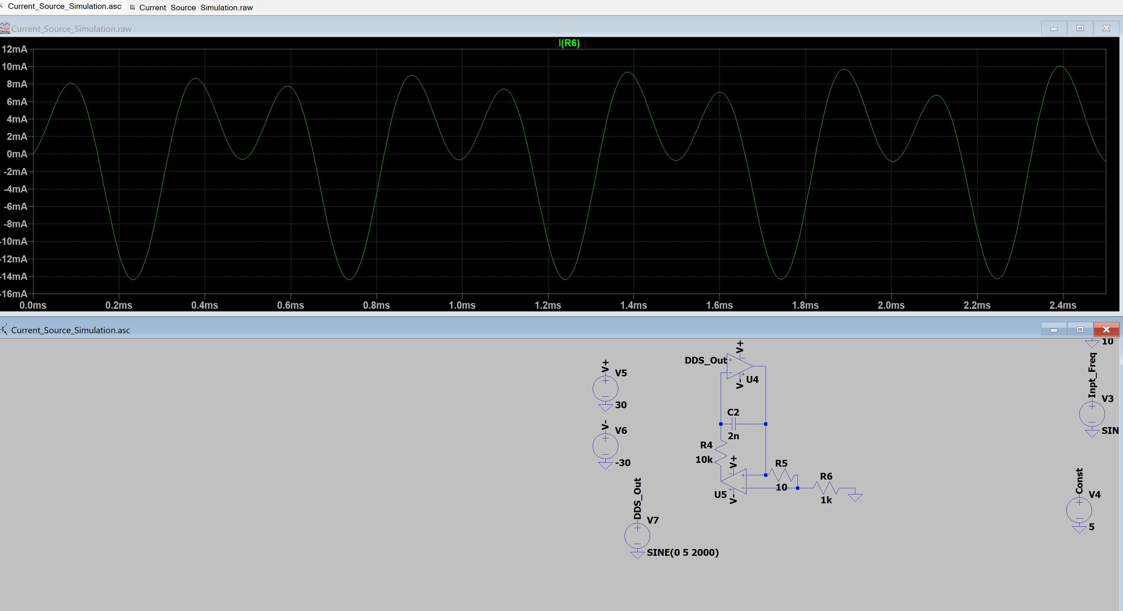
[picture p83: figure]

How to Design a Simple, Voltage-Controlled, Bidirectional Current Source - Technical Articles (https://www.allaboutcircuits.com/technical-articles/how-to-design-simple-voltage-controlled-bidirectional-analog-current-source/)

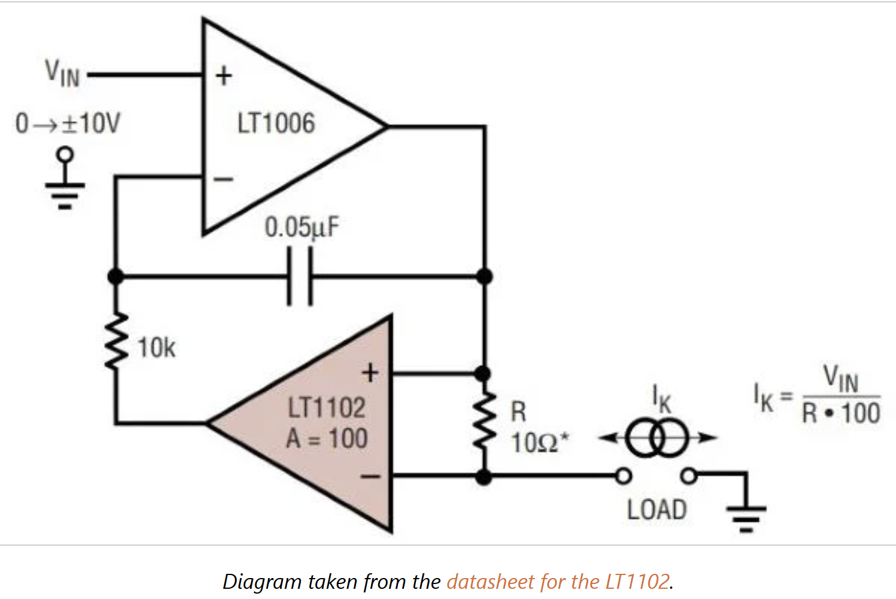
[picture p84: figure]

## Working Current Source

- Need to figure out better op amps for higher load
- Max load resistance right now is around 725Ohms

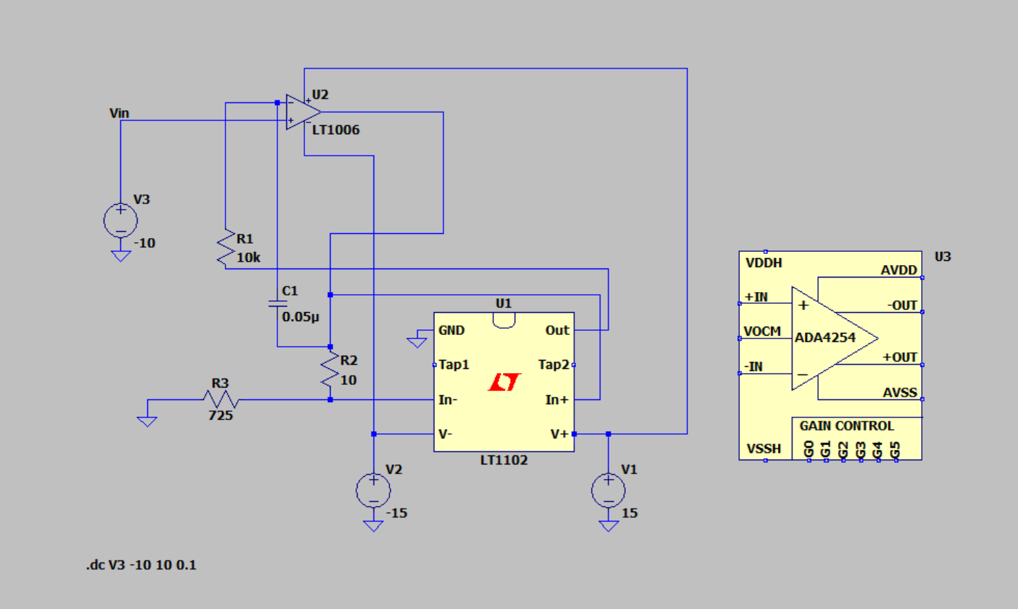
[picture p85: figure]
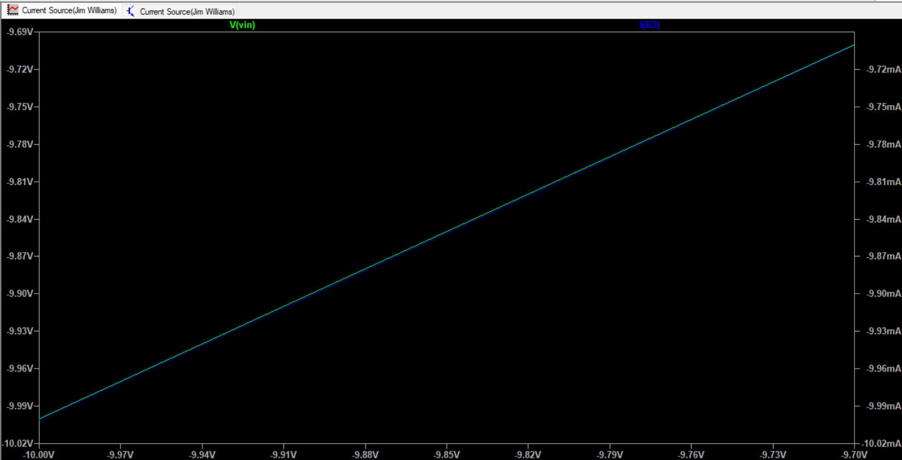
[picture p86: figure]

## DDS Module

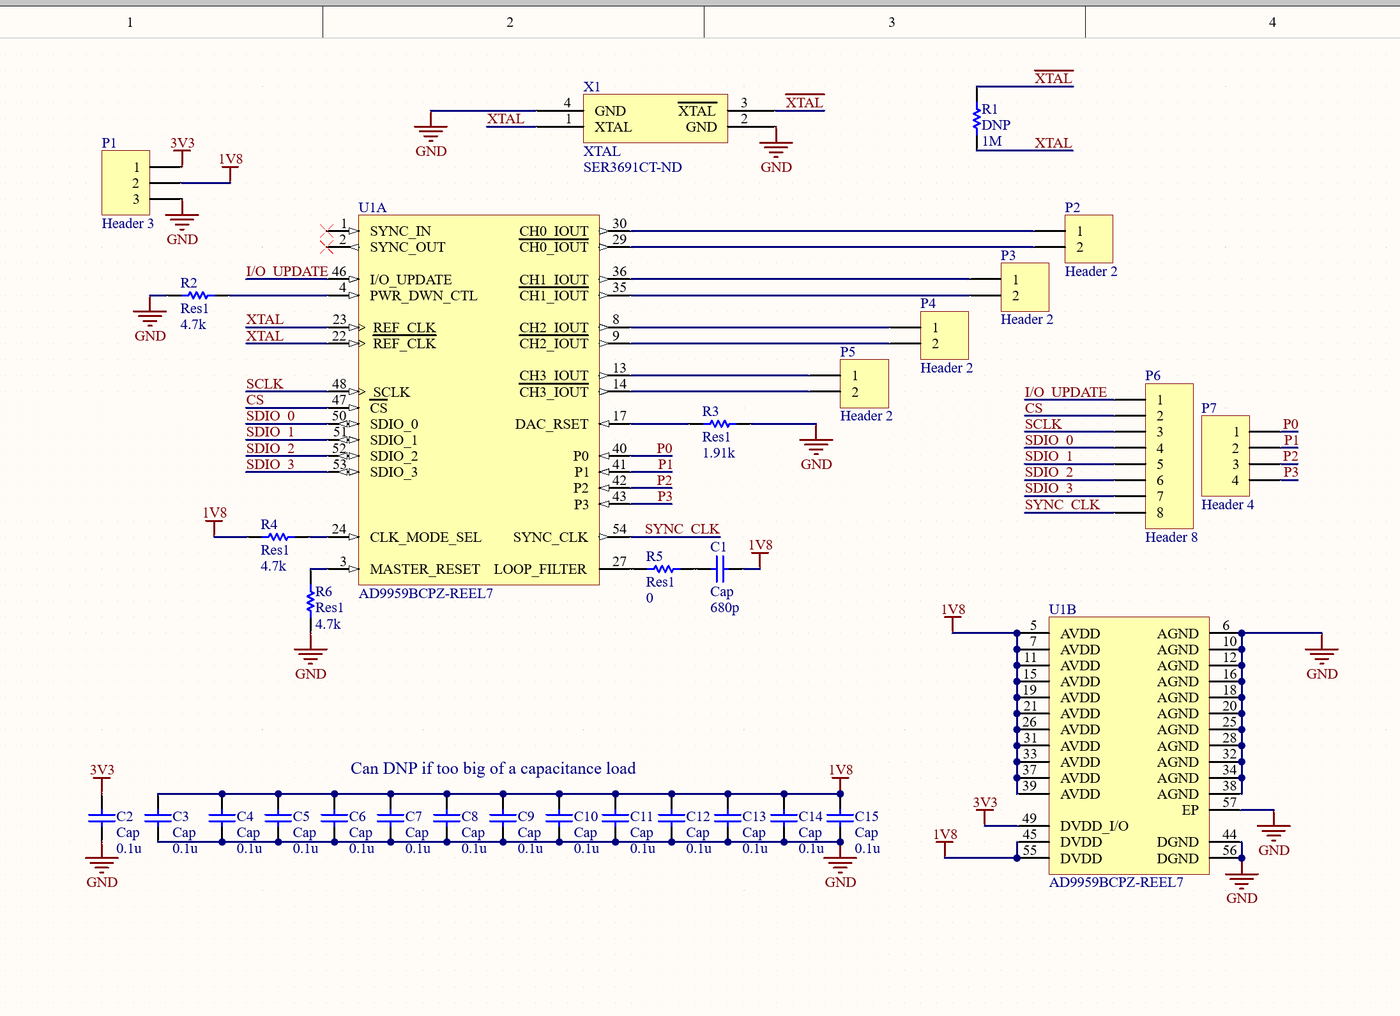
[picture p87: figure]
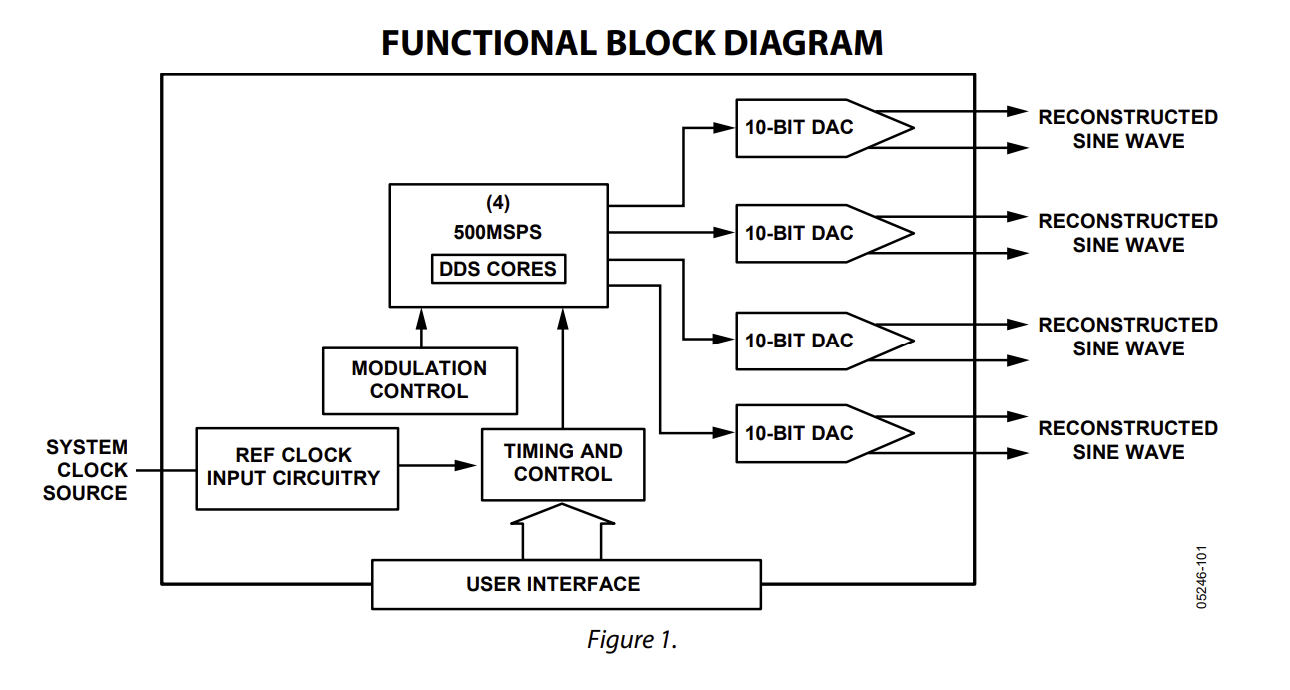
[picture p88: figure]

## DDS Module Continued


## ADC

- Need isolation for safety
- Should be able to communicate with MCU directly

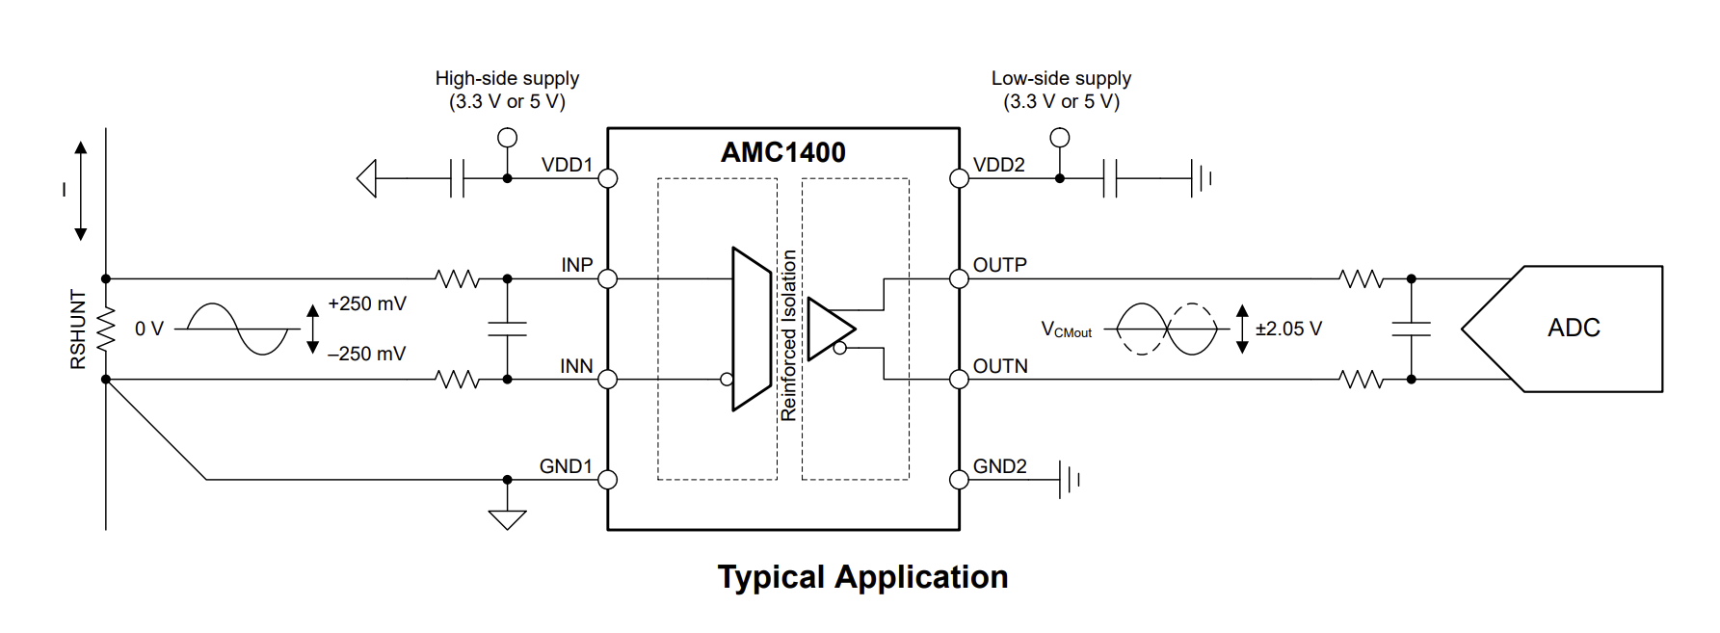
[picture p89: figure]

## Battery Feedback

Need 16 Hours Battery Life. Ideas so far:
- Have multiple batteries, one for isolated side and one for non-isolated side (MCU)
- Use a power bank so that no battery management circuitry is required

## High Voltage Rails

Need to drive to +/-30V with room for improvement.
- Use boost converter
- How do we minimize footprint?

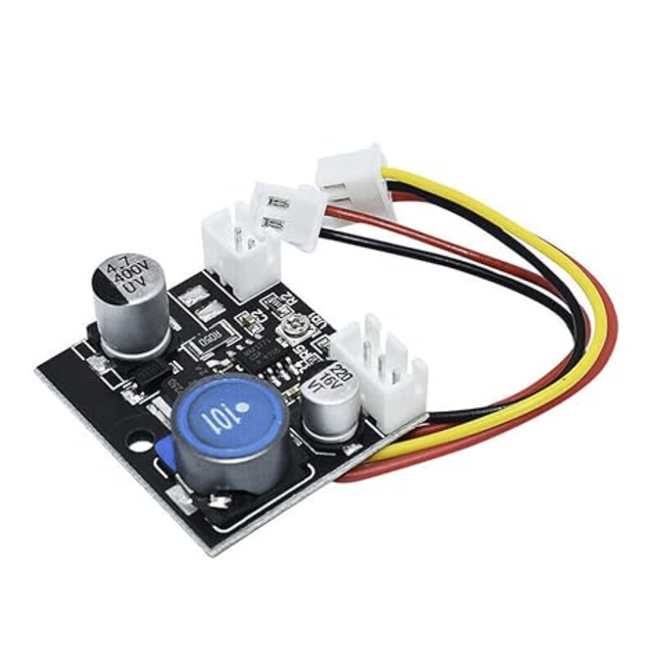
[picture p90: figure]

## Isolation

Leaning towards using inductors at the output
- Large space requirement, major downside, however not much taller than a banana jack anyway
- Would need less isolation before this point, everything on one battery
- Still easy to manage with a control loop through ADC

## Challenges so far

- Determining where to isolate from
- Finding MCU with Bluetooth capabilities

## Immediate Plan

- Continue schematic and symbol creation
- Find battery for device
- Find components for Jim Williams source that handle high voltage and simulate
- Determine board measurements for housing

## Questions/Feedback
