tylerwhite26/ECE_455_Brain_Stimulator/GANTT/GANTT_Chart.pdf

Untitled Gantt Project | Sep 12, 2025 http://
Project manager | Tyler
Project dates | Sep 5, 2025 - Dec 9, 2025
Completion | 0%
Tasks | 9
Resources | 3

Name | Begin date | End date
Component Sourcing | 9/5/25 | 9/19/25
Schematic and Symbol Creation | 9/12/25 | 9/24/25
Simulation | 9/12/25 | 9/19/25
PCB Layout | 9/17/25 | 10/1/25
Code Creation | 9/26/25 | 10/10/25
App Creation | 10/15/25 | 11/11/25
Housing Creation | 10/29/25 | 11/25/25
PCB Testing/Iteration | 10/29/25 | 11/25/25
Presentation Creation | 11/11/25 | 12/8/25
Untitled Gantt Project | Sep 12, 2025

# Tasks

Name | Default role
Tyler | project manager
Samad | undefined
Guandong | undefined

# Resources

# Gantt Chart

Name | Begin date End date
Component Sourcing | 9/5/25 | 9/19/25
Schematic and Sym... | 9/12/25 | 9/24/25
Simulation | 9/12/25 | 9/19/25
PCB Layout | 9/17/25 | 10/1/25
Code Creation | 9/26/25 | 10/10/25
App Creation | 10/15/25 | 11/11/25
Housing Creation | 10/29/25 | 11/25/25
PCB Testing/Iteration | 10/29/25 | 11/25/25
Presentation Creation | 11/11/25 | 12/8/25
September 2025 | October 2025 | November 2025 | December 2025 2 | 3 | 4 | 5 | 8 | 9 | 10 | 11 | 12 | 15 | 16 | 17 | 18 | 19 | 22 | 23 | 24 | 25 | 26 | 29 | 30 | 1 | 2 | 3 | 6 | 7 | 8 | 9 | 10 | 13 | 14 | 15 | 16 | 17 | 20 | 21 | 22 | 23 | 24 | 27 | 28 | 29 | 30 | 31 | 3 | 4 | 5 | 6 | 7 | 10 | 11 | 12 | 13 | 14 | 17 | 18 | 19 | 20 | 21 | 24 | 25 | 26 | 27 | 28 | 1 | 2 | 3

4

5

8

Component Sourcing

# Resources Chart

Name | Default role
Tyler | project man...

## Component Sourcing

## PCB Layout

Schematic and Symbol ...

## App Creation

## Simulation

## PCB Testing/Iteration

## Presentation Creation

Samad | undefined

## Component Sourcing

## PCB Layout

Schematic and Symbol ...

## Code Creation

## App Creation

## PCB Testing/Iteration

## Presentation Creation

Guandong | undefined

## Component Sourcing

## Housing Creation

## PCB Testing/Iteration

## Presentation Creation

10% | 10% | 45% | 45% | | 80% | 55% | | 55% | | | 50% | 50% | 50% | 80% | 80% | 80% | 90% | 40% | 40% | 40% | 10% | 10% | 10%
10% | 10% | | 10%
| | | | 55% | 55% | | | 55%
| | 25% | 25% | | 25%
| | | | | | | | | | | 50% | 50% | 50% | | 50% | 50%
| | 10% | 10%
| | | | | | | | | | | | | | 30% | 30% | 30% | | | 30% | 30%
| | | | | | | | | | | | | | | | | 10% | | 10% | 10% | | 10% | 10%
10% | 10% | 35% | 35% | 65% | 55% | 30% | 80% | 80% | 50% | 50% | 30% | 30% | 30% | 40% | 40% | 40% | 50% | 20% | 20% | 20% | 10% | 10% | 10%
10% | 10% | | 10%
| | | | 30% | 30% | | | 30%
| | 25% | 25% | | 25%
| | | | | | | 50% | 50% | | 50%
| | | | | | | | | | | 30% | 30% | 30% | | 30% | 30%
| | | | | | | | | | | | | | 10% | 10% | 10% | | | 10% | 10%
| | | | | | | | | | | | | | | | | 10% | | 10% | 10% | | 10% | 10%
90% | 90% | | 90% | | | | | | | | | | | 80% | 80% | 80% | 90% | | 90% | 90% | 10% | 10% | 10%
90% | 90% | | 90%
| | | | | | | | | | | | | | 50% | 50% | 50% | | | 50% | 50%
| | | | | | | | | | | | | | 30% | 30% | 30% | | | 30% | 30%
| | | | | | | | | | | | | | | | | 10% | | 10% | 10% | | 10% | 10%
September 2025 | October 2025 | November 2025 | December 2025 2 | 3 | 4 | 5 | 8 | 9 | 10 | 11 | 12 | 15 | 16 | 17 | 18 | 19 | 22 | 23 | 24 | 25 | 26 | 29 | 30 | 1 | 2 | 3 | 6 | 7 | 8 | 9 | 10 | 13 | 14 | 15 | 16 | 17 | 20 | 21 | 22 | 23 | 24 | 27 | 28 | 29 | 30 | 31 | 3 | 4 | 5 | 6 | 7 | 10 | 11 | 12 | 13 | 14 | 17 | 18 | 19 | 20 | 21 | 24 | 25 | 26 | 27 | 28 | 1 | 2 | 3

4

5

8
