tylerwhite26/ECE_455_Brain_Stimulator/Final_Report/Figures/TylerWhite-ECE455.tiff

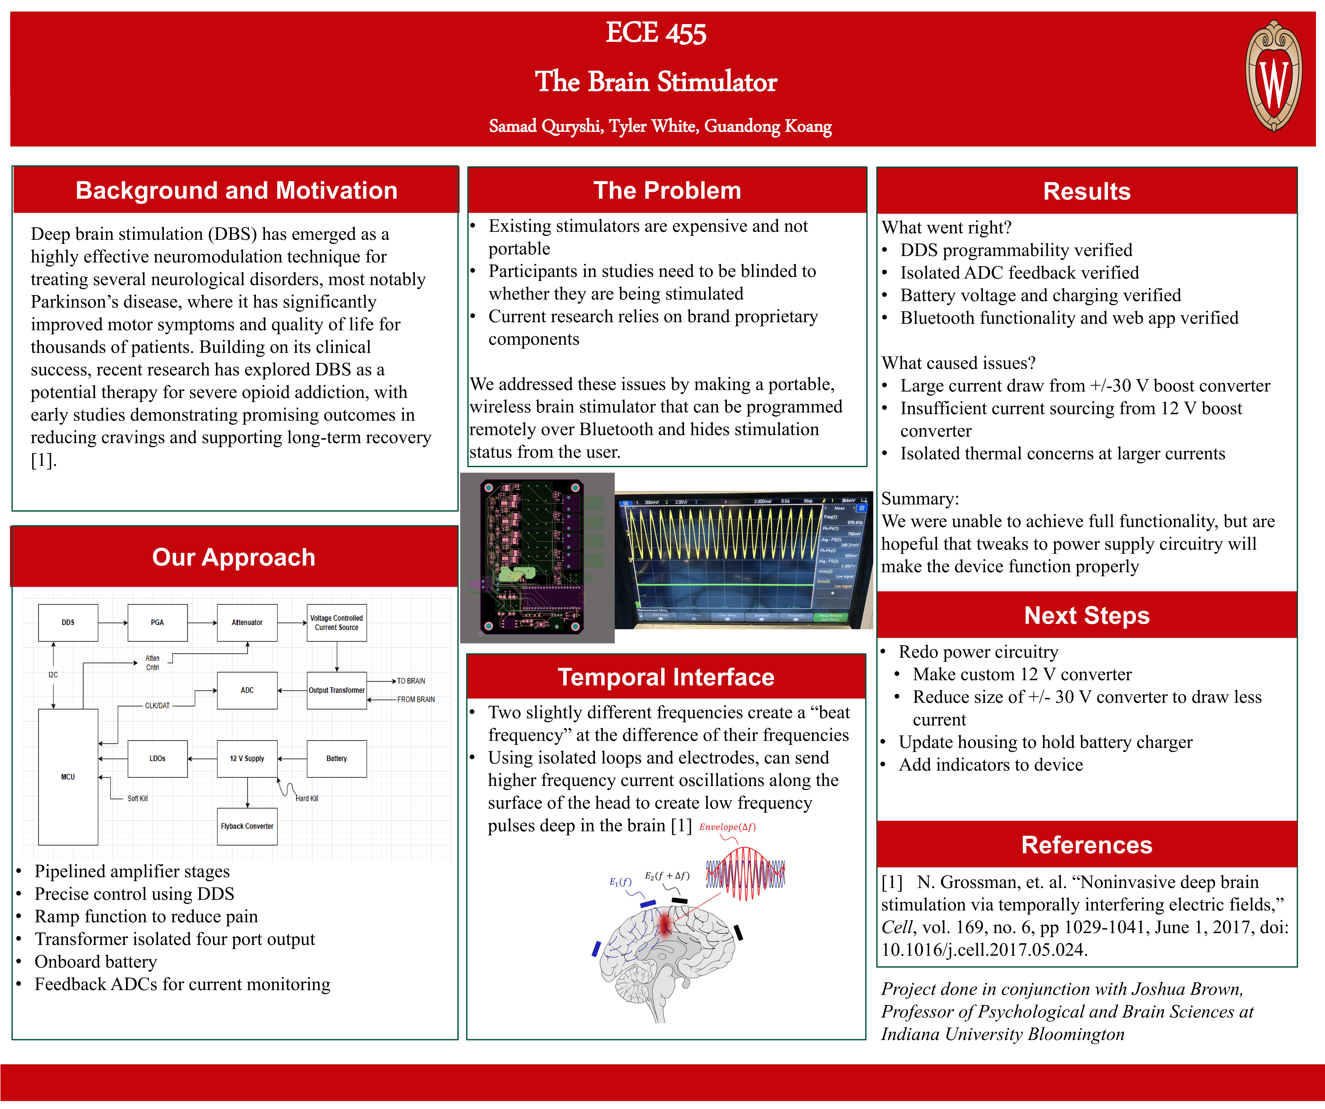
Final_Report/Figures/TylerWhite-ECE455.tiff
