tylerwhite26/ECE_455_Brain_Stimulator/Final_Report/Hardware_Pics/thumbnail_IMG_1137.jpg

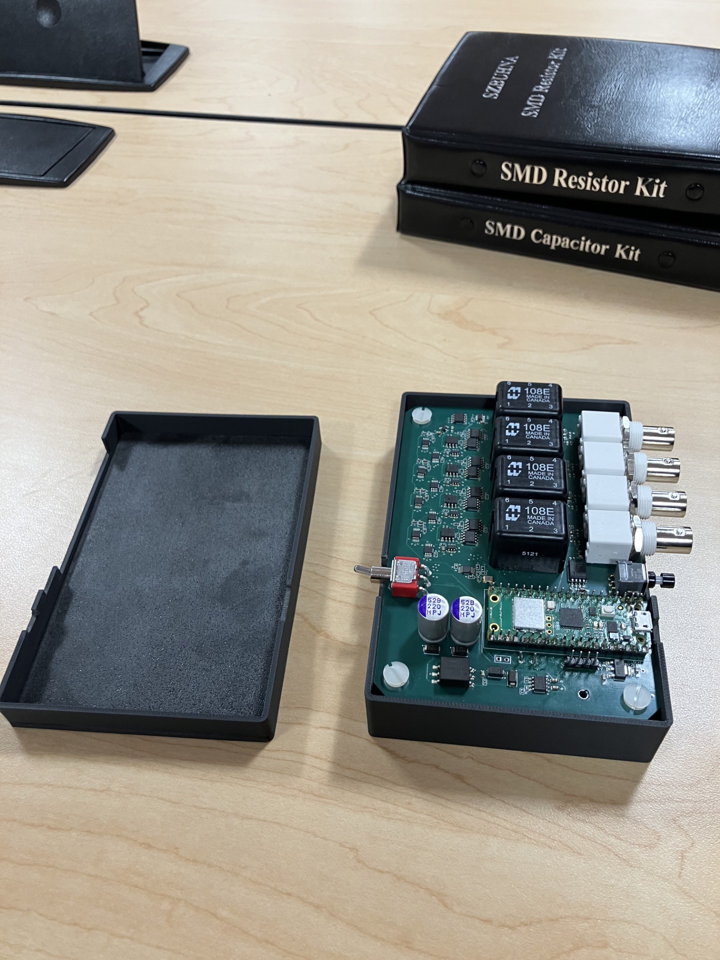
Final_Report/Hardware_Pics/thumbnail_IMG_1137.jpg
