tylerwhite26/ECE_455_Brain_Stimulator/Presentations/Pictures_Week_5/Curr_Meas.png

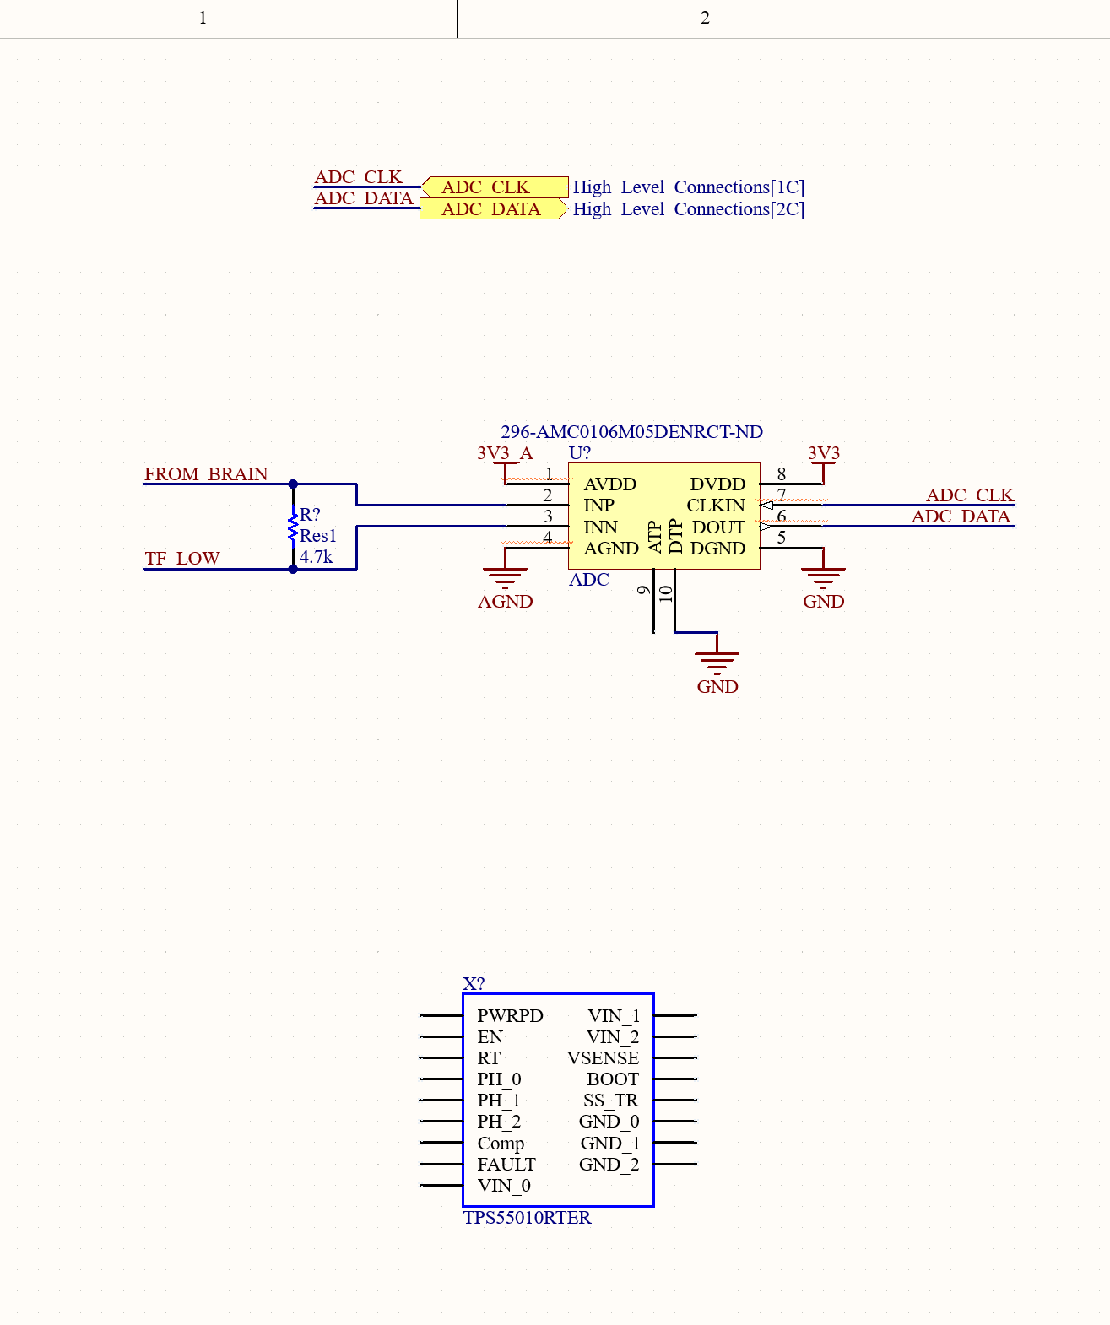
Presentations/Pictures_Week_5/Curr_Meas.png
