tylerwhite26/ECE_455_Brain_Stimulator/Presentations/Pictures_Week_5/DDS_Chips.jpeg

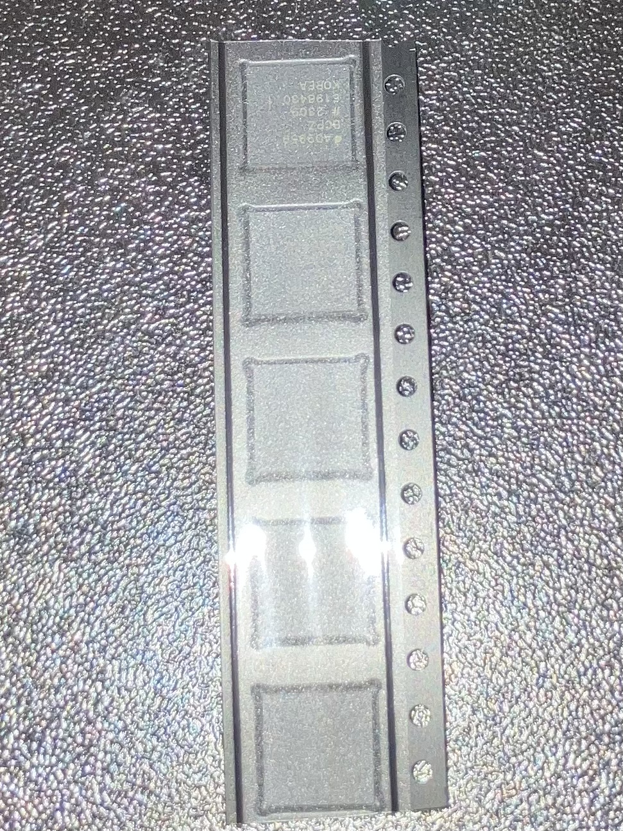
Presentations/Pictures_Week_5/DDS_Chips.jpeg
