tylerwhite26/ECE_455_Brain_Stimulator/Presentations/Pictures_Week_5/LDOs.png

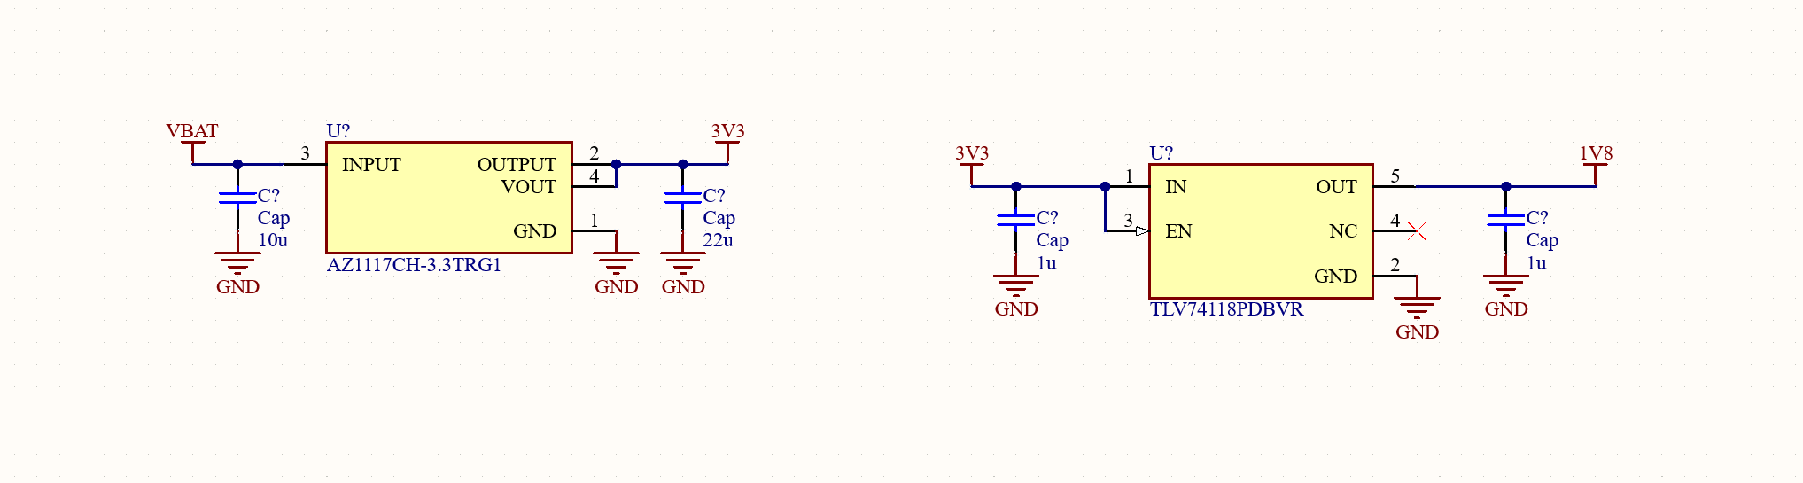
Presentations/Pictures_Week_5/LDOs.png
