tylerwhite26/ECE_455_Brain_Stimulator/Presentations/Pictures_Week_5/MCU.png

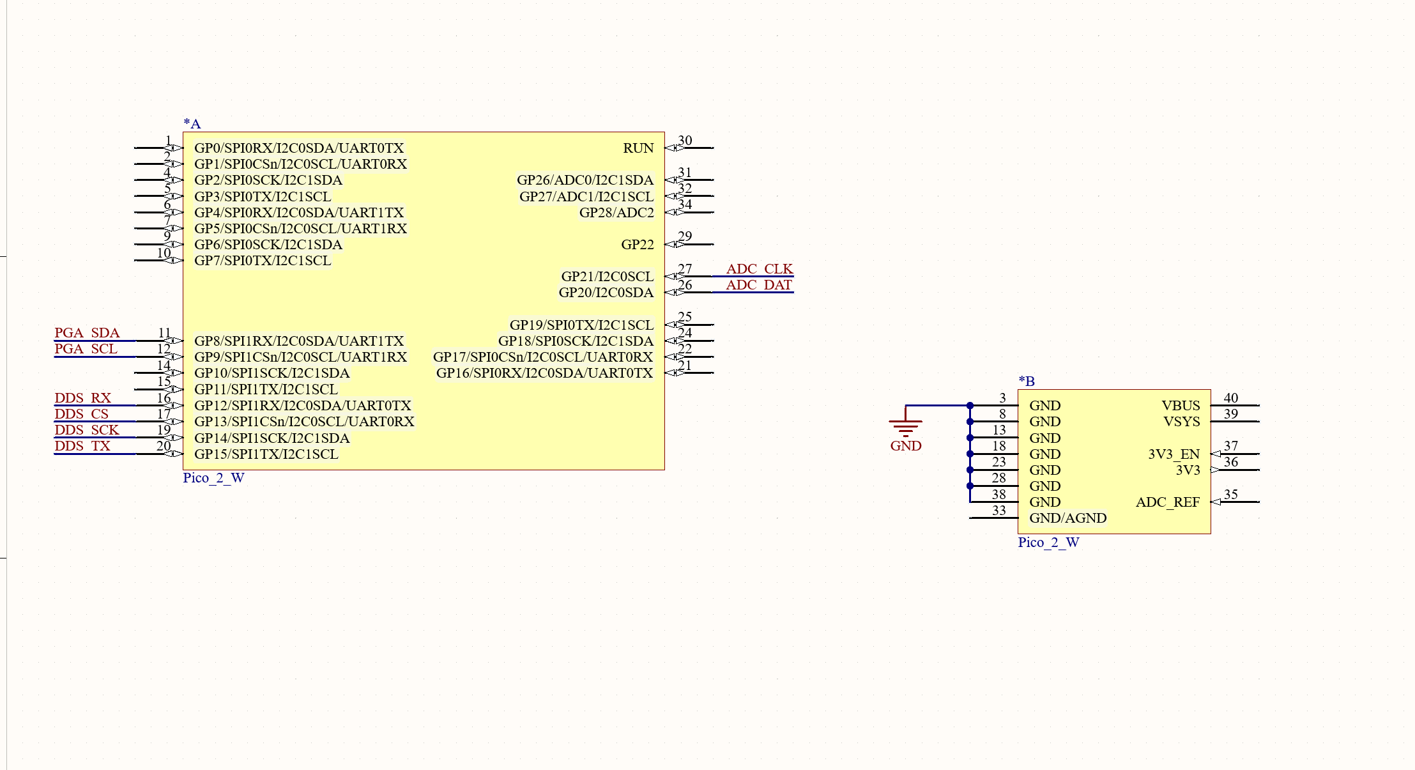
Presentations/Pictures_Week_5/MCU.png
