tylerwhite26/ECE_455_Brain_Stimulator/Presentations/Pictures_Week_5/MCU_Pinout.jpeg

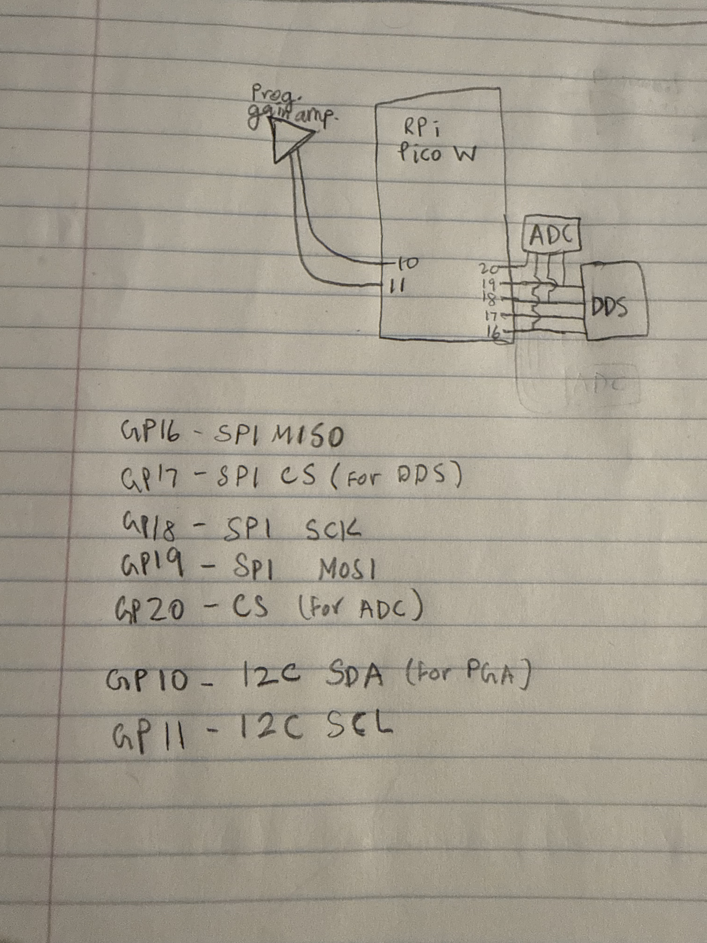
Presentations/Pictures_Week_5/MCU_Pinout.jpeg
