tylerwhite26/ECE_455_Brain_Stimulator/Presentations/Pictures_Week_6/Web_App.png

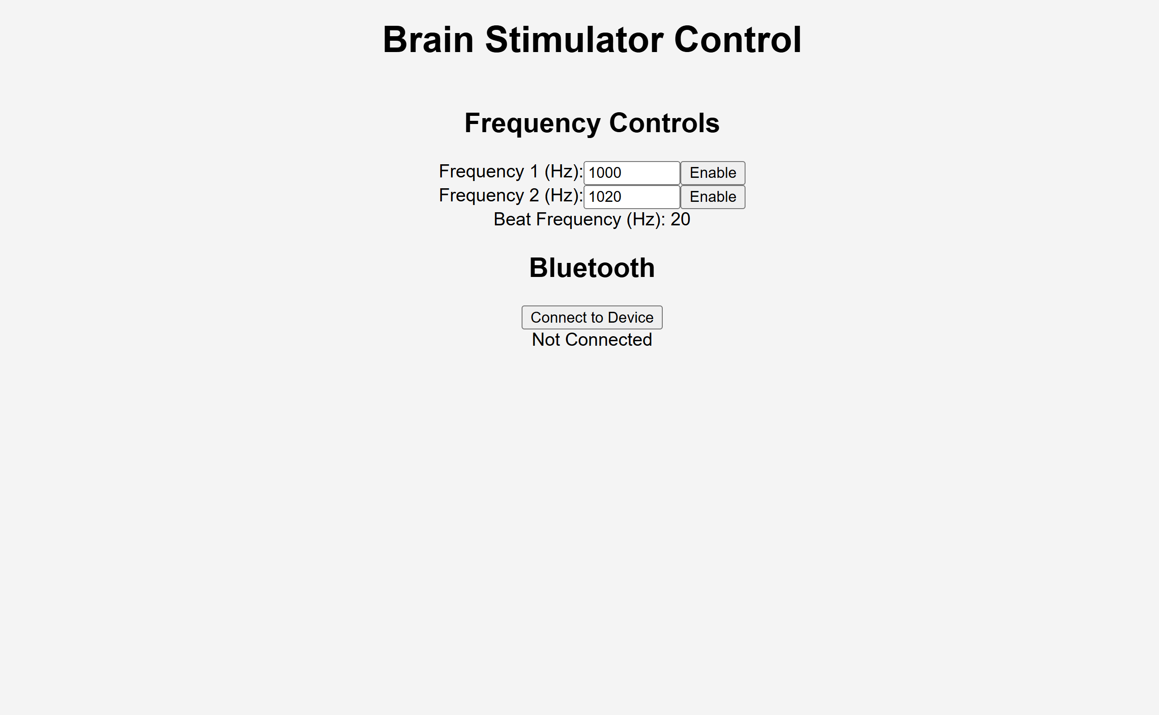
Presentations/Pictures_Week_6/Web_App.png
