tylerwhite26/ECE_455_Brain_Stimulator/Presentations/Pictures_Week_7/Screenshot 2025-10-15 111507.png

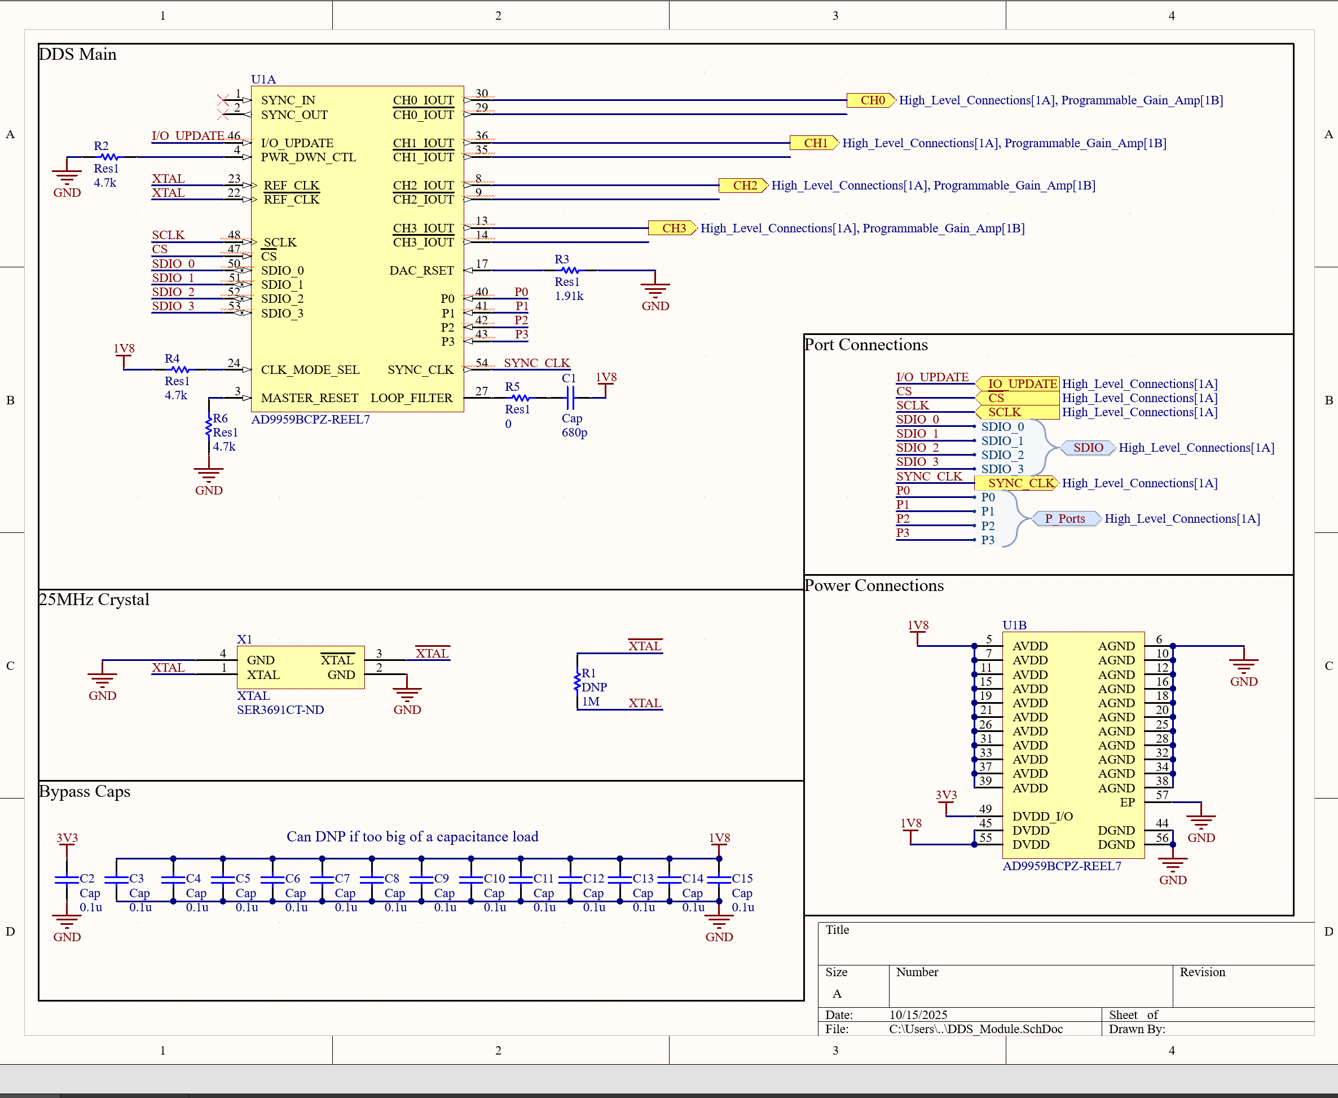
Presentations/Pictures_Week_7/Screenshot 2025-10-15 111507.png
