tylerwhite26/ECE_455_Brain_Stimulator/Financials/Cost_Tracking.xlsx

Product Name | Quantity Ordered | Cost | Order/Invoice Date
DDS Test Board | 5 | 33.15 | 2025-10-10 | Total Cost: | 102.76
SMD Resistor Book | 1 | 31.64 | 2025-10-15 | Remaining Budget: | 397.24
SMD Capacitor Book | 1 | 37.97 | 2025-10-15
