tylerwhite26/ECE_455_Brain_Stimulator/PCB/Brain_Stimulator/Project Outputs for Brain_Stimulator/BOM/Final_Bom-Brain_Stimulator.xlsx

Comment | Description | Designator | Footprint | LibRef | Quantity | On Hand | Needed
Push toggle button |  | B1 | BB16AH-FA | BB16AH-FA | 1 | 0 | 1
Cap | Capacitor | C1, C3, C5, C10, C11, C12_U_Current_Source1, C12_U_Current_Source2, C12_U_Current_Source3, C12_U_Current_Source4, C13, C14_U_Current_Measure1, C14_U_Current_Measure2, C14_U_Current_Measure3, C14_U_Current_Measure4, C15_U_Current_Measure1, C15_U_Current_Measure2, C15_U_Current_Measure3, C15_U_Current_Measure4, C16, C17, C20, C21, C23, C24, C25, C26 | CAPC1608X05N | Cap | 26 | 0 | 26
220uF Cap |  | C2, C4 | A759KR227M1VAAE024 | A759KR227M1VAAE024 | 2 | 0 | 2
Cap | Capacitor | C6, C7, C8, C9, C22_U_PGA_Block1, C22_U_PGA_Block2, C22_U_PGA_Block3, C22_U_PGA_Block4, C27_U_Small_DDS1, C27_U_Small_DDS2, C27_U_Small_DDS3, C27_U_Small_DDS4, C28_U_Small_DDS1, C28_U_Small_DDS2, C28_U_Small_DDS3, C28_U_Small_DDS4, C29_U_Small_DDS1, C29_U_Small_DDS2, C29_U_Small_DDS3, C29_U_Small_DDS4, C30_U_Small_DDS1, C30_U_Small_DDS2, C30_U_Small_DDS3, C30_U_Small_DDS4 | 0402_Res | Cap | 24 | 0 | 24
Schottky 60V |  | D1, D4, D6 | SK36A-LTP - duplicate | SK36A-LTP | 3 | 3 | 0
Zener 30V |  | D2, D3 | SMBJ5363B-TP | SMBJ5363B-TP | 2 | 2 | 0
Zener 24V |  | D5 | CMZ5934B TR13 PBFREE | CMZ5934B TR13 PBFREE | 1 | 1 | 0
M4 Mounting Hole |  | H1, H2, H3, H4 | Mounting Hole | MOUNTING HOLE M4 | 4 | 4 | 0
BNC Connector |  | J1, J2, J3, J4 | CONBNC002 | CONBNC002 | 4 | 0 | 4
Flyback Transformer |  | L1 | 750319949 | 750319949 | 1 | 1 | 0
Header 2 | Header, 2-Pin | P1 | HDR1X2 | Header 2 | 1 | 1 | 0
Res1 | Resistor | R1, R2, R3, R4, R7_U_Current_Measure1, R7_U_Current_Measure2, R7_U_Current_Measure3, R7_U_Current_Measure4, R8 | 0402_Res | Res1 | 9 | 0 | 9
DNP | Resistor | R5, R6, R9, R10_U_Current_Source1, R10_U_Current_Source2, R10_U_Current_Source3, R10_U_Current_Source4, R11_U_Current_Source1, R11_U_Current_Source2, R11_U_Current_Source3, R11_U_Current_Source4, R12_U_Current_Source1, R12_U_Current_Source2, R12_U_Current_Source3, R12_U_Current_Source4, R13_U_Current_Source1, R13_U_Current_Source2, R13_U_Current_Source3, R13_U_Current_Source4, R14_U_Current_Source1, R14_U_Current_Source2, R14_U_Current_Source3, R14_U_Current_Source4, R15_U_Current_Source1, R15_U_Current_Source2, R15_U_Current_Source3, R15_U_Current_Source4, R16, RUSB | 0402_Res | Res1 | 29 | 0 | 29
100SP1T2B4M6QE |  | S1 | 100SP1T2B4M6QE | 100SP1T2B4M6QE | 1 | 0 | 1
108E |  | T1, T2, T3, T4 | 108E | 108E | 4 | 0 | 4
RASPBERRY_PI_PICO | Raspberry Pi Board, Arm Cortex-M0+; Core Architecture:Arm; Core Sub-Architecture:Cortex-M0+; Kit Contents:Raspberry Pi Pico Board; No. Of Bits:32Bit; Silicon Core Number:Rp2040; Silicon Manufacturer:Raspberry Pi |Raspberry-Pi RASPBERRY PI PICO | U1 | RASPBERRY_PI_PICO | RASPBERRY_PI_PICO | 1 | 1 | 0
ADC |  | U2_U_Current_Measure1, U2_U_Current_Measure2, U2_U_Current_Measure3, U2_U_Current_Measure4 | SON65P350X100_HS-9N | ADC | 4 | 4 | 0
LDL1117S50R | IC REG LINEAR 5V 1.2A SOT223 | U3, U5 | FP-SOT-223-0046067_14-MFG | CMP-12153-000005-1 | 2 | 0 | 2
TLV74118PDBVR | None | U4 | FP-DBV0005A-IPC_C | CMP-04917-000111-2 | 1 | 1 | 0
MCP6S21T-I/MS | Single-Ended, Rail-to-Rail Input/Output, Low-Gain Programmable Gain Amplifier, 8-Pin MSOP, Industrial Temperature, Tape and Reel | U6_U_PGA_Block1, U6_U_PGA_Block2, U6_U_PGA_Block3, U6_U_PGA_Block4 | MSOP-MS8_N | CMP-0187-00515-2 | 4 | 0 | 4
ADUM6028-3WBRIZ-RL |  | U7 | ADUM6028-3WBRIZ-RL | ADUM6028-3WBRIZ-RL | 1 | 1 | 0
AD9833BRMZ | Low Power, 12.65 mW, 2.3 V to 5.5 V, Programmable Waveform Generator, 10-Bit, Serial, RM-10, 50 Tube, Pb-Free | U8_U_Small_DDS1, U8_U_Small_DDS2, U8_U_Small_DDS3, U8_U_Small_DDS4 | ADI-RM-10_M | CMP-0293-00077-1 | 4 | 4 | 0
LT8302ES8E#TRPBF | Micropower No-Opto Isolated Flyback Converter, 2.8 to 42 V, -40 to 125 degC, 8-Pin SOIC (S8E), RoHS, Tape and Reel | U9 | LT-S8E-8_V | CMP-0492-02712-1 | 1 | 1 | 0
Si5351A-B-GT | I2C-Programmable Any-Frequency CMOS Clock Generator + VCXO, 2.5 / 3.3 V, 0.008 to 160 MHz Output, -40 to 85 degC, 10-pin SOP | U10 | SLAB-MSOP-10_N | CMP-0510-00012-1 | 1 | 0 | 1
OPA454AIDDA | High Voltage (100V), High-Current (50mA) Operational Amplifier, G=1 Stable, 10 to 100 V, -55 to 125 degC, 8-pin SOP (DDA8), Green (RoHS & no Sb/Br) | U11_U_Current_Source1, U11_U_Current_Source2, U11_U_Current_Source3, U11_U_Current_Source4, U12_U_Current_Source1, U12_U_Current_Source2, U12_U_Current_Source3, U12_U_Current_Source4, U15_U_Current_Source1, U15_U_Current_Source2, U15_U_Current_Source3, U15_U_Current_Source4, U17 | DDA0008C_L | CMP-0017-00714-2 | 13 | 0 | 13
MCP1700T-2502E/TT | Low Quiescent Current LDO, 3-Pin SOT-23, Extended Temperature, Tape and Reel | U13 | SOT-23-TT3_M | CMP-0136-00767-1 | 1 | 0 | 1
Adafruit 12V Bias Voltage Boost Converter - TPS61040 |  | U14 | 12V_Suppy | 12V_Supply | 1 | 1 | 0
MCP4012T-503E/CH | Low-Cost 64-Step Volatile Digital POT, 6-Pin SOT-23, Extended Temperature, Tape and Reel | U16_U_Current_Source1, U16_U_Current_Source2, U16_U_Current_Source3, U16_U_Current_Source4, U18 | SOT-23-CH6_M | CMP-0188-00744-2 | 5 | 0 | 5
XTAL |  | X1 | XTAL_Basic | XTAL | 1 | 1 | 0
