tylerwhite26/ECE_455_Brain_Stimulator/Financials/2025-11-21T152101.xlsx

Digi-Key: Shopping Cart
Index | Quantity | Part Number | Manufacturer Part Number | Description | Customer Reference | Available | Backorder | Unit Price | Extended Price USD
1 | 2 | 360-3705-ND | BB16AH-FA | SWITCH PUSH SPDT 0.4VA 28V |  | 2 | 0 | 7.99 | 15.98
2 | 5 | 343-CONBNC002-ND | CONBNC002 | BNC CONNECTOR RIGHT ANGLE JACK, |  | 5 | 0 | 2.05 | 10.25
3 | 2 | EG2362-ND | 100SP1T2B4M6QE | SWITCH TOGGLE SPDT 5A 120V |  | 2 | 0 | 3.95 | 7.90
4 | 4 | HM2380-ND | 108E | AUDIO XFMR 600CT / 3.2 TH |  | 4 | 0 | 30.32 | 121.28
5 | 2 | 497-17240-1-ND | LDL1117S50R | IC REG LINEAR 5V 1.2A SOT-223 |  | 2 | 0 | 0.37 | 0.74
6 | 5 | MCP6S21T-I/MSCT-ND | MCP6S21T-I/MS | IC OPAMP PGA 1 CIRCUIT 8MSOP |  | 5 | 0 | 1.49 | 7.45
7 | 2 | 336-2399-5-ND | SI5351A-B-GT | IC CLOCK GENERATOR 10MSOP |  | 2 | 0 | 2.11 | 4.22
8 | 16 | 296-22997-5-ND | OPA454AIDDA | IC OPAMP GP 1 CIRC 8SOPWRPAD |  | 16 | 0 | 6.573 | 105.17
9 | 2 | MCP1700T-2502E/TTCT-ND | MCP1700T-2502E/TT | IC REG LINEAR 2.5V 250MA SOT23-3 |  | 2 | 0 | 0.51 | 1.02
10 | 7 | MCP4012T-503E/CHCT-ND | MCP4012T-503E/CH | IC DGTL POT 50KOHM 64TAP SOT23-6 |  | 7 | 0 | 0.68 | 4.76
11 | 10 | A119919CT-ND | CPF0402B10RE | RES SMD 10 OHM 0.1% 1/16W 0402 |  | 10 | 0 | 0.144 | 1.44
12 | 10 | 764-FCHP0402E1000BBT1CT-ND | FCHP0402E1000BBT1 | FCHP0402 25PPM 100 OHM 0.1% LEAD |  | 10 | 0 | 1.567 | 15.67
13 | 5 | P158KLCT-ND | ERJ-2RKF1583X | RES SMD 158K OHM 1% 1/10W 0402 |  | 5 | 0 | 0.1 | 0.50
14 | 5 | YAG2956CT-ND | RC0402FR-07115KL | RES 115K OHM 1% 1/16W 0402 |  | 5 | 0 | 0.1 | 0.50
15 | 5 | 311-39.0LRCT-ND | RC0402FR-0739RL | RES 39 OHM 1% 1/16W 0402 |  | 5 | 0 | 0.1 | 0.50
16 | 10 | 541-CRCW040250K0FKEDCT-ND | CRCW040250K0FKED | RES 50K OHM 1% 1/16W 0402 |  | 10 | 0 | 0.04 | 0.40
17 | 15 | 738-RNCF0402BTE40K0CT-ND | RNCF0402BTE40K0 | RES SMD 40K OHM 0.1% 1/10W 0402 |  | 15 | 0 | 0.07 | 1.05
