tylerwhite26/ECE_455_Brain_Stimulator/PCB/Brain_Stim_Final_Layout.step

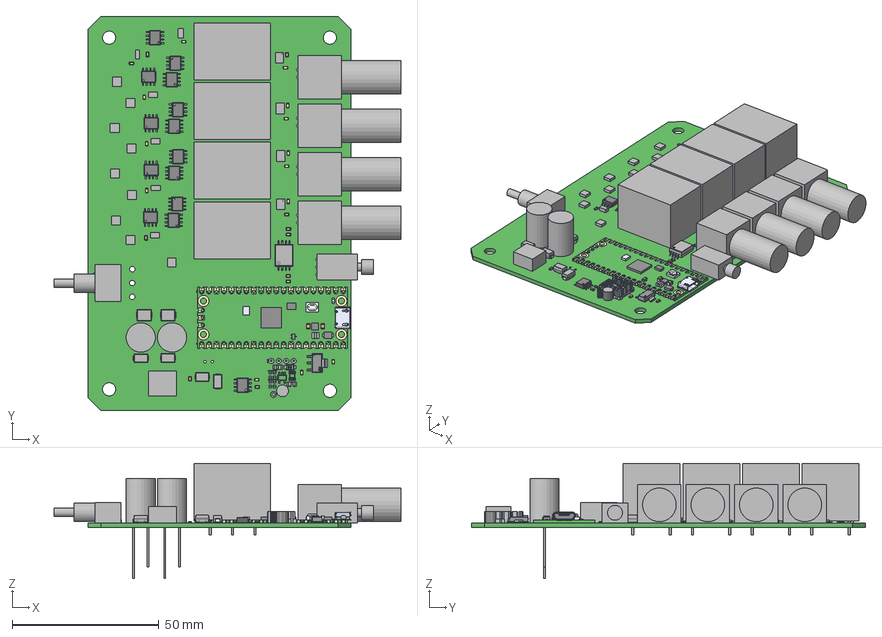
[picture p104: CAD file, 2025-12-03]
PCB/Brain_Stim_Final_Layout.step
118.2 x 134.2 x 39.2 mm
Extruded x 139
DDA0008C x 13
SOIC_LT-S8E-8
Leader x 8
terminals
logo
Thermal Shape x 4
Lead x 12
