tylerwhite26/ECE_455_Brain_Stimulator/PCB/Components/Battery_Charger/Imported Adafruit_TPS61040_Boost_Converter.PrjPcb/Adafruit_TPS61040_Boost_Converter.step

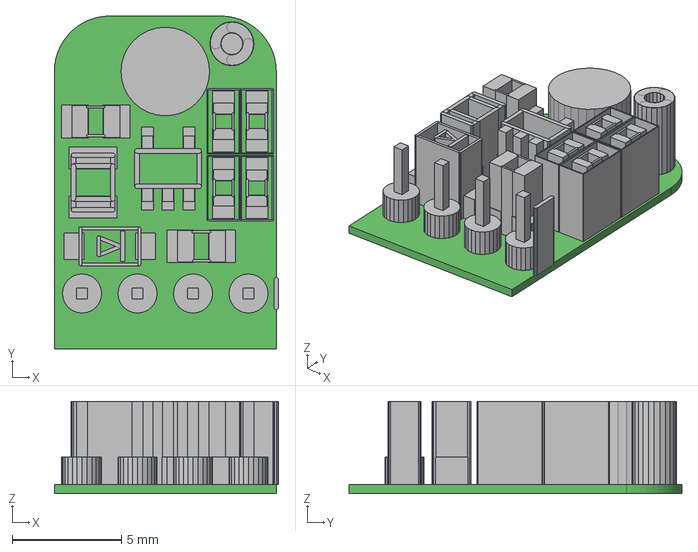
[picture p105: CAD file, 2025-11-12]
PCB/Components/Battery_Charger/Imported Adafruit_TPS61040_Boost_Converter.PrjPcb/Adafruit_TPS61040_Boost_Converter.step
10.3 x 15.2 x 4.22 mm
Extruded x 113
