tylerwhite26/ECE_455_Brain_Stimulator/PCB/Components/BMS/259 USB Lilon Lipoly Charger.step

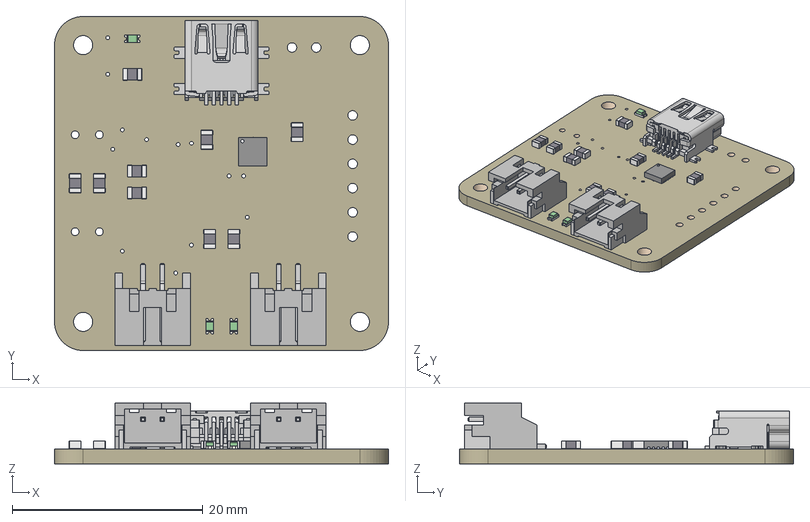
[picture p106: CAD file, 2025-11-12]
PCB/Components/BMS/259 USB Lilon Lipoly Charger.step
35.0 x 35.0 x 6.37 mm
Board
MCP73833T-AMI/MF
USB
LOAD_JST x 2
Power-RED x 3
10uF x 5
PROG
150K x 2
10K/THERM
