tylerwhite26/ECE_455_Brain_Stimulator/PCB/Components/DDS/AltiumDesigner/CP_10_9_ADI.step

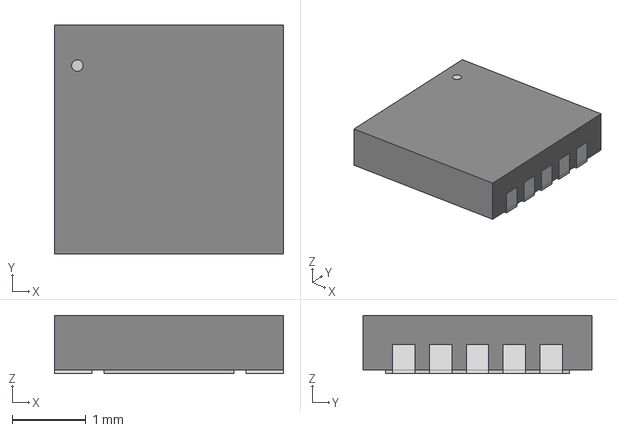
[picture p107: CAD file, 2025-09-17]
PCB/Components/DDS/AltiumDesigner/CP_10_9_ADI.step
3.10 x 3.10 x 0.79 mm
