tylerwhite26/ECE_455_Brain_Stimulator/PCB/Components/Jack/STX-3000_rD3.IGS

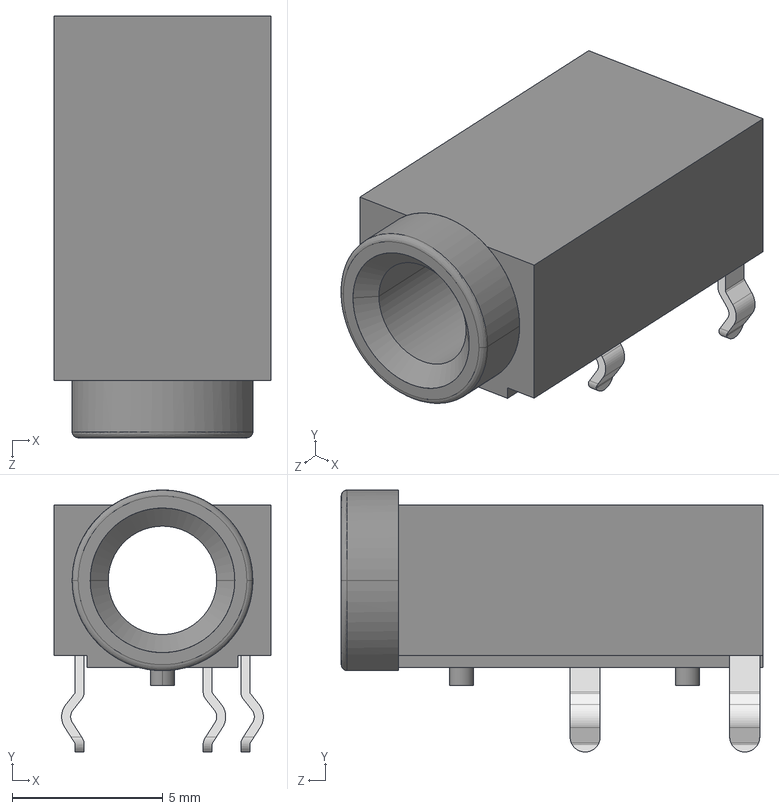
[picture p108: CAD file, 2025-11-05]
PCB/Components/Jack/STX-3000_rD3.IGS
7.20 x 8.70 x 14.0 mm
