tylerwhite26/ECE_455_Brain_Stimulator/PCB/Components/RPI/RASPBERRY PI PICO--3DModel-STEP-269445.STEP

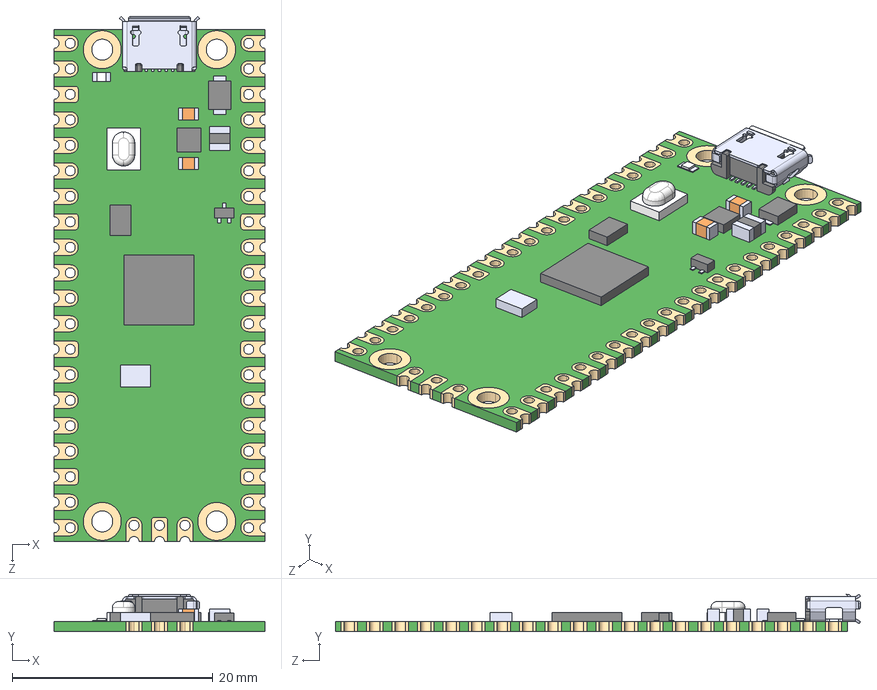
[picture p109: CAD file, 2025-11-05]
PCB/Components/RPI/RASPBERRY PI PICO--3DModel-STEP-269445.STEP
21.0 x 3.73 x 52.3 mm
