tylerwhite26/ECE_455_Brain_Stimulator/(list of files, cad)

Other CAD files:
PCB/Brain_Stimulator/Brain_Stim_Final_Layout.step
PCB/Components/DDS/CP_10_9_ADI.step
PCB/Components/Jack/STX-3000_rD3_1782018533.214.step
