tylerwhite26/ECE_455_Brain_Stimulator/Financials/Reciepts/DDS_Test_Board_$33.15.pdf

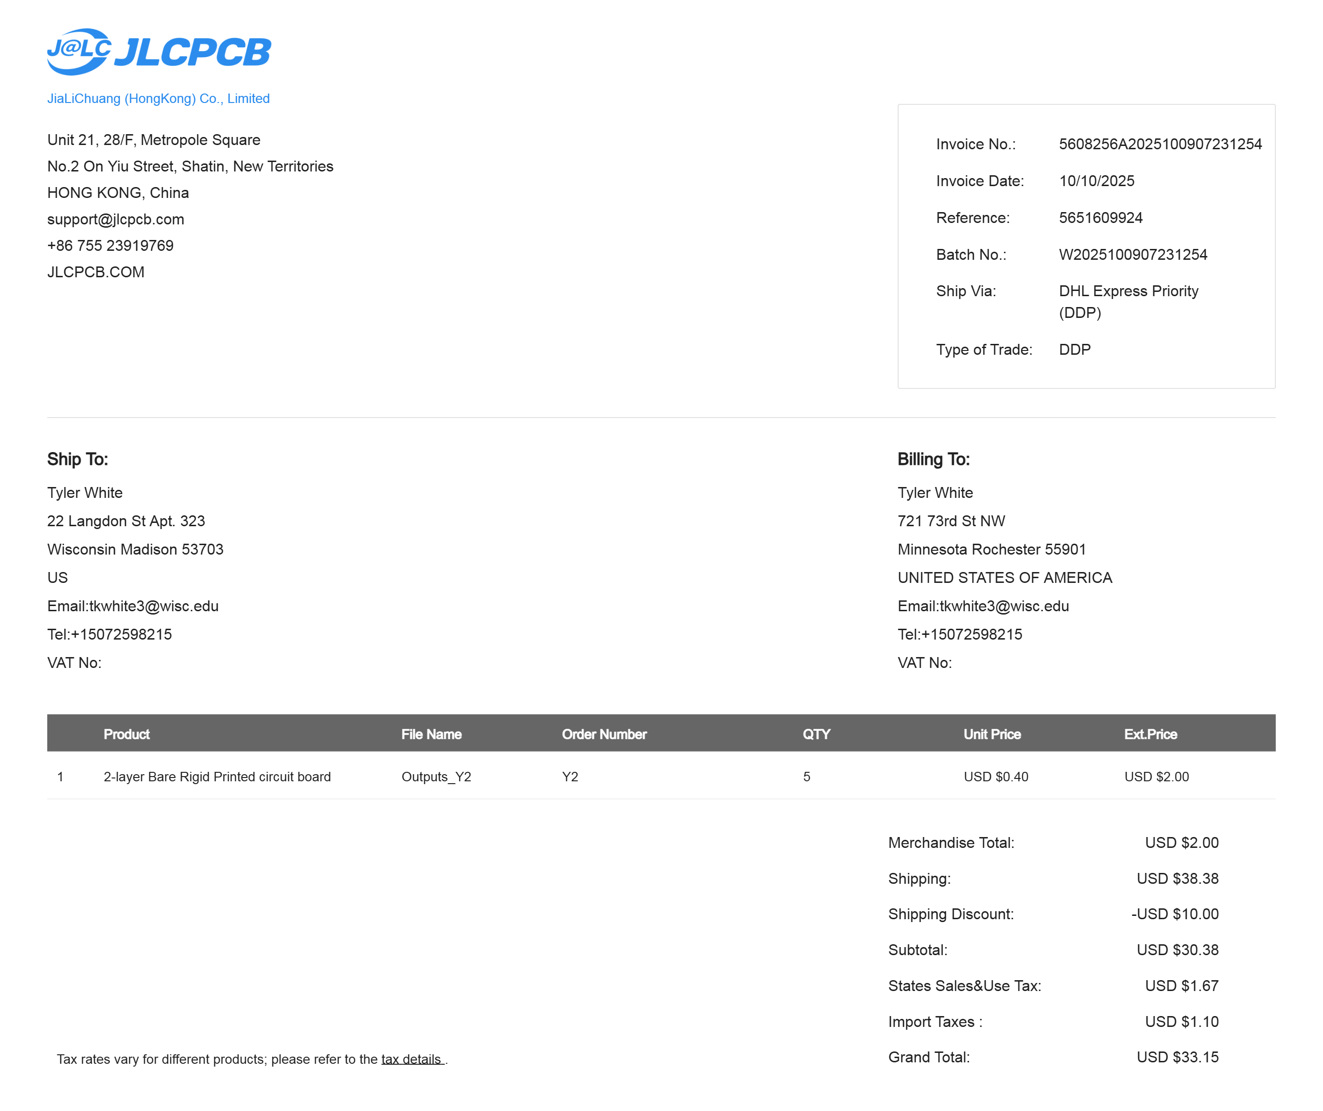
[picture p110: figure]
