tylerwhite26/ECE_455_Brain_Stimulator/Simulation/Current_Source.asc

J1: njf
J2: njf
L1: ind; 470µ
R1: res; 20k
R2: res; 100k
R3: res; 20k
R4: res; 100k
R5: res; 100
R6: res; 10k
R7: res; 100k
R8: res; 50k
R9: res; 50k
R10: res; 10k
U1: UniversalOpAmp
U2: UniversalOpAmp
U3: UniversalOpAmp
V1: voltage; 2.5
V2: voltage; SINE(2.5 2.5 1000)
V3: voltage; 30
V4: voltage; -30
V5: voltage; PWL(0 0 0.01 -2.5)
V6: voltage; SINE(2.5 2.5 1000)
Named nets: 0, SUPPLY, N_SUPPLY, att, mid
.tran 0 10m 0
