tylerwhite26/ECE_455_Brain_Stimulator/Simulation/Current_Source_Simulation.asc

C1: cap; 0.05µ
C2: cap; 50n
R1: res; 10k
R2: res; 10
R3: res; 10k
R4: res; 10k
R5: res; 10
R6: res; 1k
U1: LT1006
U2: LT1102
U3: UniversalOpAmp
U4: UniversalOpAmp
U5: UniversalOpAmp; Avol=1Meg GBW=200000 Vos=0
V1: voltage; 5
V2: voltage; -5
V3: voltage; SINE(0 5 2000)
V4: voltage; 2
V5: voltage; 30
V6: voltage; -30
V7: voltage; SINE(0 5 2000)
V8: voltage; 5
Named nets: 0, +30V, -30V, Inpt_Freq, Const, V+, V-, DDS_Out, temp
.tran 0 2.5m 0
