tylerwhite26/ECE_455_Brain_Stimulator/(list of files, drawings)

Other design files:
PCB/ADC_PCB_Project/ADC_Breakout.PcbDoc
PCB/ADC_PCB_Project/ADC_Breakout.SchDoc
PCB/ADC_PCB_Project/ADC_PCB_Project.PrjPcb
PCB/Brain_Stimulator/ADC_Breakout.PcbDoc
PCB/Brain_Stimulator/Battery_Connections.SchDoc
PCB/Brain_Stimulator/Brain_Stim_Final_Layout.PcbDoc
PCB/Brain_Stimulator/Brain_Stim_Lib.SchLib
PCB/Brain_Stimulator/Brain_Stim_Main.PcbDoc
PCB/Brain_Stimulator/Brain_Stimulator.PrjPcb
PCB/Brain_Stimulator/Curr_Source_Buffer.SchDoc
PCB/Brain_Stimulator/Current_Measure.SchDoc
PCB/Brain_Stimulator/Current_Source.SchDoc
PCB/Brain_Stimulator/DDS_Module.SchDoc
PCB/Brain_Stimulator/Flyback.PcbDoc
PCB/Brain_Stimulator/Flyback.SchDoc
PCB/Brain_Stimulator/Four_DDS.SchDoc
PCB/Brain_Stimulator/Gen_Test.PcbDoc
PCB/Brain_Stimulator/High_Level_Connections.SchDoc
PCB/Brain_Stimulator/MCU.SchDoc
PCB/Brain_Stimulator/Non_Isolated_Sources.SchDoc
PCB/Brain_Stimulator/Output_Isolation.SchDoc
PCB/Brain_Stimulator/PcbLib1.PcbLib
PCB/Brain_Stimulator/PGA_Block.SchDoc
PCB/Brain_Stimulator/Programmable_Gain_Amp.SchDoc
PCB/Brain_Stimulator/Small_DDS.SchDoc
PCB/Brain_Stimulator/Small_DDS_Breakout.PcbDoc
PCB/Brain_Stimulator/Stimulus_Feedback.SchDoc
PCB/Brain_Stimulator/Table_of_Contents.SchDoc
PCB/Components/Battery_Charger/Imported Adafruit_TPS61040_Boost_Converter.PrjPcb/Adafruit_TPS61040_Boost_Converter.PcbDoc
PCB/Components/Battery_Charger/Imported Adafruit_TPS61040_Boost_Converter.PrjPcb/Adafruit_TPS61040_Boost_Converter.PrjPcb
PCB/Components/Battery_Charger/Imported Adafruit_TPS61040_Boost_Converter.PrjPcb/Adafruit_TPS61040_Boost_Converter.SchDoc
PCB/Components/BMS/Imported Adafruit MicroLipo Charger v2.PrjPcb/Adafruit MicroLipo Charger v2.PcbDoc
PCB/Components/BMS/Imported Adafruit MicroLipo Charger v2.PrjPcb/Adafruit MicroLipo Charger v2.PrjPcb
PCB/Components/DDS/AltiumDesigner/AD9837ACPZ-RL.PcbLib
PCB/Components/DDS/AltiumDesigner/AD9837ACPZ-RL.SchLib
PCB/Components/RPI/RASPBERRY_PI_PICO1/RASPBERRY_PI_PICO.PcbLib
PCB/Components/RPI/RASPBERRY_PI_PICO1/RASPBERRY_PI_PICO.SchLib
PCB/Components/RPI/RASPBERRY_PI_PICO2/RASPBERRY_PI_PICO.PcbLib
PCB/Components/RPI/RASPBERRY_PI_PICO2/RASPBERRY_PI_PICO.SchLib
PCB/Components/RPI/RASPBERRY_PI_PICO/RASPBERRY_PI_PICO.PcbLib
PCB/Components/RPI/RASPBERRY_PI_PICO/RASPBERRY_PI_PICO.SchLib
