tylerwhite26/ECE_455_Brain_Stimulator/PCB/Components/Battery_Charger/Adafruit_TPS61040_Boost_Converter.brd

## EAGLE design PCB/Components/Battery_Charger/Adafruit_TPS61040_Boost_Converter.brd (2025-11-12)

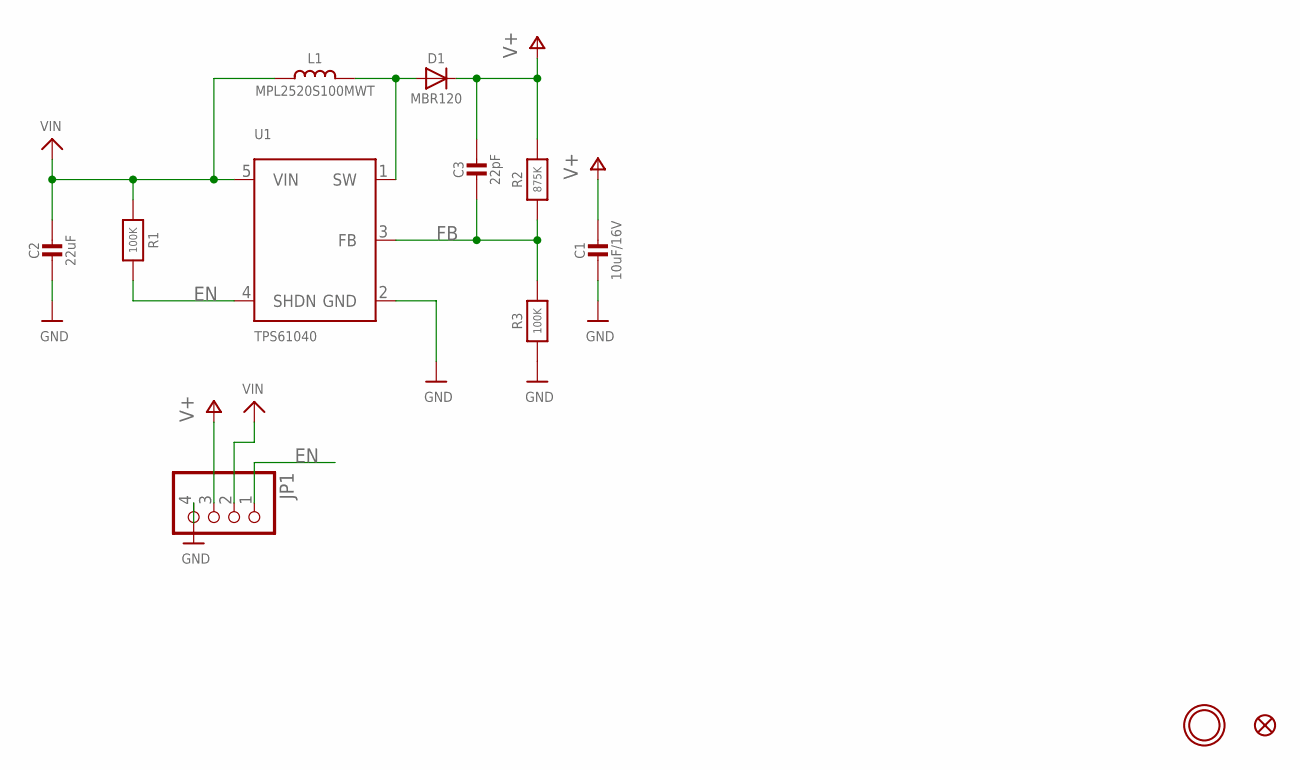
[picture p111: schematic Adafruit_TPS61040_Boost_Converter.sch]

Parts:
C1: 10uF/16V; 0805-NO
C2: 22uF; 0805-NO
C3: 22pF; 0603-NO
D1: MBR120; SOD-123FL
FID1: FIDUCIAL_1MM
JP1: HEADER-1X4ROUND; 1X04_ROUND
L1: MPL2520S100MWT; INDUCTOR_1007
R1, R3: 100K; 0603-NO
R2: 875K; 0603-NO
U1: TPS61040; SOT23-5
U$9: MOUNTINGHOLE2.5; MOUNTINGHOLE_2.5_PLATED

Connections:
EN: JP1.1, R1.2, U1.4 (SHDN)
FB: C3.2, R2.1, R3.2, U1.3 (FB)
GND: C1.2, C2.2, JP1.4, R3.1, U1.2 (GND)
unnamed: D1.A, L1.P$2 (2), U1.1 (SW)
V+: C1.1, C3.1, D1.C, JP1.3, R2.2
VIN: C2.1, JP1.2, L1.P$1 (1), R1.1, U1.5 (VIN)

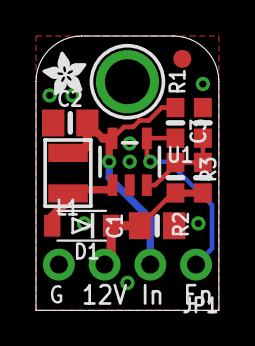
[picture p112: board Adafruit_TPS61040_Boost_Converter.brd from above]

Board: 2 copper layers, 10.2 x 15.2 mm, 14 parts (1 on the bottom side), 6 nets.

Other parts of the board:
U$10: PCBFEAT-REV-040
U$11: ADAFRUIT_2.5MM
