tylerwhite26/ECE_455_Brain_Stimulator/PCB/Components/BMS/Adafruit MicroLipo Charger v2.brd

## EAGLE design PCB/Components/BMS/Adafruit MicroLipo Charger v2.brd (2025-11-12)

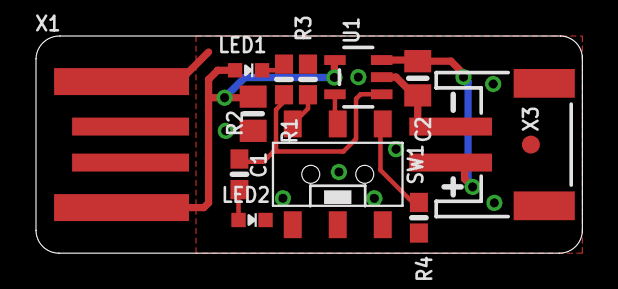
[picture p113: board Adafruit MicroLipo Charger v2.brd from above]

Board: 2 copper layers, 30.4 x 12.1 mm, 27 parts (5 on the bottom side), 9 nets.

Parts:
C1, C2: 10uF; 0805-NO
FID1: FIDUCIAL_1MM
LED1: RED; CHIPLED_0603_NOOUTLINE
LED2: GREEN; CHIPLED_0603_NOOUTLINE
PLABEL0: PLABEL0
PLABEL1: PLABEL1
PLABEL2: PLABEL2
PLABEL3: PLABEL3
PLABEL4: PLABEL4
PLABEL5: PLABEL5
PLABEL6: PLABEL6
PLABEL7: PLABEL7
PLABEL8: PLABEL8
PLABEL9: PLABEL9
PLABEL10: PLABEL10
PLABEL11: PLABEL11
R1, R4: 2K; 0603-NO
R2, R3: 10K; 0603-NO
SW1: DPDT Switch; EG1390
U1: MCP73831T-2ACI/OT; SOT23-5
U$8: ADAFRUIT_TEXT_20MM
U$9: PCBFEAT-REV-040
X1: PCBUSB; USBA_PCB
X3: CON_JST_PH_2PIN_MT_BATT; JSTPH2_BATT

Connections:
GND: C1.2, C2.2, LED2.C, R3.2, R4.2, SW1.O1, SW1.P1, SW1.S1, U1.2, X1.GND, X3.1, X3.NC1, X3.NC2
unnamed: LED1.C, R1.1
unnamed: R1.2, R2.2, U1.1
unnamed: R3.1, SW1.S2
unnamed: R4.1, SW1.O2
unnamed: SW1.P2, U1.5
unnamed: LED2.A, R2.1
VBAT: C2.1, U1.3, X3.2
VDD: C1.1, LED1.A, U1.4, X1.VCC
