tylerwhite26/ECE_455_Brain_Stimulator/(commit log)

2025-09-12 Added GANTT and quick sim of current source
2025-09-17 presentation and spice sim
    [AD9837ACPZ-RL.PcbLib, AD9837ACPZ-RL.SchLib, Brain_Stim_Lib.SchLib, CP_10_9_ADI.step, Iso_Current_Source.SchDoc, Table_of_Contents.SchDoc]
2025-09-24 Made circuitry for dds
    [Brain_Stim_Lib.SchLib, Brain_Stimulator.PrjPcb, Current_Measure.SchDoc, DDS_Module.SchDoc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]
2025-09-24 Adding more to the schematics and libraries
    [Brain_Stim_Lib.SchLib, Current_Measure.SchDoc, High_Level_Connections.SchDoc, MCU.SchDoc, PcbLib1.PcbLib, Table_of_Contents.SchDoc]
2025-10-01 catching up
    [Brain_Stim_Lib.SchLib, Current_Measure.SchDoc, DDS_Module.SchDoc, High_Level_Connections.SchDoc, MCU.SchDoc, Non_Isolated_Sources.SchDoc, PcbLib1.PcbLib, Table_of_Contents.SchDoc]
2025-10-01 week 5 presentation
    [Current_Measure.SchDoc, High_Level_Connections.SchDoc, MCU.SchDoc]
2025-10-01 Made schematics prettier
    [Brain_Stim_Lib.SchLib, Brain_Stimulator.PrjPcb, Current_Measure.SchDoc, DDS_Module.SchDoc, High_Level_Connections.SchDoc, MCU.SchDoc, Non_Isolated_Sources.SchDoc, PcbLib1.PcbLib]
2025-10-08 week 6
    [Programmable_Gain_Amp.SchDoc]
2025-10-10 schematic improvements
    [DDS_Module.SchDoc, High_Level_Connections.SchDoc, Non_Isolated_Sources.SchDoc, PGA_Block.SchDoc, Programmable_Gain_Amp.SchDoc]
2025-10-15 Week 7 presentation
    [Brain_Stimulator.PrjPcb, Programmable_Gain_Amp.SchDoc]
2025-10-15 Added Guandong stuff to presentation 7
    [Programmable_Gain_Amp.SchDoc, Table_of_Contents.SchDoc]
2025-10-15 Added financial tracking information
    [Cost_Tracking.xlsx, Output_Isolation.SchDoc, Programmable_Gain_Amp.SchDoc]
2025-10-15 Added transformers
    [Brain_Stim_Lib.SchLib, Brain_Stimulator.PrjPcb, Output_Isolation.SchDoc, PcbLib1.PcbLib, Stimulus_Feedback.SchDoc, Table_of_Contents.SchDoc]
2025-10-22 Updated schematics and week 8 pres
    [Brain_Stimulator.PrjPcb, Current_Measure.SchDoc, High_Level_Connections.SchDoc, Non_Isolated_Sources.SchDoc, Output_Isolation.SchDoc, Stimulus_Feedback.SchDoc]
2025-10-22 added adc breakout board
    [ADC_Breakout.PcbDoc]
2025-10-22 changes to crystal on dds board
    [Brain_Stimulator.PrjPcb, DDS_Module.SchDoc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]
2025-10-23 made outputs for ADC breakout work
    [ADC_Breakout.GBL, ADC_Breakout.GBO, ADC_Breakout.GBP, ADC_Breakout.GBS, ADC_Breakout.GKO, ADC_Breakout.GM1, ADC_Breakout.GTL, ADC_Breakout.GTO]
2025-10-29 new pres
    [DDS_Module.SchDoc, High_Level_Connections.SchDoc, MCU.SchDoc, Small_DDS.SchDoc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]
2025-11-05 week 10 presentation
    [Battery_Connections.SchDoc, Brain_Stim_Lib.SchLib, Brain_Stim_Main.PcbDoc, Brain_Stimulator.PrjPcb, DDS_Module.SchDoc, Flyback.PcbDoc, Flyback.SchDoc, Four_DDS.SchDoc]
2025-11-12 General board routing
    [259 USB Lilon Lipoly Charger.step, Adafruit MicroLipo Charger v2.PcbDoc, Adafruit MicroLipo Charger v2.PrjPcb, Adafruit MicroLipo Charger v2.brd, Adafruit_TPS61040_Boost_Converter.PcbDoc, Adafruit_TPS61040_Boost_Converter.PrjPcb, Adafruit_TPS61040_Boost_Converter.SchDoc, Adafruit_TPS61040_Boost_Converter.brd]
2025-11-12 Week 11 presentation
    [Battery_Connections.SchDoc, Brain_Stim_Main.PcbDoc, Four_DDS.SchDoc, High_Level_Connections.SchDoc, PcbLib1.PcbLib]
2025-11-15 Rough final schematics
    [Brain_Stimulator.PrjPcb, Curr_Source_Buffer.SchDoc, Current_Measure.SchDoc, Current_Source.SchDoc, High_Level_Connections.SchDoc, MCU.SchDoc, Non_Isolated_Sources.SchDoc, PGA_Block.SchDoc]
2025-11-19 Final Board Layout
    [Battery_Connections.SchDoc, Brain_Stim_Final_Layout.PcbDoc, Brain_Stim_Lib.SchLib, Brain_Stim_Main.PcbDoc, Curr_Source_Buffer.SchDoc, Current_Source.SchDoc, Flyback.SchDoc, High_Level_Connections.SchDoc]
2025-11-19 Week 12 presentation
    [Brain_Stimulator.PrjPcb, MCU.SchDoc]
2025-12-03 PCB stuff
    [2025-11-21T152101.xlsx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]
2025-12-08 Final poster
    [Brain_Stimulator.PrjPcb]
